dicarlantoniooctavio-create/carpinteria-vortex/README.md

# Vortex · Instalación eléctrica de una carpintería

Proyecto final: la instalación eléctrica de un taller de carpintería de 312 m², hecha por la empresa Vortex.

**Página web del proyecto:** https://dicarlantoniooctavio-create.github.io/carpinteria-vortex/PRINCIPAL/04_Web/index.html

**Página de la empresa:** https://dicarlantoniooctavio-create.github.io/carpinteria-vortex/PRINCIPAL/08_Web_Empresa/index.html

## Qué hay en cada carpeta

| Carpeta | Contenido |
|---|---|
| `PRINCIPAL/04_Web/` | La página web del proyecto |
| `PRINCIPAL/08_Web_Empresa/` | La página web de la empresa |
| `PRINCIPAL/05_Presentacion/` | Presentación animada (abrir el `.html` en el navegador) |
| `PRINCIPAL/02_Informe_Integrador/` | Informe técnico en PDF y Word |
| `PRINCIPAL/06_Planillas/` | Planillas de cálculo (Excel) |
| `PRINCIPAL/01_Proyecto_Organizado/` | Planos, cálculos y tableros (multifilares, topográficos y unifilar) |
| `PRINCIPAL/07_Video_Vortex_15s/` | Video de presentación de 15 s |
| `tableros.electricos/` | Unifilar y multifilar del equipo (AutoCAD), topográficos de CADe SIMU (tableros y automatismo) |
| `planos/` | Plano del local y unifilar en AutoCAD |
| `excels.important/` | Planillas originales del equipo |
| `3D.chonchons.beta/` | Modelo 3D de la lijadora de banda: versión nueva en FreeCAD (`freecad/`) y la primera en SolidWorks (`Solid/`) |

## Datos principales

- Alimentación 3 × 380 / 220 V + N, cable 4 × 35 mm² + PE 16 mm², general GE Hti 4P 80 A en el T.P.
- **T.S. Oficina** (entrada 4P 25 A): TUE1 aire en R; IUG1 y TUG1 en S.
- **T.S. Taller** (entrada GE Hti 4P 80 A, línea 4 × 35 mm²): TUE2 compresor en R; IUG2 en S; IUG3 y TUG2 en T; seis máquinas de 380 V detrás de un diferencial 4P 63 A, cada una con su térmica 4P.
- Fases con todo andando: R 61,56 A · S 63,11 A · T 62,19 A. DPMS 41.029 VA.
- Presupuesto: USD 15.419,83 con IVA (precios de referencia).
