dicarlantoniooctavio-create/carpinteria-vortex/PRINCIPAL/README.md

# Entrega final — Carpintería Industrial (Vortex)

La copia del proyecto reúne el informe técnico, perfil de empresa, web, presentación, planillas y video.

## Datos actualizados

- Alimentación 3 × 380/220 V + N; interruptor general GE Hti 4P 80 A curva C 6 kA. Línea al T.S. Taller: 4 × 35 mm² + PE 16 mm² (Iz 96 A).
- T.S. Oficina: entrada 4P 25 A. TUE1 aire acondicionado, fase R, 10 A; IUG1 fase S, 1,38 A y 4 A; TUG1 fase S, 14,55 A y 16 A.
- T.S. Taller: entrada GE Hti 4P 80 A. IUG2 6 A, IUG3 6 A, TUG2 tomas del taller, TUE2 compresor 2 (8,47 A).
- Máquinas trifásicas: 43,09 A por fase. Compresor 1 calculado en 11,02 A; guardamotor 9–14 A, pendiente de confirmar con placa.
- Fases: R 61,56 A; S 63,11 A; T 62,19 A. DPMS 41.029 VA; IMS 63,11 A.
- Lijadora: 4.754 × 919 × 2.220 mm; ruedas Ø600 × 150 mm, entre ejes 4.000 mm; banda 150 mm y 9.885 mm de desarrollo, 25,5 m/s; motor 4 HP (3 kW), 4 gatos de 2,5 t y chumaceras UCP212.
- Presupuesto final: materiales USD 8.397,80; mano de obra USD 2.939,23; ingeniería USD 839,78; imprevistos USD 566,85; IVA USD 2.676,17; total USD 15.419,83. Contado: USD 14.648,84. Anticipo 40 %: USD 6.167,93; dos hitos de 30 %: USD 4.625,95 cada uno. Plan en cuotas: anticipo USD 4.625,95 y seis cuotas de USD 1.942,90; total financiado USD 16.283,35.
