dicarlantoniooctavio-create/carpinteria-vortex/PRINCIPAL/01_Proyecto_Organizado/automatizacion/README.md

# Automatización de Máquinas



Lógica de mando y control de la máquina: arranque directo de un motor trifásico con enclavamiento, mediante contactor comandado por pulsadores de marcha y paro, más protección térmica.

## Topográficos nuevos (noviembre 2026)

El equipo rehizo el automatismo en dos topográficos de CADe SIMU, en `esquemas/`:

| Archivo | Motor | Componentes |
|---|---|---|
| `topograficoMonofasico.cad` (imagen `automatismo_monofasico.png`) | Monofásico (U1, V1, PE) | Q1, Q2, KM1, F1, S1 parada, S2 marcha, H1, bornera X |
| `topograficoTrifasico.cad` (imagen `automatismo_trifasico.png`) | Trifásico (U1, V1, W1, PE) | Q1, Q2, KM1, F1, S1 parada, S2 marcha, H1, bornera X |

Los dos son un arranque directo con autorretención: S2 energiza KM1, su contacto auxiliar lo mantiene, S1 lo corta y F1 (95-96) abre el mando si el motor se sobrecarga. Lo que sigue es la versión anterior.

## Archivos 

| Archivo | Contenido | Estado |
|---|---|---|
| `Automatismo.cad` (CADe SIMU) | Esquema de **mando** (circuito de control) y **potencia** (circuito de fuerza) del arranque directo. [Ver](https://github.com/Tpskevin13/carpinteria/releases/tag/Automatismo)|  Revisado y correcto |
| `Topografico.cad` (CADe SIMU) | Vista topográfica: disposición física de los componentes en el tablero.  [Ver](https://github.com/Tpskevin13/carpinteria/releases/tag/Topografico) |  Revisado y correcto |

> Los `.cad` son archivos de proyecto de CADe SIMU. Las imágenes exportadas (BMP/PNG) permiten que cualquiera vea el esquema sin instalar el programa.

## Circuito de mando (control)

- **`-Q`**: guardamotor/disyuntor — protección del circuito de mando.
- **`-E`**: contacto NC del relé térmico/guardamotor — corta el circuito si el motor se sobrecarga.
- **`-P`**: botón de **paro** (NC), en serie.
- **`-S`**: botón de **marcha** (NA), en paralelo con el contacto auxiliar 13-14 de `-K` (enclavamiento/retención: una vez que arranca, se mantiene solo aunque se suelte el botón).
- **`-K`**: bobina del contactor (A1-A2).

Orden de la lógica: protección → paro → marcha con enclavamiento → bobina. Correcto.

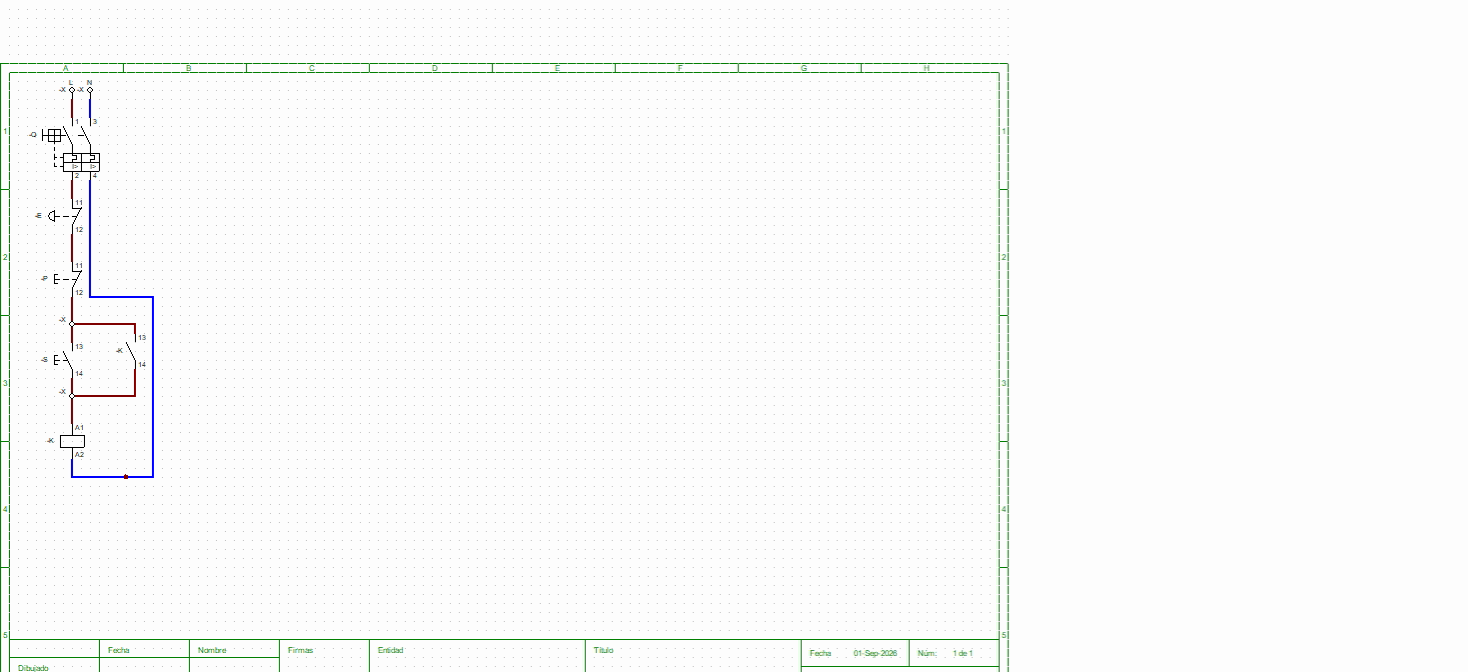
[picture p1: PRINCIPAL/01_Proyecto_Organizado/automatizacion/esquemas/CircutoDeMando.png]
Foto de referencia.


[Ver](https://github.com/Tpskevin13/carpinteria/releases/tag/CircuitoDeMando)

## Circuito de potencia (fuerza)

- **`-Q`** (guardamotor, 3 polos) → **`-K`** (contactos principales del contactor, 3 polos) → motor (**U1, V1, W1, PE**).

El guardamotor es un único dispositivo físico: sus contactos de potencia (3 polos) van en el circuito de fuerza, y su contacto auxiliar NC (`-E`) va en el circuito de mando.

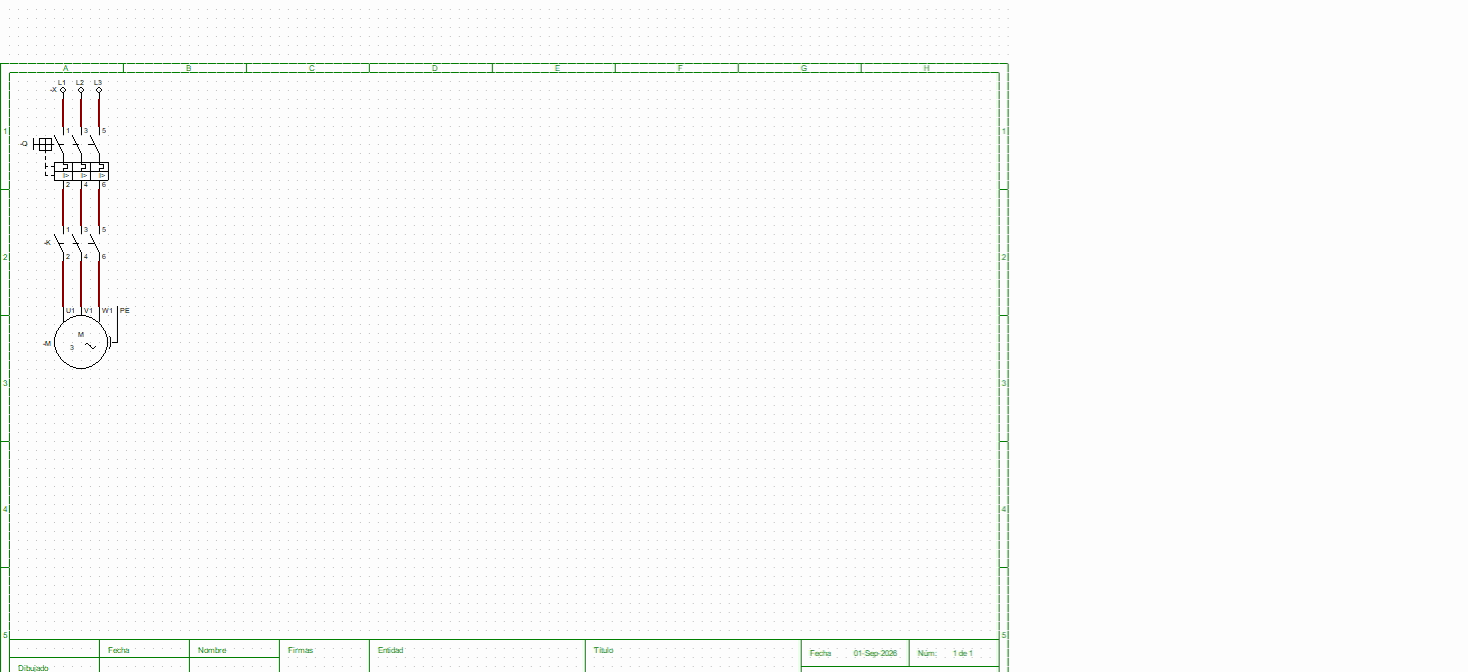
[picture p2: PRINCIPAL/01_Proyecto_Organizado/referencias/fotos/Circuitodepotencia.png]
Foto de referncia.


[Ver](https://github.com/Tpskevin13/carpinteria/releases/tag/CircuitoDePotencia)
