dicarlantoniooctavio-create/carpinteria-vortex/PRINCIPAL/01_Proyecto_Organizado/iluminacion/README.md

# Iluminación

Diseño lumínico del taller: cálculo de la cantidad de luminarias necesarias según la normativa/nivel de lux recomendado para trabajo de carpintería, y su distribución en planta.

## Contenido a subir

- **`calculos/`**
  - Método de los lúmenes (o el que definan): superficie del local, nivel de iluminancia (lux) requerido para taller de carpintería, flujo luminoso de la luminaria elegida, factor de mantenimiento y utilización → cantidad de luminarias.
  - Justificar el nivel de lux elegido (suele haber tablas de referencia según tipo de tarea: zona de máquinas necesita más lux que zonas de circulación/depósito).
- **`planos/`**
  - Distribución de luminarias en planta (separación entre ellas, altura de montaje).
  - Circuito eléctrico de iluminación (a qué llave térmica del tablero corresponde — vincular con `instalacion-electrica/`).

## Qué definimos

- Superficie: 312 m² en total; la carpintería ocupa 12 × 21 = 252 m².
- Luminarias: 19 campanas LED IP65 de 100 W (9000 lm) en el taller, 7 paneles LED de 40 W en negocio y oficina y 2 lámparas LED de 12 W en cocina y baño: 28 bocas en el plano.
- Circuitos: IUG1 (T.S. Oficina, 304 W, 1,38 A, térmica GE G62C04 de 4 A) e IUG2 / IUG3 (T.S. Taller, 9 y 10 campanas de 100 W: 4,09 A y 4,55 A, térmica GE G62C06 de 6 A).
