dicarlantoniooctavio-create/carpinteria-vortex/PRINCIPAL/01_Proyecto_Organizado/tablero/README.md

# Tablero Eléctrico

Diseño del tablero general (y seccionales si corresponde) que alimenta a toda la carpintería: máquinas, iluminación y tomacorrientes.

## Contenido a subir

- **`planos/`**
  - Plano unifilar del tablero (interruptor general, térmicas/diferenciales por circuito).
  - Distribución física dentro del gabinete (dónde va cada elemento).
- `memoria-tablero.md`:
  - Interruptor termomagnético general (calibre según la potencia total instalada — sale de `instalacion-electrica/`).
  - Interruptor diferencial (protección de personas).
  - Una llave térmica por circuito: una o más para máquinas (fuerza motriz), una para iluminación, una para tomas de uso general.
  - Marca/modelo de referencia de los elementos elegidos (Schneider, ABB, Siemens, etc. — lo que usen de referencia).

## Relación con otras carpetas

- Las corrientes y calibres salen del cálculo en [`instalacion-electrica/calculos`](../instalacion-electrica/calculos).
- El circuito de mando de la máquina automatizada (contactor, pulsadores) se conecta a través de una de las llaves térmicas de este tablero — documentarlo en [`automatizacion/`](../automatizacion).

## Qué definimos

- 7 circuitos de 220 V y 6 máquinas de 380 V.
- Un tablero principal (T.P., general GE Hti 4P 80 A) y dos seccionales: T.S. Oficina (entrada G64C25) y T.S. Taller (entrada GE Hti 4P 80 A, diferencial BPC463 para las máquinas).
- El mando de cada máquina es un arranque directo: ver los topográficos de `automatizacion/esquemas/` (motor monofásico y trifásico). `planos/tablero.maquinas.esim` es la versión vieja del simulador.
