dicarlantoniooctavio-create/carpinteria-vortex/2-proyecto-por-area/referencias/recursos/README.md

# Layout, Dimensiones e Instalación Eléctrica - Carpintería

## 1. Dimensiones Generales y Resumen de Superficie
* **Largo total:** 12.00 m
* **Ancho total:** 10.00 m
* **Altura libre útil:** 4.00 m (recomendado para manipulación de tableros enteros)
* **Superficie total:** **120.00 m²**

---

## 2. Distribución de Áreas y Zonificación

| Zona / Área | Dimensiones (m) | Superficie (m²) | Descripción y Equipamiento Principal |
| :--- | :--- | :--- | :--- |
| **Corte y Maquinaria Pesada** | 8.00 x 5.00 | 40.00 m² | Escuadradora, tupí, garlopa, cepilladora, sierra de cinta |
| **Banco de Trabajo y Ensamblado** | 6.00 x 5.00 | 30.00 m² | Bancos de carpintero, ensamblado de estructuras, prensas |
| **Lijado y Preparación** | 3.00 x 5.00 | 15.00 m² | Lijadoras orbitales, lijadora de banda, calibradora |
| **Acabado y Barnizado** | 3.00 x 5.00 | 15.00 m² | Cabina de pintura con extracción e iluminación anti-explosiva |
| **Almacén de Madera / Tableros** | 4.00 x 3.00 | 12.00 m² | Estanterías cantiléver para tableros (2.75 x 1.83 m) y listones |
| **Oficina y Sanitario** | 4.00 x 2.00 | 8.00 m² | Control administrativo, baño y vestuario de personal |

---

## 3. Requerimientos de Instalación Eléctrica

### Suministro y Potencia General
* **Acometida:** Trifásica (380V + Neutro + Tierra / 50 Hz).
* **Potencia estimativa contratada:** 15 a 22 kW (para absorber picos de arranque de motores trifásicos simultáneos).
* **Puesta a Tierra (PAT):** Jabalina de cobre de 2.40 m con cable de protección verde/amarillo (mínimo 10 mm²) independiente para descargar electricidad estática de la viruta.

### Tablero General de Distribución (TGD)
* Interruptor General Automático (IGA) con corte omnipolar.
* Disyuntores diferenciales de alta sensibilidad (30 mA) por cada sector.
* Guardamotor / Térmicas individuales calibradas para cada máquina pesada.
* Contactor de maniobra interconectado con circuito de paradas de emergencia.

### Tomas de Fuerza Motriz (380V Trifásico)
* **Escuadradora:** Toma industrial 3P+N+T 16A (Motor ~5.5 HP / 4 kW).
* **Garlopa / Cepilladora:** Toma industrial 3P+N+T 16A (Motor ~4 HP / 3 kW).
* **Tupí de banco:** Toma industrial 3P+N+T 16A (Motor ~4 HP / 3 kW).
* **Aspirador Central de Polvo / Viruta:** Circuito directo trifásico (Motor ~5.5 HP / 4 kW) con encendido automático en paralelo a la máquina en uso.

### Tomas Monofásicas (220V - Herramientas Manuales)
* **Bajadas Aéreas (Techo):** 6 tomacorrientes colgantes reforzados tipo "retráctil" sobre la zona de bancos para mantener el suelo libre de cables.
* **Tomas Perimetrales IP54:** Tomas dobles estancas con tapa a 1.20 m del suelo, distribuidas cada 3 metros en las paredes del taller.

### Iluminación y Seguridad
* **Iluminación General Taller:** Campanas o herméticos LED IP65 (500 lux requeridos en área de corte y bancos; 300 lux en depósitos).
* **Zona de Acabado/Barnizado:** Envolventes y luminarias antideflagrantes (Atex) para polvos y vapores de solventes inflamables.
* **Seguridad:** 4 pulsadores tipo "seta" de parada de emergencia distribuidos en paredes, interconectados a la bobina de disparo del tablero general.
