dicarlantoniooctavio-create/carpinteria-vortex/PRINCIPAL/01_Proyecto_Organizado/docs/README.md

# Documentación General

- `memoria-descriptiva.md`: qué es la carpintería, alcance del proyecto, objetivos.
- `cronograma.md`: tareas, responsables y fechas de entrega de cada etapa.
- `presentacion-final.md` o `.pdf`: material para la defensa/exposición del proyecto.
