dicarlantoniooctavio-create/carpinteria-vortex/PRINCIPAL/06_Planillas/FUNCIONAMIENTO MAQUINAS.docx

LIJADORA DE BANDA

Funcionamiento: La lijadora de banda es una máquina herramienta que funciona con un motor eléctrico que hace girar dos rodillos. Estos mueven una banda de lija de forma continua. Al apoyar la pieza sobre la banda en movimiento, el material se desgasta por fricción, lo que permite desbastar, alisar y quitar rebabas o imperfecciones en piezas de madera o metal.

ESCUADRADORA

Funcionamiento: Es una máquina herramienta que utiliza un disco de sierra circular accionado por un motor eléctrico para cortar madera en línea recta. La pieza se apoya sobre una mesa y se guía el material mediante una regla o guía para realizar cortes precisos, rectos y en ángulo. Se utiliza principalmente para cortar tableros y piezas de madera a las medidas deseadas.

SIERRA SIN FIN

Funcionamiento: Es una máquina herramienta que funciona mediante una cinta metálica dentada y continua, que se desplaza alrededor de dos volantes accionados por un motor eléctrico. Los dientes de la cinta cortan el material al entrar en contacto con el. Se utiliza para realizar cortes rectos y curvos en madera o metal, según el tipo de máquina y hoja.

SIERRA COMBINADA

Funcionamiento: La sierra combinada es una máquina herramienta que combina dos sistemas de corte, generalmente una sierra circular y una sierra sin fin. Funciona mediante un motor eléctrico que acciona el mecanismo de corte. Se utiliza para realizar diferentes tipos de cortes en madera, como cortes rectos y curvos, según el sistema utilizado.

TUPI

Funcionamiento: La tupi es una máquina herramienta utilizada principalmente para trabajar la madera. Funciona mediante un motor eléctrico que hace girar un eje con una herramienta de corte a gran velocidad. La pieza se desplaza de forma controlada contra la herramienta, que elimina material y le da la forma deseada. Se utiliza para realizar ranuras, molduras, rebajes y dar forma a los bordes de las piezas.
