dicarlantoniooctavio-create/carpinteria-vortex/PRINCIPAL/01_Proyecto_Organizado/empresa/README.md

# Vortex

<p align="center">
  Logo TKVK Bordado
</p>

## ¿Quiénes somos?

Vortex es una empresa de servicios técnicos especializada en **instalaciones eléctricas, automatismo y seguridad de máquinas**, además de **mantenimiento de instalaciones y máquinas**. Este repositorio documenta un proyecto estudiantil aplicado a un caso real: una carpintería, donde Vortex interviene diseñando su instalación eléctrica, el automatismo de una de sus máquinas y su iluminación.

## Equipo

| Integrante | Rol en el proyecto |
|---|---|
| Kevin Dibella |Técnico especialista en instalaciones eléctricad.|
| Octavio Di Carlantonio |Marketing. |
| Lucio Di Carlantonio |técnico en mantenimiento eh higiene.|
| Agustín Duarte |Diseñador Gráfico y modelado 3D.|

## Rubro y servicios

- Instalaciones eléctricas (industriales/comerciales).
- Automatismo de máquinas y procesos.
- Seguridad de máquinas (paradas de emergencia, protecciones, resguardos).
- Mantenimiento de instalaciones eléctricas y de máquinas.

## Misión y visión

- **Misión:** Vortex nace como una empresa creada específicamente para este proyecto estudiantil de la carpintería, con el objetivo de aplicar en un caso real los conocimientos de instalaciones eléctricas, automatismo y seguridad de máquinas del equipo.
- **Visión:** Terminar este proyecto de forma correcta y prolija, convirtiéndolo en una de las mejores entregas posibles, y sentar las bases para que el mismo equipo de integrantes pueda encarar juntos otros proyectos en el futuro.
