dicarlantoniooctavio-create/carpinteria-vortex/PRINCIPAL/01_Proyecto_Organizado/docs/cronograma.md

# Cronograma del Proyecto

| Etapa | Tarea | Responsable | Estado |
|---|---|---|---|
| 1 | Definir máquina a modelar y relevar datos | Agustín Duarte | ☑️ Lijadora de banda |
| 2 | Cálculo de instalación eléctrica (potencias, conductores, protecciones) | Kevin Dibella | ☑️ Informe cap. 5 |
| 3 | Modelado 3D (SolidWorks y después FreeCAD) | Agustín Duarte | ☑️ Lijadora de banda larga: 27 piezas en FreeCAD |
| 4 | Esquema de automatización (fuerza + mando) | Kevin Dibella + Octavio Di Carlantonio | ☑️ |
| 5 | Cálculo lumínico y plano de iluminación | Lucio Di Carlantonio | ☑️ Informe cap. 5.1 |
| 6 | Integración de todos los planos en la memoria final | Equipo | ☑️ Informe_Carpinteria_Vortex.pdf |
| 7 | Preparación de la presentación/defensa | Octavio Di Carlantonio | ☑️ Presentacion_Carpinteria_Vortex.html |
| 8 | Plano eléctrico definitivo en planta | Kevin Dibella | ☑️ Plano del taller en AutoCAD |
| 9 | Plano de despiece con medidas y materiales | Agustín Duarte | ☑️ Despiece_Lijadora.pdf (lámina A3) y Despiece_Lijadora.dwg (vistas acotadas) |
| 10 | Topográficos de los tableros | Equipo | ☑️ CADe SIMU |
