dicarlantoniooctavio-create/carpinteria-vortex/PRINCIPAL/01_Proyecto_Organizado/docs/memoria-descriptiva.md

# Memoria Descriptiva

## 1. Introducción
[Contexto del proyecto: por qué eligieron una carpintería, qué representa este trabajo dentro de la materia/carrera.]

## 2. Objetivos
- Objetivo general.
- Objetivos específicos (uno por cada área: eléctrica, 3D, automatización, iluminación).

## 3. Descripción de la carpintería
[Tamaño del taller, máquinas que tiene, cantidad de personal, tipo de trabajo que realiza — desarrollo completo en `empresa/`]

## 4. Alcance del proyecto
[Qué partes reales de una carpintería cubre este trabajo y qué queda fuera de alcance.]

## 5. Desarrollo por área
### 5.1 La empresa
[Resumen — remite a `empresa/`]

### 5.2 Instalación eléctrica
[Resumen — remite a `instalacion-electrica/`]

### 5.3 Tablero eléctrico
[Resumen — remite a `tablero/`]

### 5.4 Tuberías
[Resumen — remite a `tuberias/`]

### 5.5 Modelado 3D
[Resumen — remite a `modelado-3d/`]

### 5.6 Automatización
[Resumen — remite a `automatizacion/`]

### 5.7 Iluminación
[Resumen — remite a `iluminacion/`]

## 6. Conclusiones
[Qué aprendieron, dificultades encontradas, posibles mejoras futuras.]
