dicarlantoniooctavio-create/carpinteria-vortex/1-entrega/video/renders/capturas/08_12.1s.png

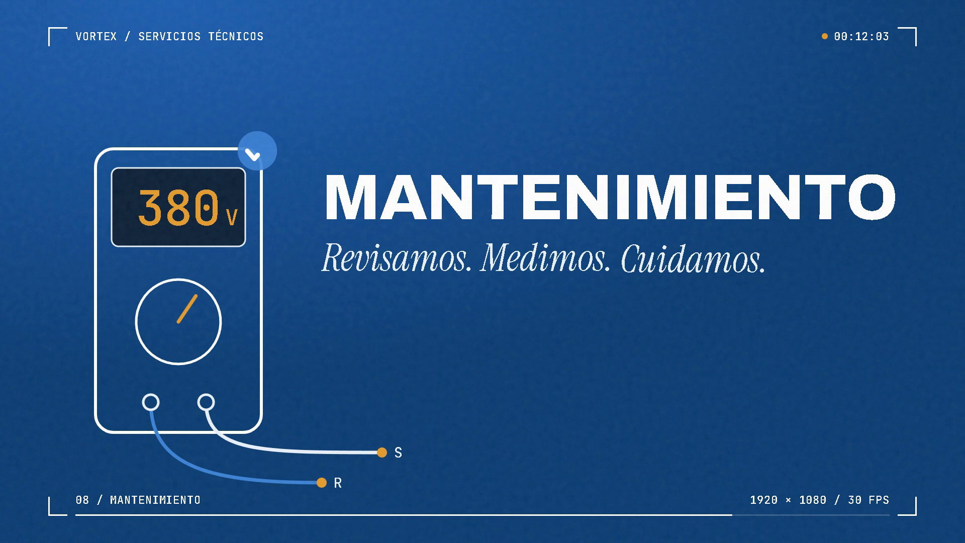
1-entrega/video/renders/capturas/08_12.1s.png
