dicarlantoniooctavio-create/carpinteria-vortex/1-entrega/video/renders/capturas/hoja_contacto.jpg

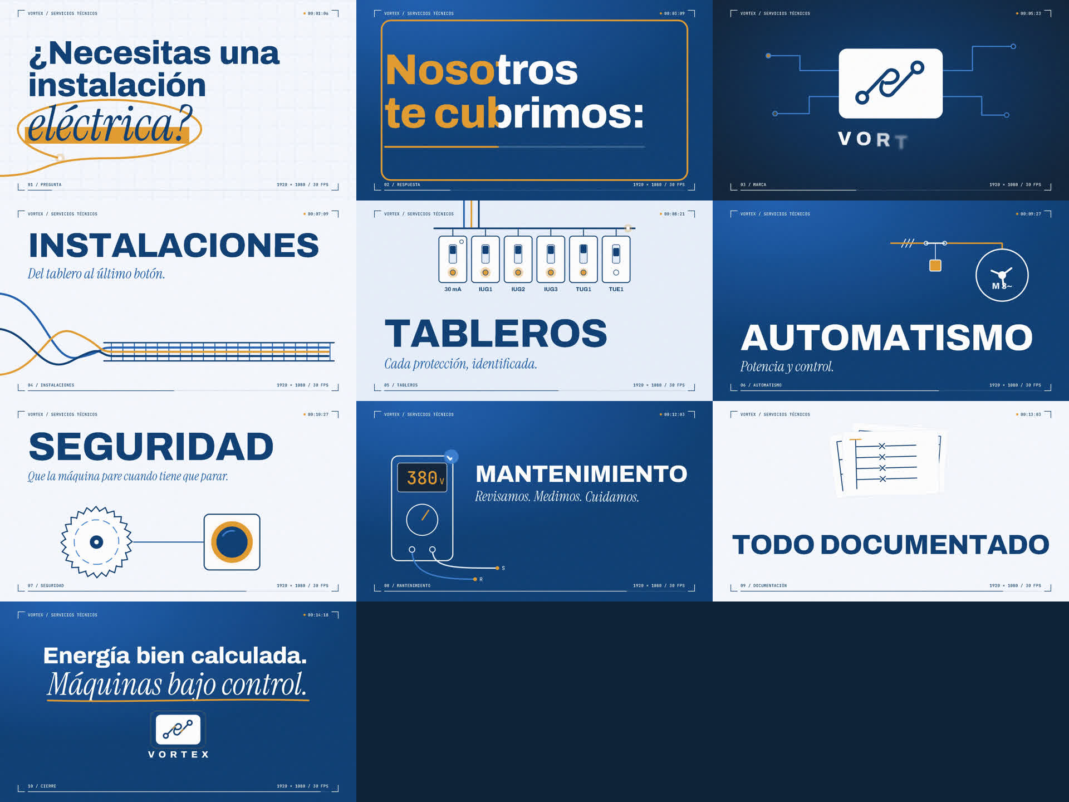
1-entrega/video/renders/capturas/hoja_contacto.jpg
