dicarlantoniooctavio-create/carpinteria-vortex/PRINCIPAL/01_Proyecto_Organizado/automatizacion/esquemas/automatismo_monofasico.png

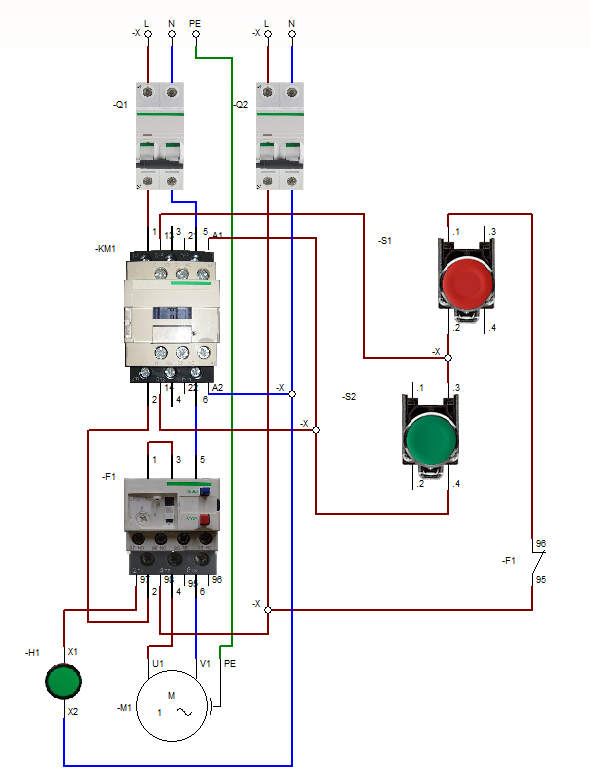
PRINCIPAL/01_Proyecto_Organizado/automatizacion/esquemas/automatismo_monofasico.png
