dicarlantoniooctavio-create/carpinteria-vortex/PRINCIPAL/01_Proyecto_Organizado/instalacion-electrica/tableros/imagenes/tablero_automatismo.png

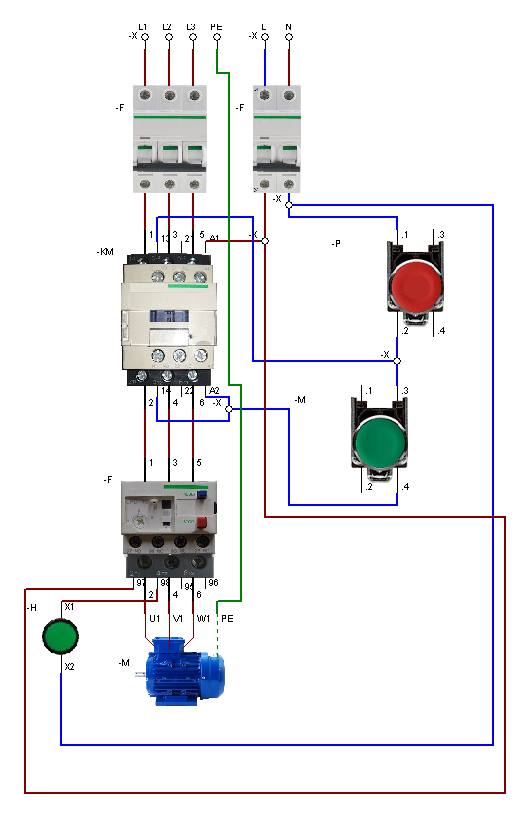
PRINCIPAL/01_Proyecto_Organizado/instalacion-electrica/tableros/imagenes/tablero_automatismo.png
