dicarlantoniooctavio-create/carpinteria-vortex/PRINCIPAL/01_Proyecto_Organizado/instalacion-electrica/tableros/imagenes/topografico_oficina.png

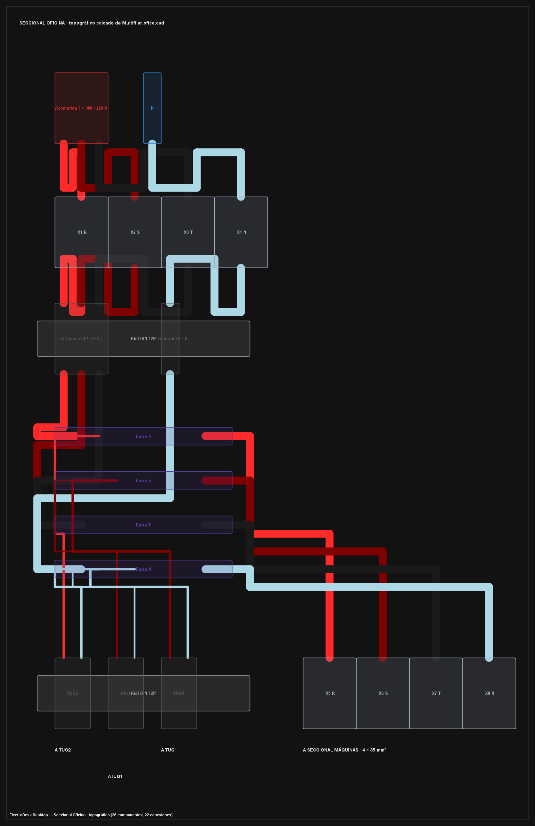
PRINCIPAL/01_Proyecto_Organizado/instalacion-electrica/tableros/imagenes/topografico_oficina.png
