dicarlantoniooctavio-create/carpinteria-vortex/PRINCIPAL/01_Proyecto_Organizado/modelado-3d/planos/despiece_lijadora.png

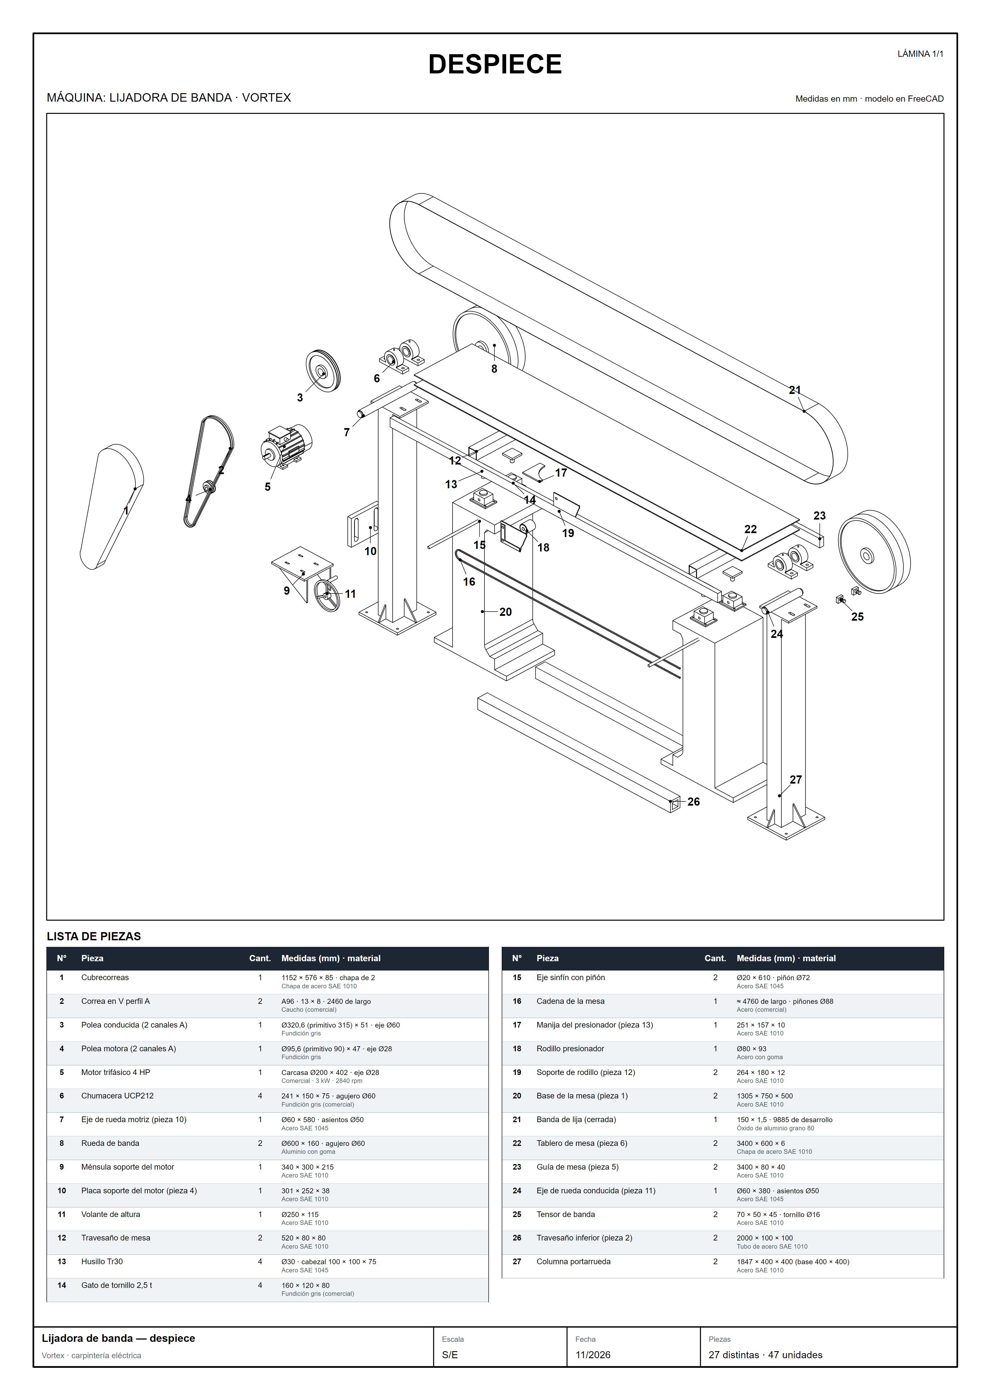
PRINCIPAL/01_Proyecto_Organizado/modelado-3d/planos/despiece_lijadora.png
