dicarlantoniooctavio-create/carpinteria-vortex/PRINCIPAL/01_Proyecto_Organizado/modelado-3d/renders/correa.chocomelli.png

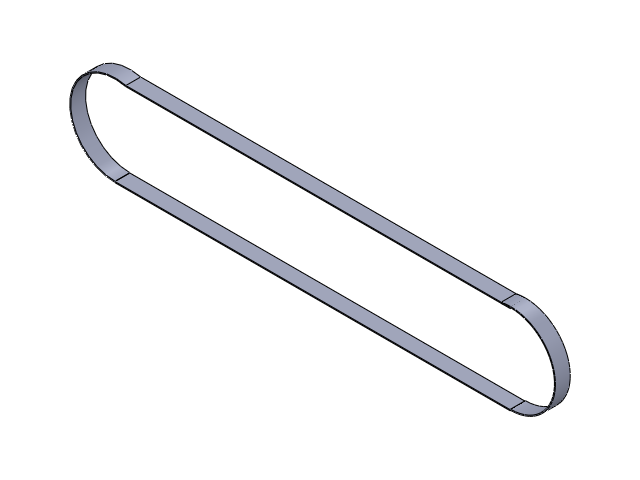
PRINCIPAL/01_Proyecto_Organizado/modelado-3d/renders/correa.chocomelli.png
