dicarlantoniooctavio-create/carpinteria-vortex/PRINCIPAL/01_Proyecto_Organizado/modelado-3d/renders/lijadora_planta.png

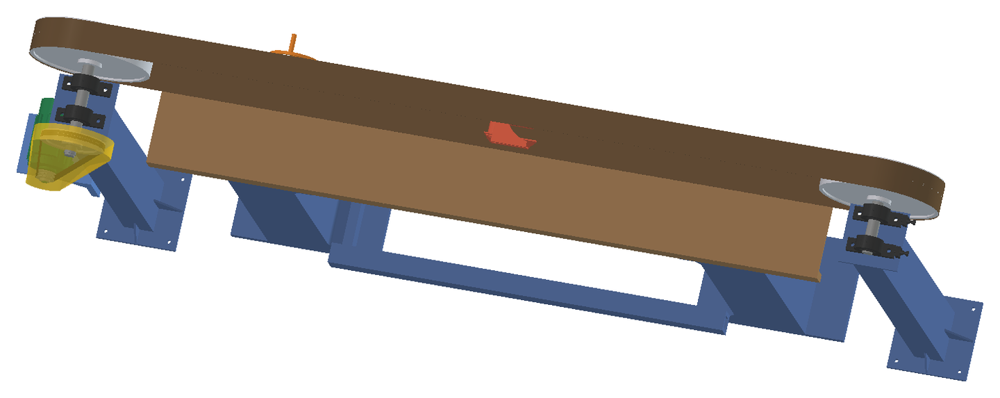
PRINCIPAL/01_Proyecto_Organizado/modelado-3d/renders/lijadora_planta.png
