dicarlantoniooctavio-create/carpinteria-vortex/PRINCIPAL/01_Proyecto_Organizado/modelado-3d/renders/pieza5.png

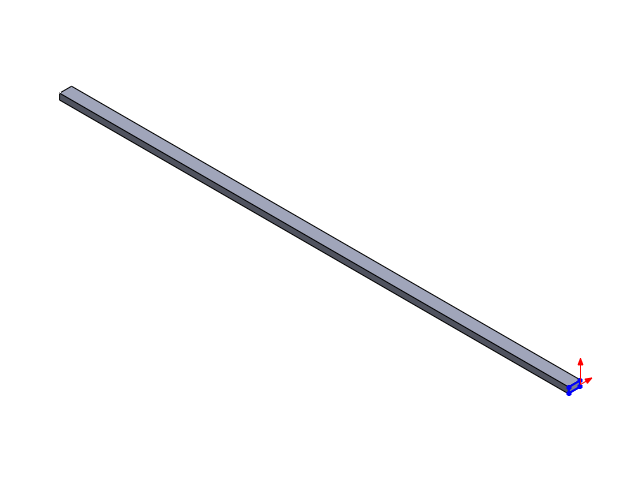
PRINCIPAL/01_Proyecto_Organizado/modelado-3d/renders/pieza5.png
