dicarlantoniooctavio-create/carpinteria-vortex/PRINCIPAL/01_Proyecto_Organizado/modelado-3d/renders/version_solidworks/pieza11_eje_trasero.png

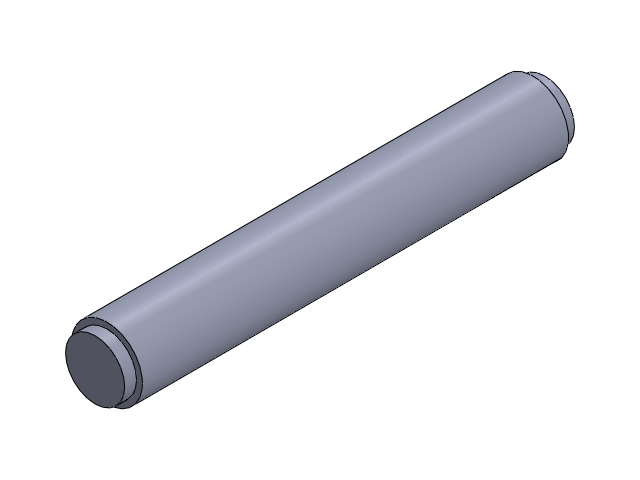
PRINCIPAL/01_Proyecto_Organizado/modelado-3d/renders/version_solidworks/pieza11_eje_trasero.png
