dicarlantoniooctavio-create/carpinteria-vortex/PRINCIPAL/01_Proyecto_Organizado/tablero/planos/tablero.maquinas (vista).png

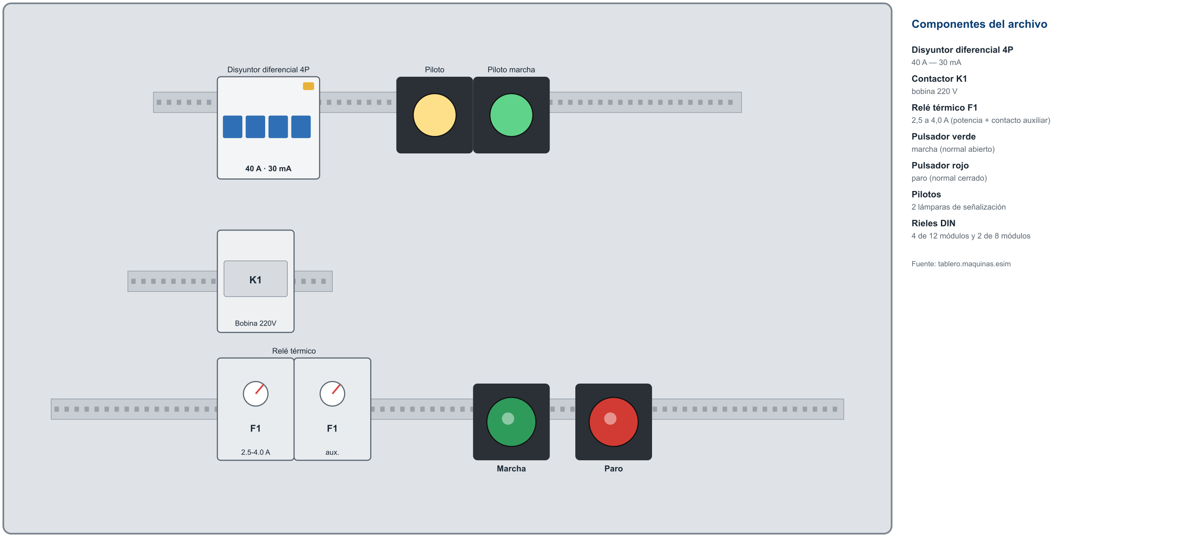
PRINCIPAL/01_Proyecto_Organizado/tablero/planos/tablero.maquinas (vista).png
