dicarlantoniooctavio-create/carpinteria-vortex/PRINCIPAL/04_Web/img/despiece_lijadora.png

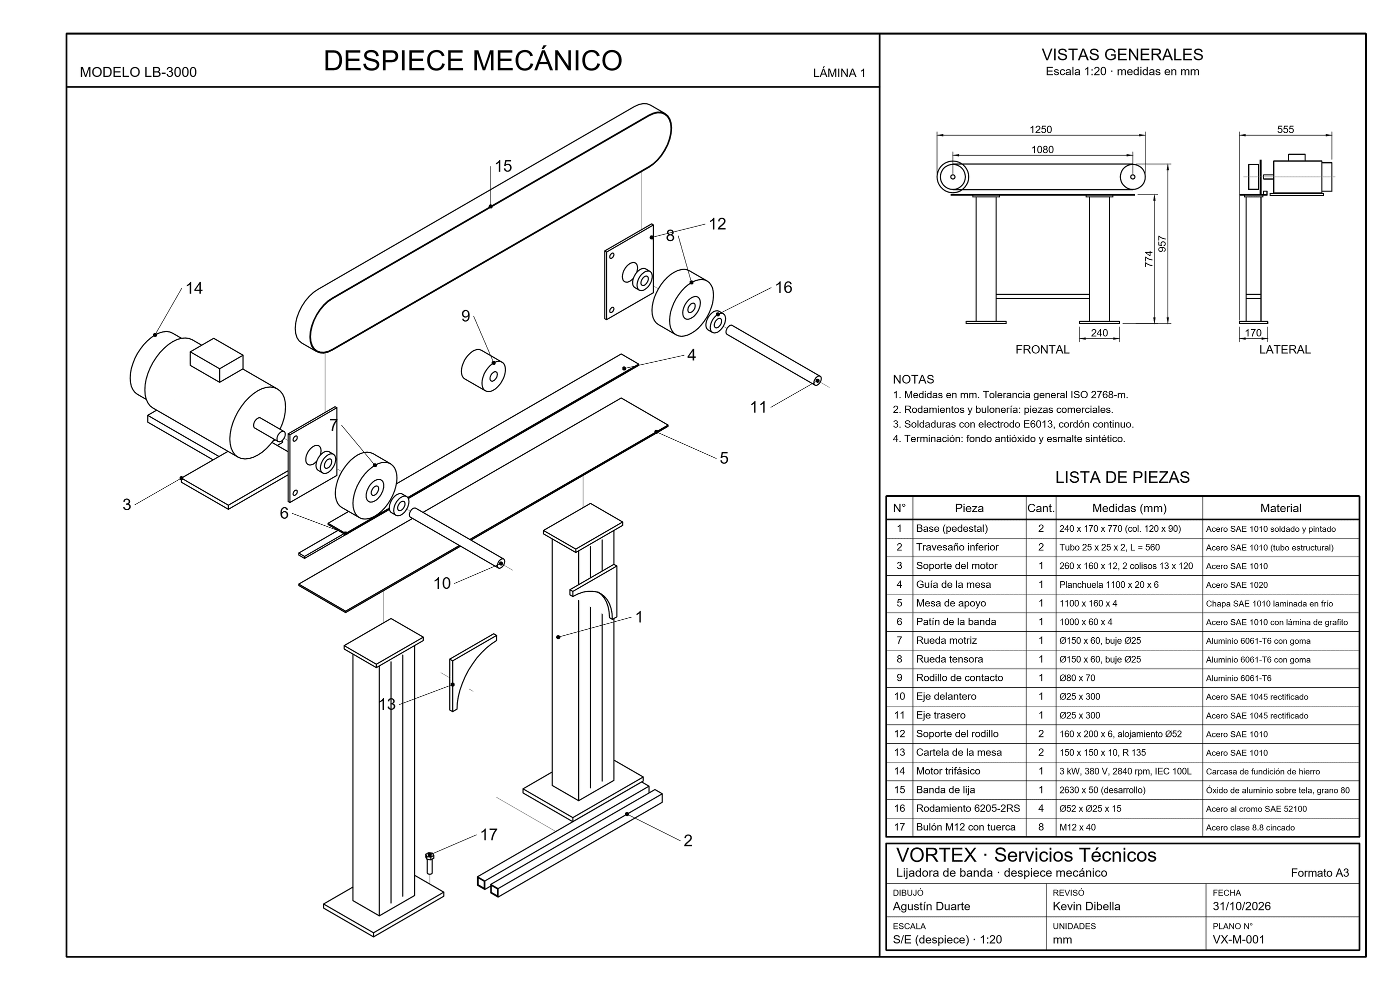
PRINCIPAL/04_Web/img/despiece_lijadora.png
