dicarlantoniooctavio-create/carpinteria-vortex/PRINCIPAL/04_Web/img/lijadora/despiece_vista.png

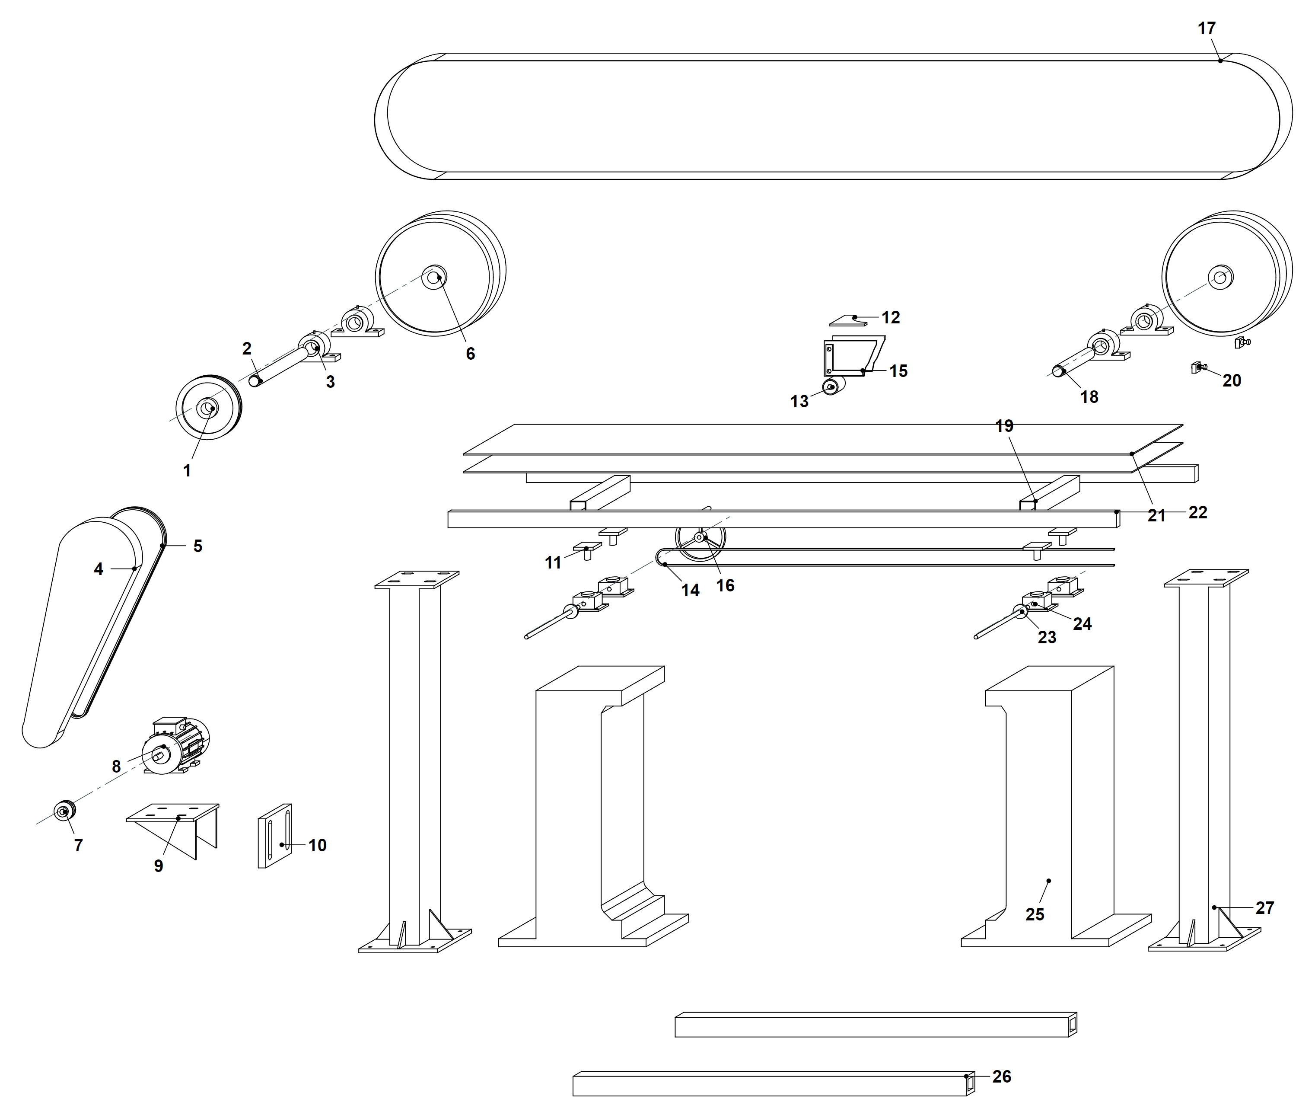
PRINCIPAL/04_Web/img/lijadora/despiece_vista.png
