dicarlantoniooctavio-create/carpinteria-vortex/PRINCIPAL/04_Web/img/lijadora/despiece_vistas.png

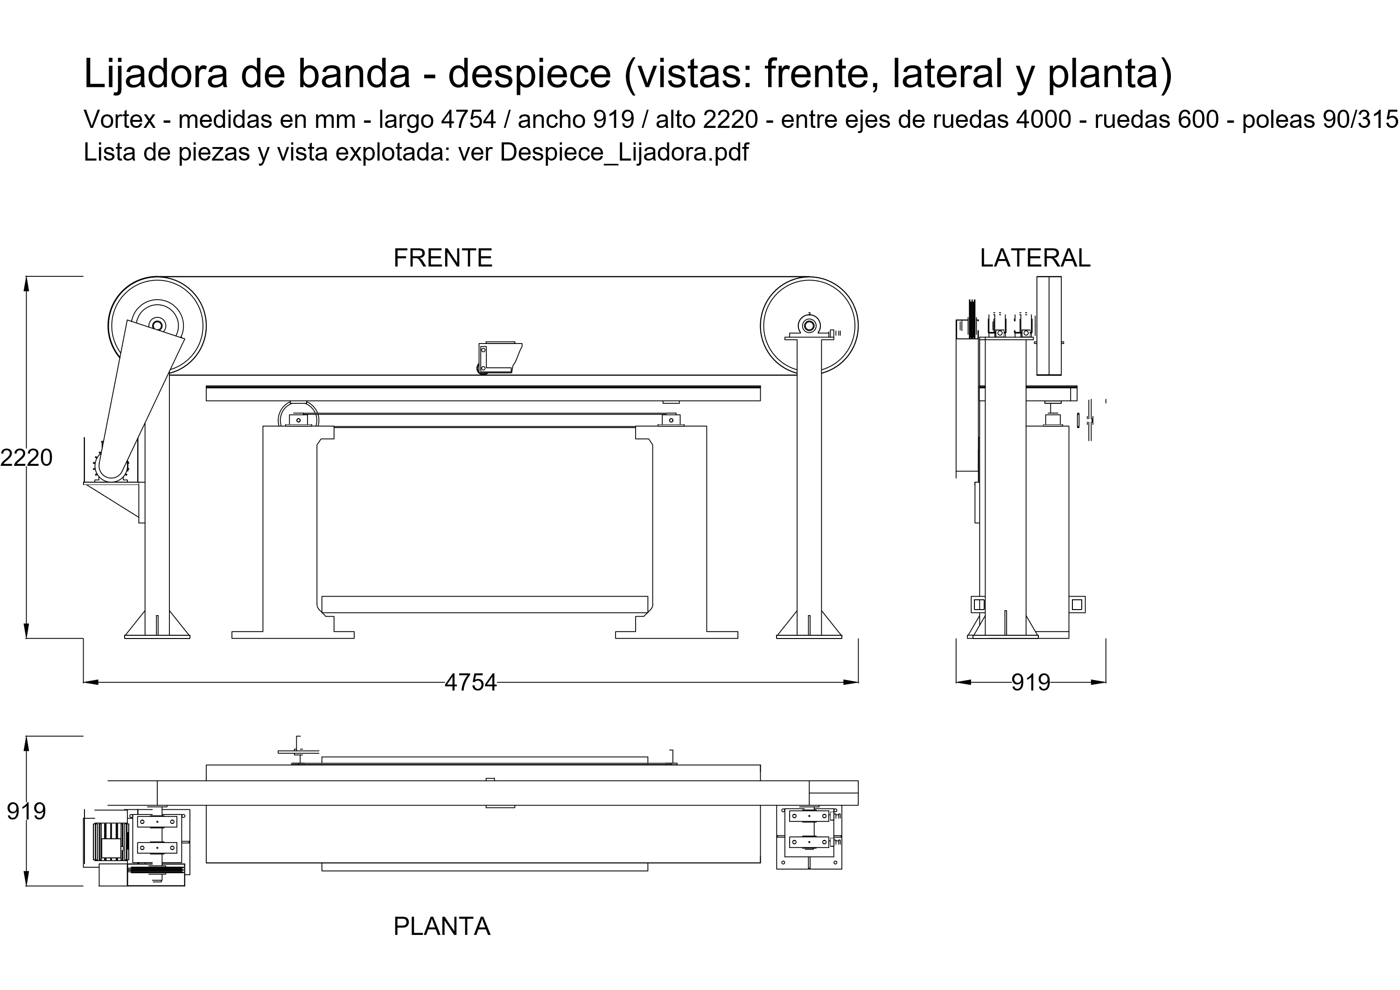
PRINCIPAL/04_Web/img/lijadora/despiece_vistas.png
