dicarlantoniooctavio-create/carpinteria-vortex/PRINCIPAL/04_Web/img/lijadora/lijadora_explosion.png

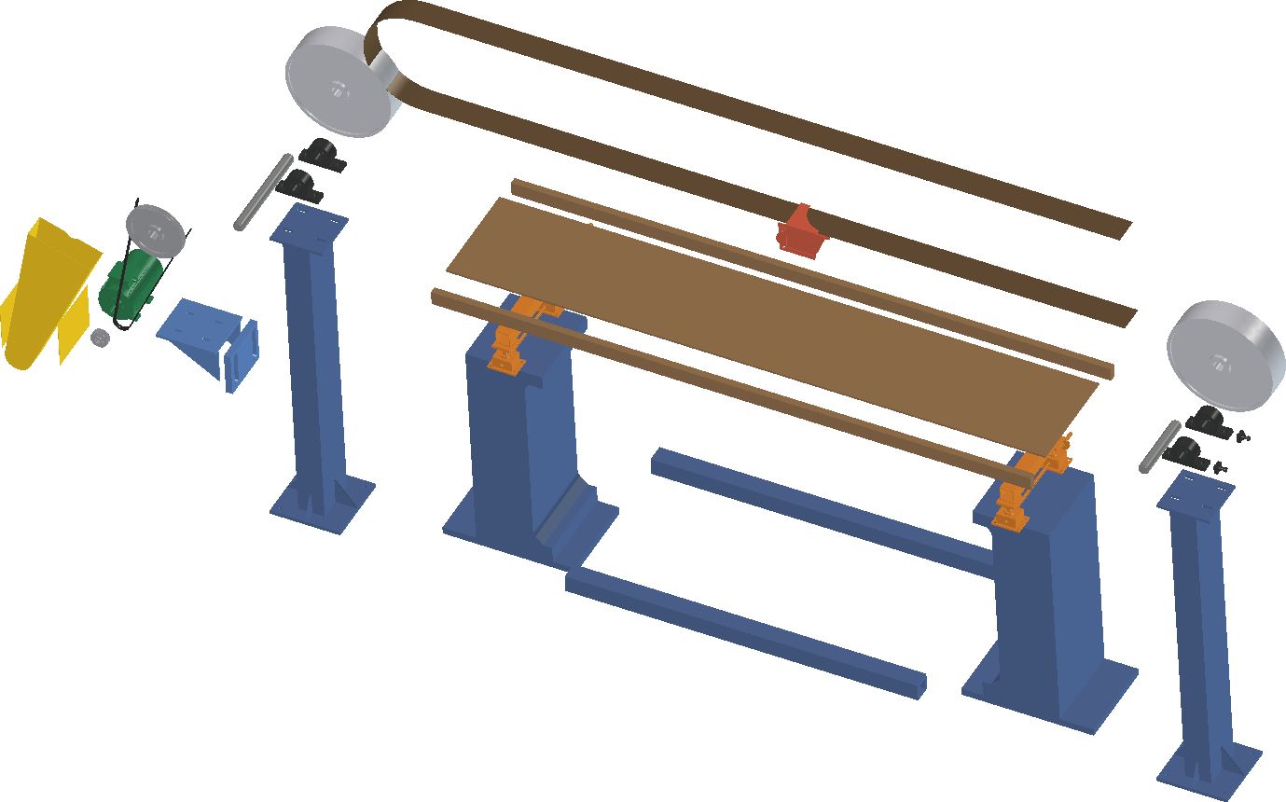
PRINCIPAL/04_Web/img/lijadora/lijadora_explosion.png
