dicarlantoniooctavio-create/carpinteria-vortex/PRINCIPAL/04_Web/img/lijadora/lijadora_frente.png

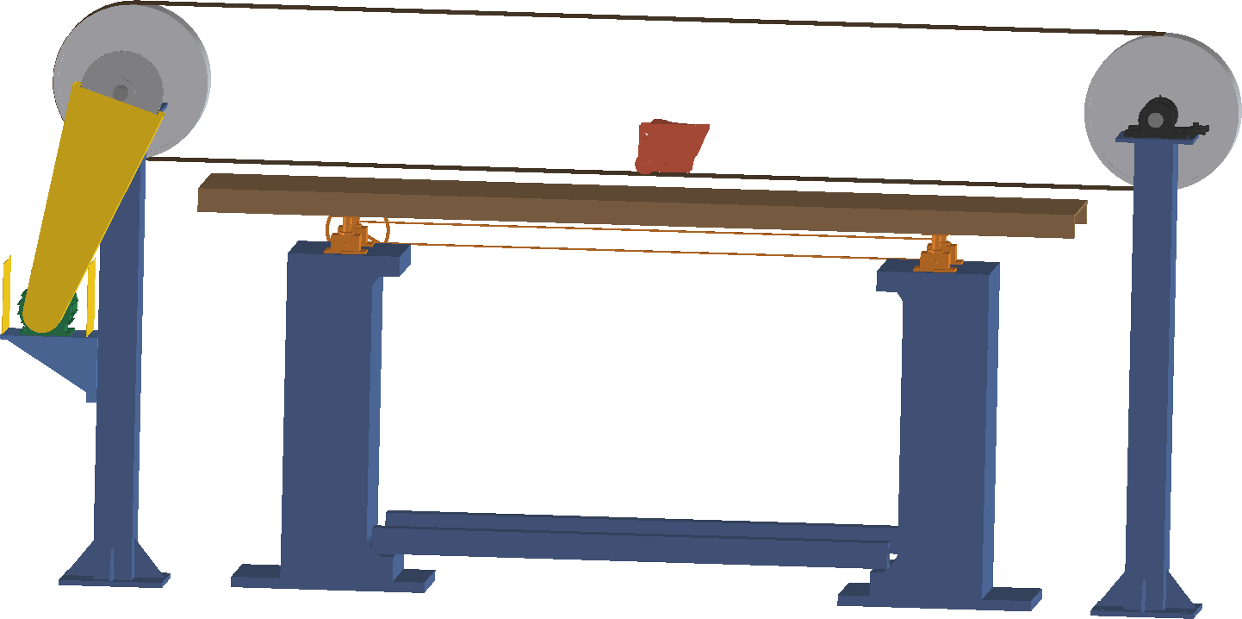
PRINCIPAL/04_Web/img/lijadora/lijadora_frente.png
