dicarlantoniooctavio-create/carpinteria-vortex/PRINCIPAL/04_Web/img/lijadora/lijadora_iso.png

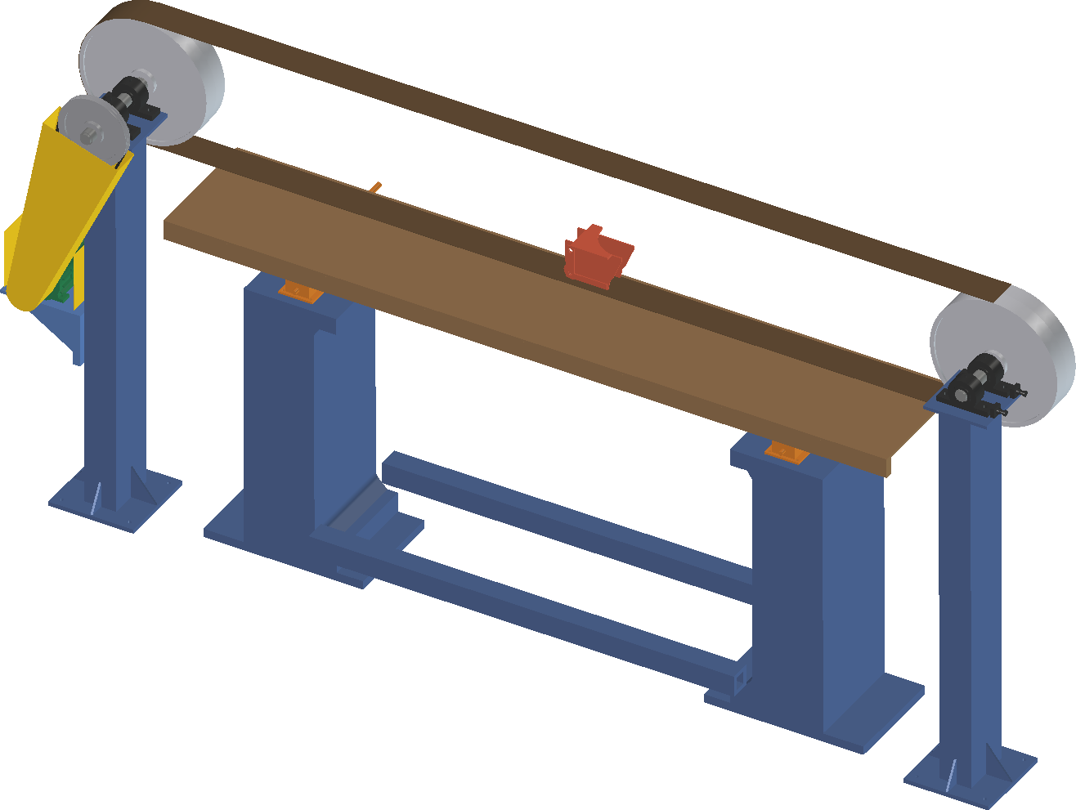
PRINCIPAL/04_Web/img/lijadora/lijadora_iso.png
