dicarlantoniooctavio-create/carpinteria-vortex/PRINCIPAL/04_Web/img/lijadora/lijadora_lateral.png

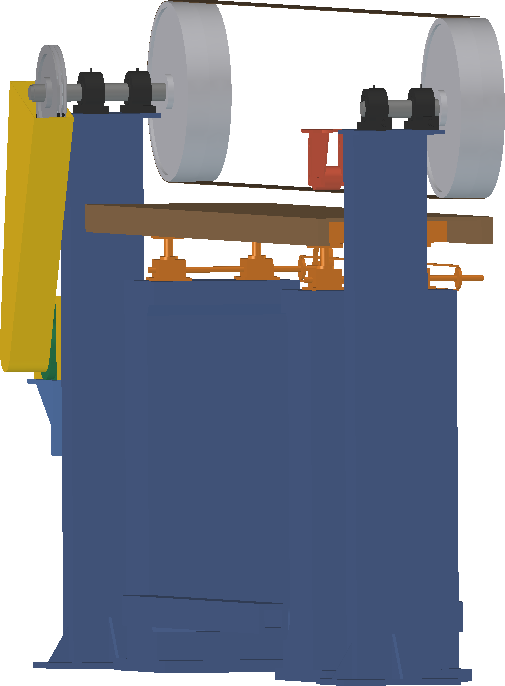
PRINCIPAL/04_Web/img/lijadora/lijadora_lateral.png
