dicarlantoniooctavio-create/carpinteria-vortex/PRINCIPAL/04_Web/img/plano_equipo.png

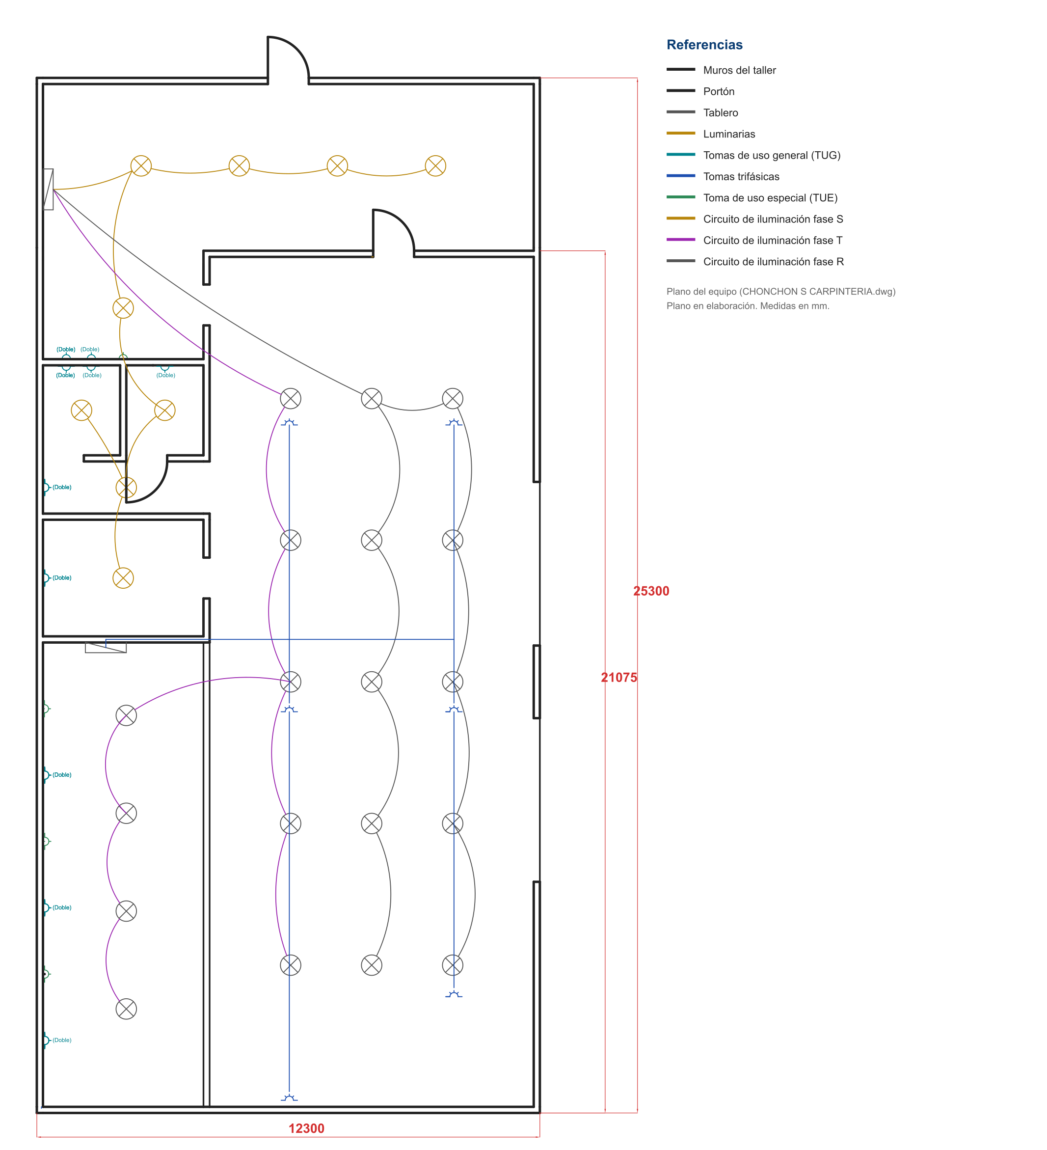
PRINCIPAL/04_Web/img/plano_equipo.png
