dicarlantoniooctavio-create/carpinteria-vortex/PRINCIPAL/04_Web/img/tableros/unifilar.png

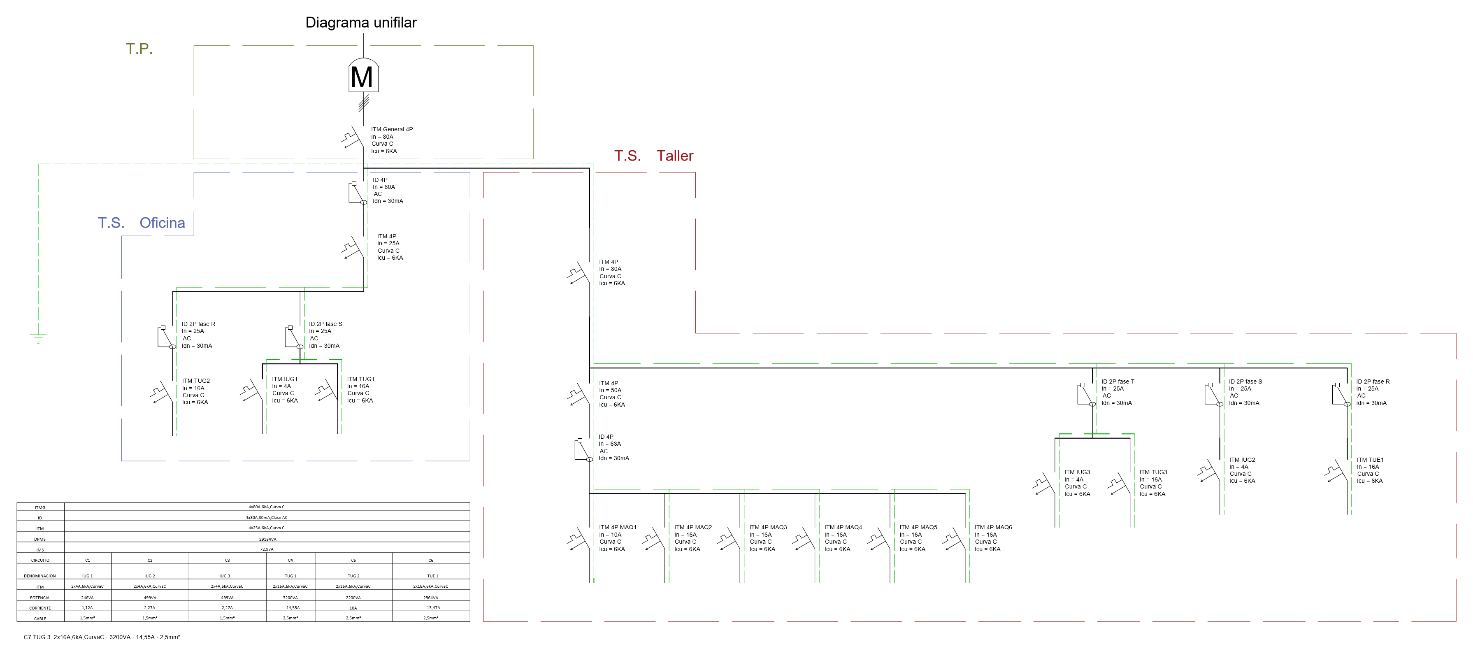
PRINCIPAL/04_Web/img/tableros/unifilar.png
