dicarlantoniooctavio-create/carpinteria-vortex/PRINCIPAL/07_Video_Vortex_15s/renders/capturas/02_3.3s.png

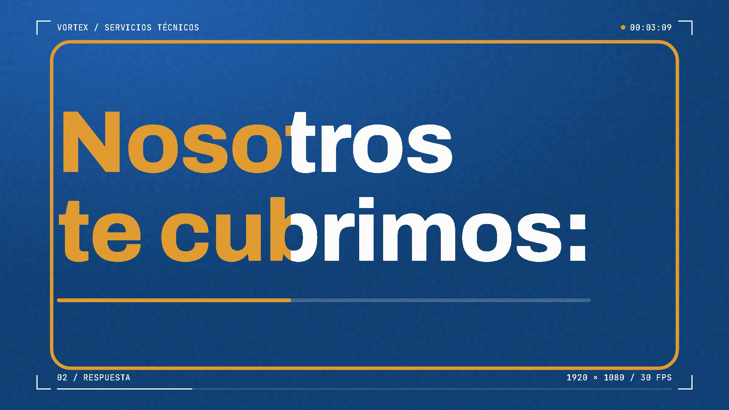
PRINCIPAL/07_Video_Vortex_15s/renders/capturas/02_3.3s.png
