dicarlantoniooctavio-create/carpinteria-vortex/PRINCIPAL/07_Video_Vortex_15s/renders/capturas/03_5.75s.png

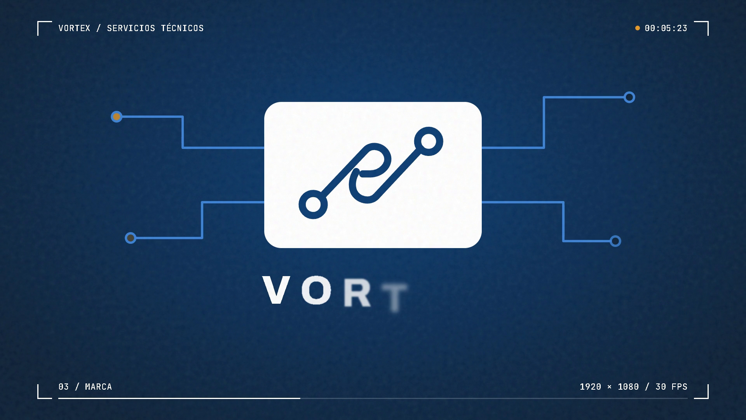
PRINCIPAL/07_Video_Vortex_15s/renders/capturas/03_5.75s.png
