dicarlantoniooctavio-create/carpinteria-vortex/PRINCIPAL/07_Video_Vortex_15s/renders/capturas/04_7.3s.png

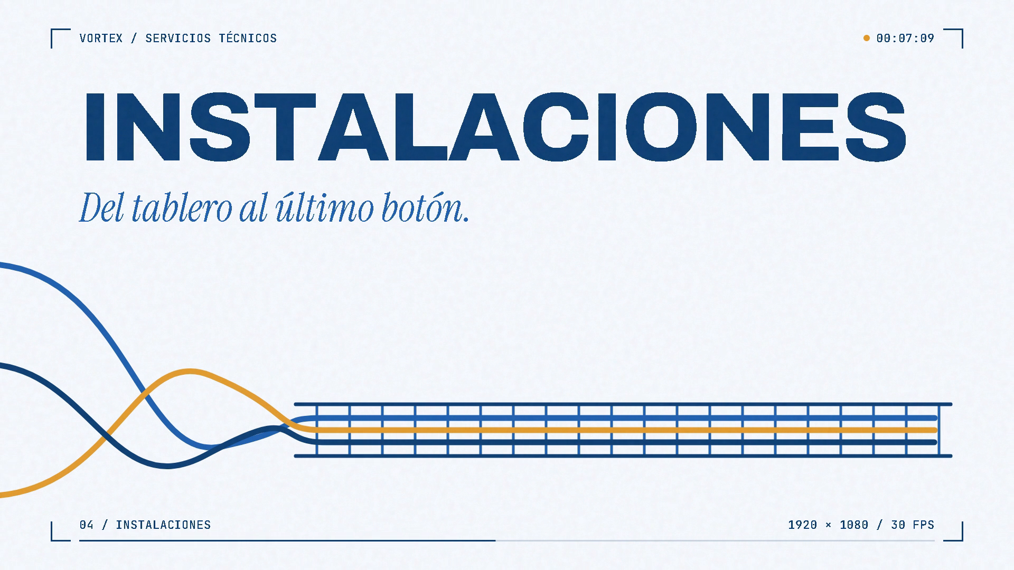
PRINCIPAL/07_Video_Vortex_15s/renders/capturas/04_7.3s.png
