dicarlantoniooctavio-create/carpinteria-vortex/PRINCIPAL/07_Video_Vortex_15s/renders/capturas/05_8.7s.png

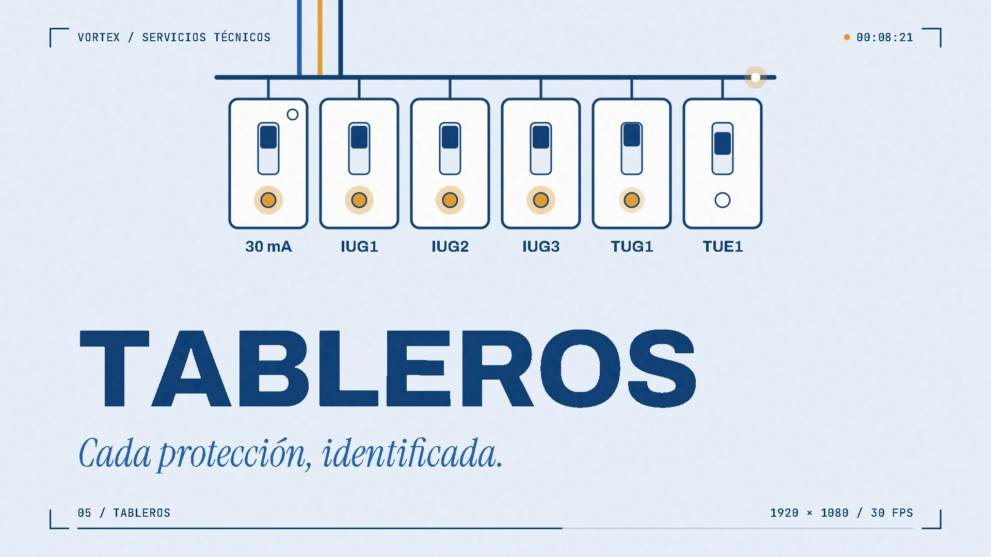
PRINCIPAL/07_Video_Vortex_15s/renders/capturas/05_8.7s.png
