dicarlantoniooctavio-create/carpinteria-vortex/PRINCIPAL/07_Video_Vortex_15s/renders/capturas/06_9.9s.png

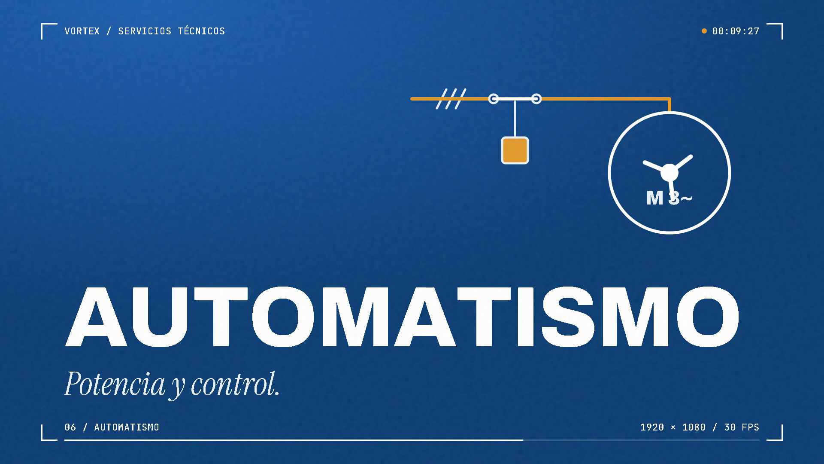
PRINCIPAL/07_Video_Vortex_15s/renders/capturas/06_9.9s.png
