dicarlantoniooctavio-create/carpinteria-vortex/PRINCIPAL/07_Video_Vortex_15s/renders/capturas/07_10.9s.png

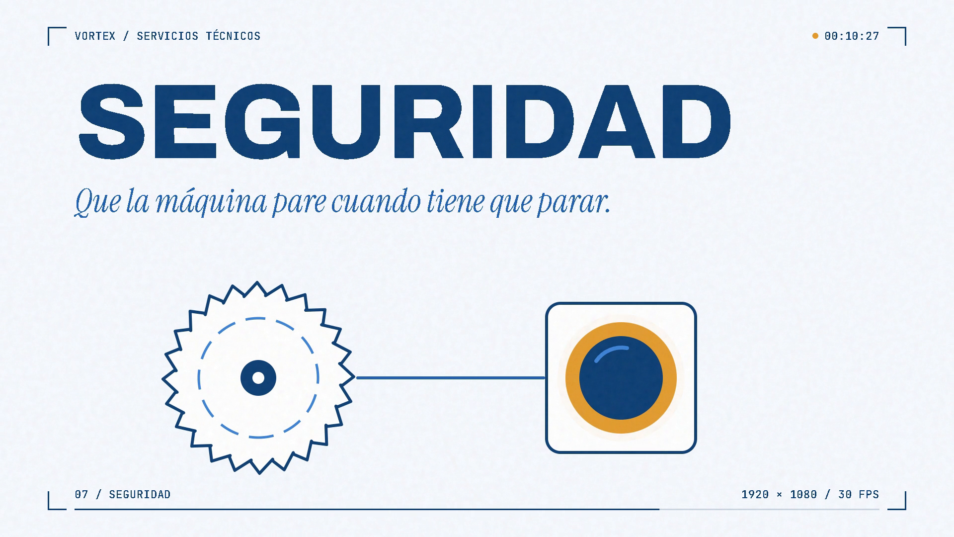
PRINCIPAL/07_Video_Vortex_15s/renders/capturas/07_10.9s.png
