dicarlantoniooctavio-create/carpinteria-vortex/PRINCIPAL/07_Video_Vortex_15s/renders/capturas/09_13.1s.png

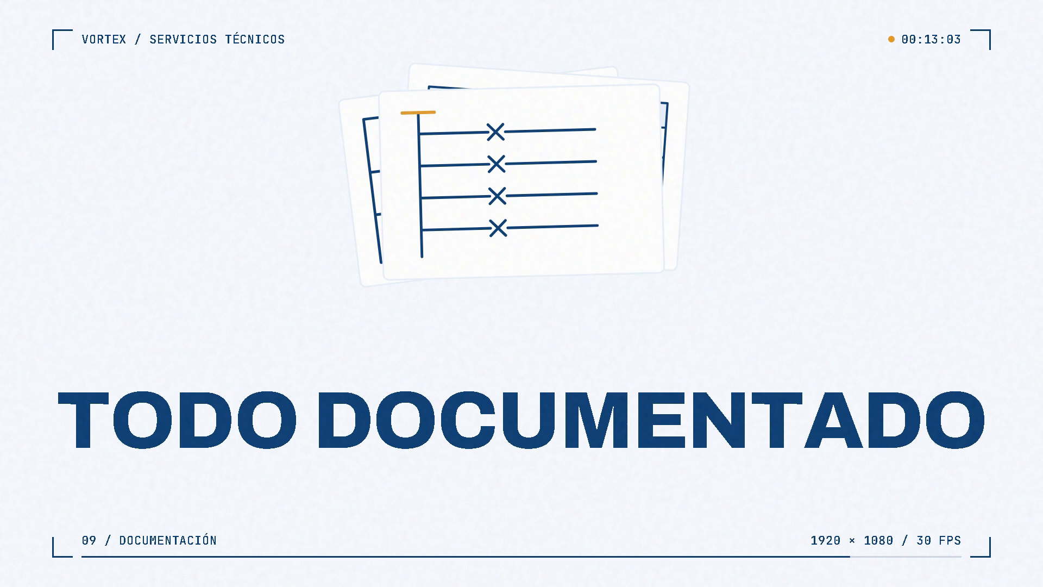
PRINCIPAL/07_Video_Vortex_15s/renders/capturas/09_13.1s.png
