dicarlantoniooctavio-create/carpinteria-vortex/PRINCIPAL/07_Video_Vortex_15s/renders/capturas/10_14.6s.png

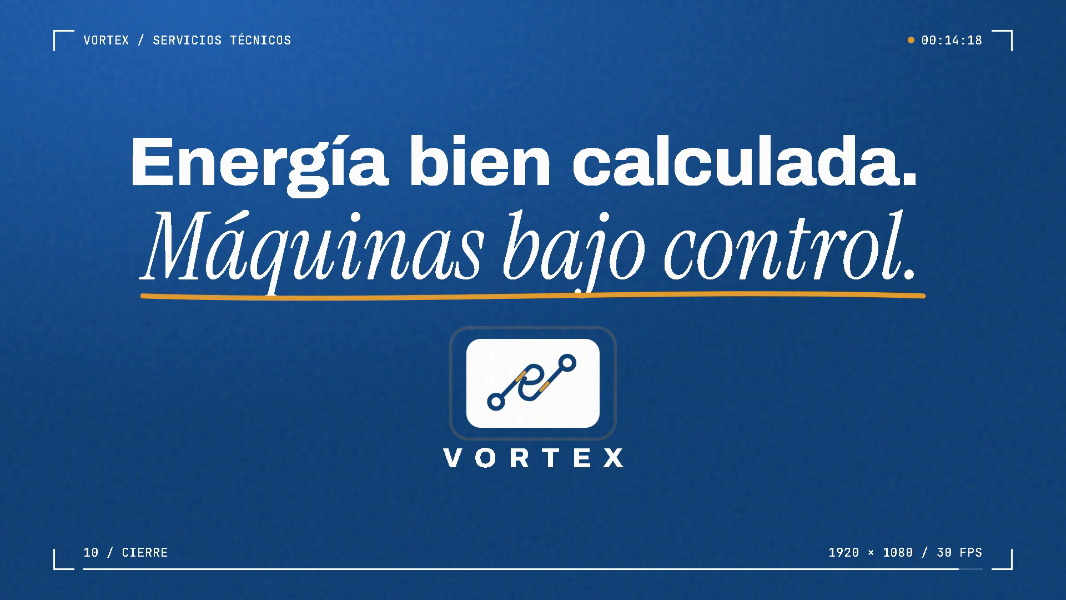
PRINCIPAL/07_Video_Vortex_15s/renders/capturas/10_14.6s.png
