dicarlantoniooctavio-create/carpinteria-vortex/PRINCIPAL/01_Proyecto_Organizado/instalacion-electrica/calculos/Planillas_Carpinteria_Vortex.xlsx

Sheet: IUG
Iluminación de uso general (IUG) — 220 V
Circuito | Ambiente | Tipo de lámpara | Cantidad | Potencia (W) | Lúmenes | Consumo (A)
IUG1 | Negocio, oficina, cocina y baño | 7 paneles LED 40 W + 2 LED 12 W | 9 | 304 |  | 1.38
IUG2 | Taller | Campanas LED IP65 100 W | 9 | 900 |  | 4.09
IUG3 | Taller | Campanas LED IP65 100 W | 10 | 1000 |  | 4.55
IUG1 | Total del circuito |  |  | 304 |  | 1.38
IUG2 | Total del circuito |  |  | 900 |  | 4.09
IUG3 | Total del circuito |  |  | 1000 |  | 4.55
Bocas contadas en el plano de AutoCAD (28 = 9 + 9 + 10). Consumo = potencia / 220 V. IUG1 en el Seccional Oficina (fase S), térmica 4 A; IUG2 (fase S) e IUG3 (fase T) en el Seccional Máquinas, térmica 10 A porque 4,55 A supera los 4 A.

Sheet: TUG
Tomacorrientes de uso general (TUG) — 220 V
Circuito | Carga | Tipo de carga | Potencia (W) | Consumo (A)
TUG1 y TUG3 | Sierra circular de banco | Herramienta 220 V | 2200 | 10.00
TUG1 y TUG3 | Fresadora de mano | Herramienta 220 V | 2200 | 10.00
TUG1 y TUG3 | Cepilladora | Herramienta 220 V | 2000 | 9.09
TUG1 y TUG3 | Sierra ingletadora | Herramienta 220 V | 2000 | 9.09
TUG1 y TUG3 | Garlopa de banco | Herramienta 220 V | 1500 | 6.82
TUG1 + TUG3 | Uso simultáneo | Las 3 más potentes a la vez: sierra circular + fresadora + cepilladora (6400 W), repartidas en TUG1 y TUG3 | 6400 | 29.09
TUG1 | Oficina y frente del taller (14 tomas) | La mitad (la oficina no se usa a la vez) | 3200 | 14.55
TUG3 | Fondo del taller (6 tomas) | La otra mitad | 3200 | 14.55
Un TUG no puede pasar de 20 A: los 29,09 A de los tomas del taller se reparten en TUG1 (Seccional Oficina, junto con los tomas de la oficina) y TUG3 (Seccional Máquinas).

Sheet: TUE
Tomacorriente de uso especial (TUE) — 220 V
Circuito | Carga | Tipo de carga | Potencia (W) | Consumo (A)
TUE1 | Aire acondicionado | Equipo 220 V · Seccional Oficina | 1100 | 5.00
TUE2 | Compresor 2 (monofásico) | Equipo 220 V · Seccional Máquinas | 1864 | 8.47
TUE1 + TUE2 | Total en fase R | Dos circuitos: aire acondicionado (TUE1) y compresor 2 (TUE2) | 2964 | 13.47

Sheet: Cañerías
Cañerías — caño de acero semipesado (ocupación máxima 35 %)
Tramo | Circuito | Conductores | Sección (mm²) | Ø cable (mm) | Caño | Ø interior caño (mm) | Ocupación (%)
Seccional Oficina → negocio y oficinas | IUG1 | 3 (F + N + PE) | 1.5 | 3.3 | CL16 (5/8") | 12.5 | 20.9
Seccional Oficina → oficina y tomas del frente del taller | TUG1 | 3 (F + N + PE) | 2.5 | 3.8 | CL16 (5/8") | 12.5 | 27.7
Medidor → Seccional Oficina | Alimentación | 5 (R + S + T + N + PE) | 35 | 10.9 | CL51 (2") | 45.0 | 29.3
Ocupación = suma de las secciones de los cables / sección interior del caño. Diámetros aproximados de catálogo: verificar con el fabricante.

Sheet: Cómputo
Cómputo de materiales y presupuesto (precios de referencia, USD)
Rubro | Material | Unidad | Cantidad | Precio unit. (USD) | Subtotal (USD)
Conductores | Cable unipolar IRAM NM 247-3 1,5 mm² (IUG1 y bajadas a las luces) | m | 160 | 0.32
Conductores | Cable subterráneo IRAM 2178 3 × 1,5 mm² (IUG2 e IUG3, por bandeja) | m | 80 | 1.60
Conductores | Cable unipolar IRAM NM 247-3 2,5 mm² (tierra de circuitos) | m | 160 | 0.45
Conductores | Cable unipolar IRAM NM 247-3 35 mm² (alimentación R, S, T y N) | m | 40 | 6.20
Conductores | Cable unipolar 16 mm² verde y amarillo (tierra de la alimentación) | m | 10 | 2.90
Conductores | Cable tetrapolar IRAM 2178 4 × 25 mm² (Seccional Oficina → Seccional Máquinas, por la bandeja) | m | 20 | 19.00
Conductores | Cable subterráneo IRAM 2178 3 × 2,5 mm² (TUE2 y TUG3, por bandeja) | m | 45 | 2.10
Conductores | Cable tetrapolar IRAM 2178 4 × 2,5 mm² (M1 a M6) | m | 100 | 2.60
Conductores | Cable unipolar 16 mm² verde y amarillo (tierra del Seccional Máquinas) | m | 14 | 2.90
Conductores | Cable verde y amarillo 16 mm² (jabalina → barra de tierra) | m | 10 | 2.90
Conductores | Cable unipolar IRAM NM 247-3 2,5 mm² (TUG1 y TUE1, en caño) | m | 60 | 0.45
Canalizaciones | Caño semipesado CL51 (2") × 3 m (alimentación) | u | 3 | 22.00
Canalizaciones | Caño semipesado CL16 y CL19 × 3 m | u | 55 | 6.50
Canalizaciones | Bandeja perforada 150×50 mm × 3 m (galv.): principal de 19,6 m + T de 8,1 m | u | 10 | 22.00
Canalizaciones | Curvas, uniones y soportes de bandeja | gl | 1 | 95.00
Canalizaciones | Cajas octogonales / rectangulares / de paso + accesorios | gl | 1 | 140.00
Tableros | Gabinete metálico IP65 36 módulos (Seccional Oficina) | u | 1 | 120.00
Tableros | Gabinete metálico IP65 600 × 400 (Seccional Máquinas) | u | 1 | 150.00
Tableros | Rieles DIN, borneras, peines, barra PE y señalización | gl | 1 | 90.00
Protecciones | Interruptor general termomagnético GE Hti104C080, 4P 80 A curva C 10 kA | u | 1 | 130.00
Protecciones | Termomagnético GE G64C63, 4P 63 A curva C 6 kA (salida al Seccional Máquinas) | u | 1 | 85.00
Protecciones | Termomagnético GE G64C25, 4P 25 A curva C 6 kA (entrada del Seccional Oficina) | u | 1 | 40.00
Protecciones | Disyuntor diferencial GE BPC463, 4P 63 A 30 mA (grupo de máquinas) | u | 1 | 140.00
Protecciones | Disyuntor diferencial GE BPC225, 2P 25 A 30 mA (R y S en el Seccional Oficina; R y S en el Seccional Máquinas) | u | 4 | 45.00
Protecciones | Disyuntor diferencial GE BPC240, 2P 40 A 30 mA (fase T del Seccional Máquinas: IUG3 + TUG3) | u | 1 | 50.00
Protecciones | Termomagnéticos GE 2P curva C 6 kA: G62C04 4 A (IUG1) y G62C10 10 A (IUG2 e IUG3) | u | 3 | 11.00
Protecciones | Termomagnético GE G62C16, 2P 16 A curva C 6 kA (TUG1, TUG3, TUE1 y TUE2) | u | 4 | 12.00
Protecciones | Termomagnético GE G64C10, 4P 10 A curva C 6 kA (salida al tablero de la lijadora) | u | 1 | 38.00
Protecciones | Termomagnético GE G64C16, 4P 16 A curva C 6 kA (salida a los tableros de combinada, escuadradora, tupí, sierra sin fin y compresor 1) | u | 5 | 38.00
Protecciones | Seccionador bajo carga 4P 100 A | u | 1 | 70.00
Protecciones | Termomagnético GE G62C06, 2P 6 A curva C 6 kA (circuito de mando) | u | 1 | 11.00
Protecciones | Descargador de sobretensión clase II 4P | u | 1 | 60.00
Maniobra | Guardamotor 6–10 A (lijadora, combinada y compresor 1) | u | 3 | 55.00
Maniobra | Guardamotor 4–6,3 A (escuadradora, tupí y sierra sin fin) | u | 3 | 52.00
Maniobra | Contactor 9 A AC-3 bobina 220 V (uno por máquina) | u | 6 | 35.00
Maniobra | Pulsadores marcha (NA verde) / paro (NC rojo) | par | 6 | 12.00
Maniobra | Pulsador de emergencia tipo seta Ø40 enclavable (4 en paredes + 1 por máquina) | u | 10 | 14.00
Maniobra | Pilotos LED 220 V (tensión / marcha) | u | 7 | 4.00
Tomas | Toma 2P+T 20 A (TUE1: aire acondicionado · TUE2: compresor 2) | u | 4 | 12.00
Tomas | Toma industrial 3P+N+T 16 A IP67 (máquinas trifásicas) | u | 6 | 25.00
Tomas | Toma doble estanca IP54 10 A con tapa (TUG1 y TUG3) | u | 10 | 9.00
Tomas | Bajada aérea retráctil 220 V reforzada | u | 6 | 45.00
Iluminación | Campana LED industrial IP65 100 W 9000 lm 6500 K | u | 19 | 55.00
Iluminación | Panel LED 40 W 4000 K (negocio y oficina) | u | 7 | 20.00
Iluminación | Lámpara LED 12 W (cocina y baño) | u | 2 | 8.00
Iluminación | Llaves de efecto y bocas de iluminación | gl | 1 | 60.00
Puesta a tierra | Jabalina Cu-acero 5/8" × 2,40 m + tomacable + cámara de inspección | u | 1 | 45.00
Lijadora de banda | Motor trifásico 3 kW 2840 rpm IP55 (B3), carcasa IEC 100L | u | 1 | 230.00
Lijadora de banda | Banda abrasiva de tela (grano 80/120) | u | 2 | 18.00
Lijadora de banda | Ruedas / tambores mecanizados (pzas. 8 y 9) | u | 2 | 60.00
Lijadora de banda | Ejes acero SAE 1045 (pzas. 10 y 11) | u | 2 | 25.00
Lijadora de banda | Rodamientos 6205-2RS + soportes UCP205 | u | 4 | 20.00
Lijadora de banda | Estructura: pedestales, travesaños, soporte motor y chapas (pzas. 1–7, 12, 13) | gl | 1 | 220.00
Lijadora de banda | Tornillería, pintura epoxi y resguardos | gl | 1 | 75.00
 | Materiales
 | Mano de obra (35 %)
 | Ingeniería (10 %)
 | Imprevistos (5 %)
 | IVA 21 %
 | TOTAL
