dicarlantoniooctavio-create/carpinteria-vortex/3D.chonchons.beta/freecad/ensamble/ensamble.finalchonchon.cut.step

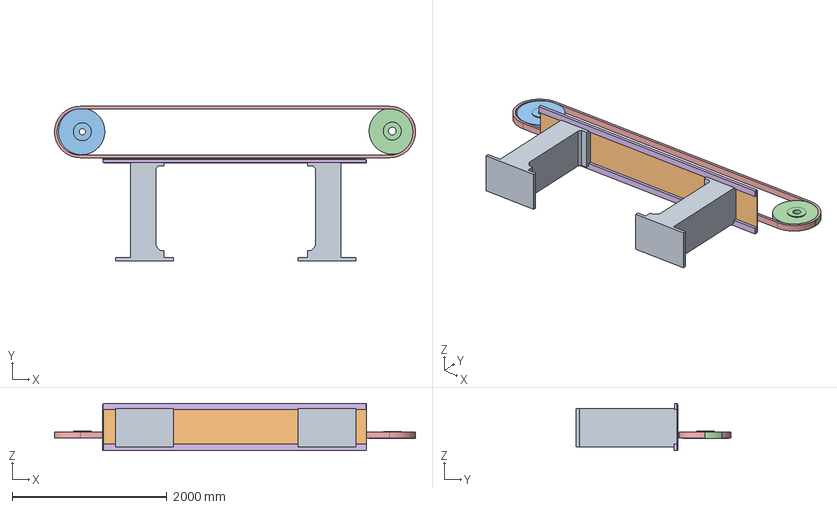
[picture p73: CAD file, 2026-11-06]
3D.chonchons.beta/freecad/ensamble/ensamble.finalchonchon.cut.step
4666.5 x 1997.9 x 612.9 mm
