dicarlantoniooctavio-create/carpinteria-vortex/3D.chonchons.beta/Solid/motor/motor.trifa.choco.SLDASM

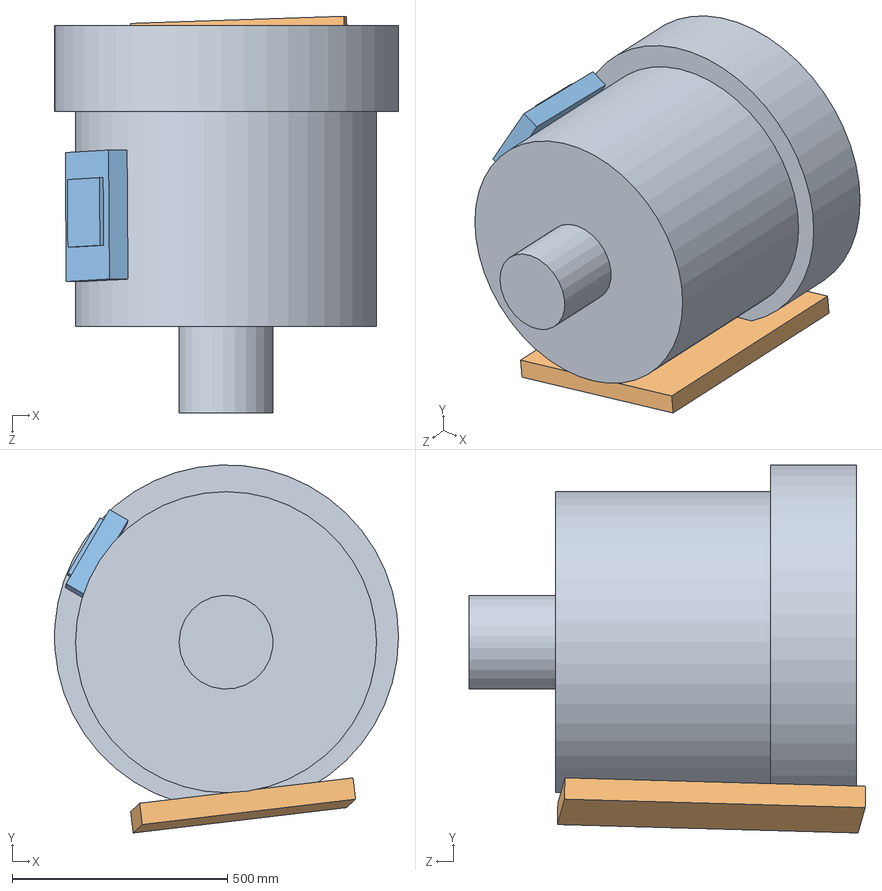
[picture p74: CAD file, 2026-11-06]
3D.chonchons.beta/Solid/motor/motor.trifa.choco.SLDASM
800.0 x 855.7 x 922.0 mm
motor barba p1
pieza motor barba p2
pieza.placha.motor
