dicarlantoniooctavio-create/carpinteria-vortex/3D.chonchons.beta/freecad/lijadora_mejorada/lijadora_mejorada.step

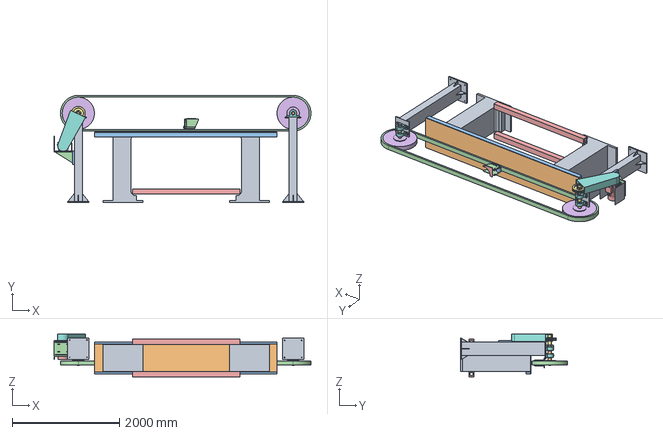
[picture p75: CAD file, 2026-11-06]
3D.chonchons.beta/freecad/lijadora_mejorada/lijadora_mejorada.step
4786.1 x 1997.9 x 792.2 mm
