dicarlantoniooctavio-create/carpinteria-vortex/3D.chonchons.beta/freecad/lijadora_mejorada_v3/banda_lija_150.step

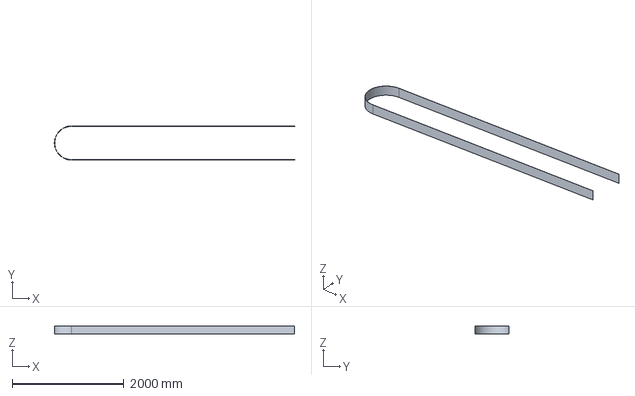
[picture p76: CAD file, 2026-11-06]
3D.chonchons.beta/freecad/lijadora_mejorada_v3/banda_lija_150.step
4303.0 x 606.0 x 150.0 mm
