dicarlantoniooctavio-create/carpinteria-vortex/3D.chonchons.beta/freecad/pieza 1/pieza 1 base.step

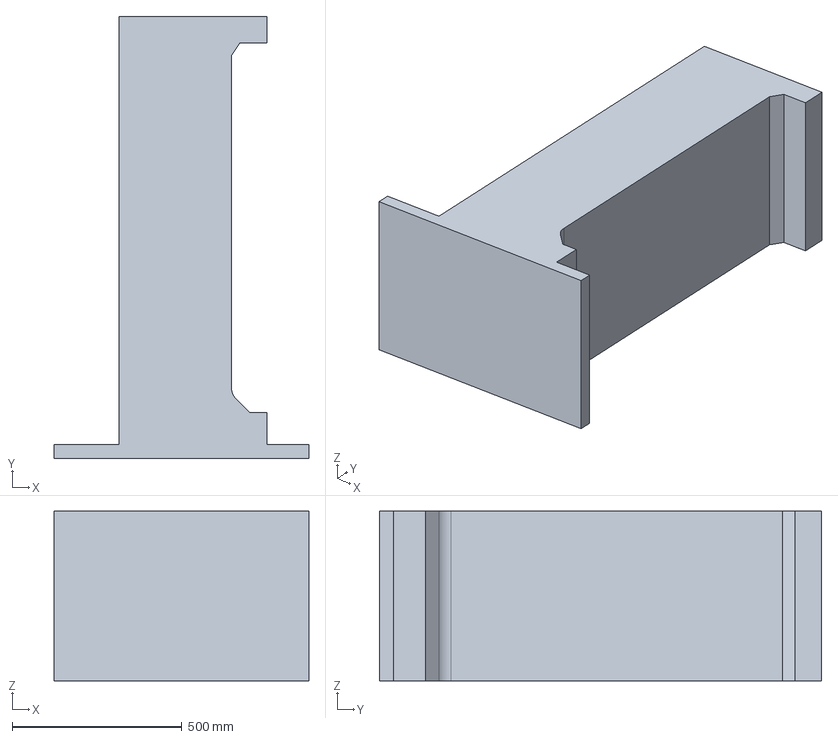
[picture p77: CAD file, 2026-11-06]
3D.chonchons.beta/freecad/pieza 1/pieza 1 base.step
750.0 x 1301.8 x 500.0 mm
