dicarlantoniooctavio-create/carpinteria-vortex/3D.chonchons.beta/freecad/pieza10/pieza10 eje delantero.step

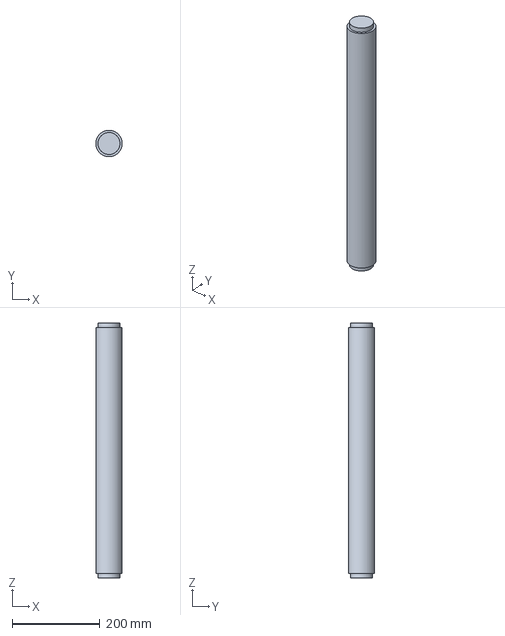
[picture p78: CAD file, 2026-11-06]
3D.chonchons.beta/freecad/pieza10/pieza10 eje delantero.step
59.9 x 60.0 x 580.0 mm
