dicarlantoniooctavio-create/carpinteria-vortex/3D.chonchons.beta/freecad/pieza11/pieza11 eje trasero.step

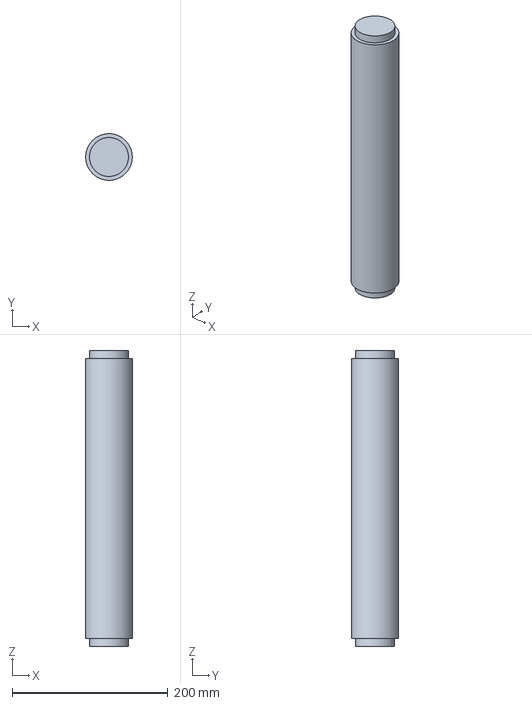
[picture p79: CAD file, 2026-11-06]
3D.chonchons.beta/freecad/pieza11/pieza11 eje trasero.step
59.9 x 60.0 x 380.0 mm
