dicarlantoniooctavio-create/carpinteria-vortex/3D.chonchons.beta/freecad/pieza12/pieza12soporte rollo.step

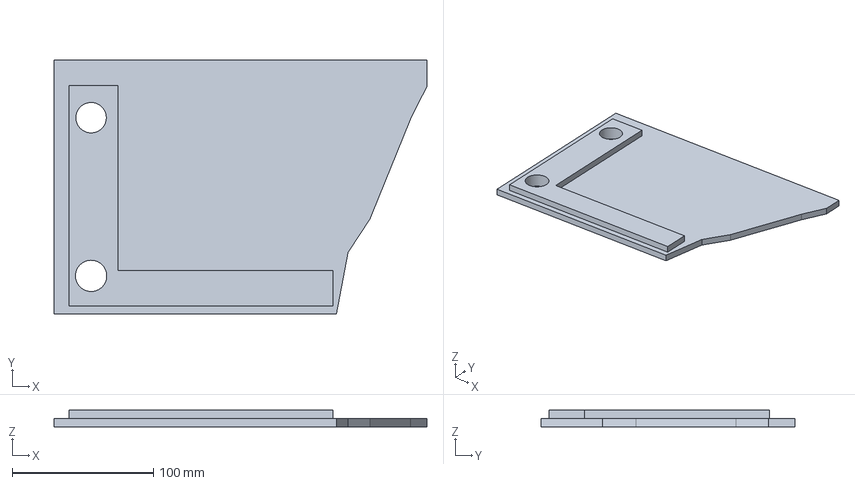
[picture p80: CAD file, 2026-11-06]
3D.chonchons.beta/freecad/pieza12/pieza12soporte rollo.step
264.1 x 180.0 x 12.0 mm
