dicarlantoniooctavio-create/carpinteria-vortex/3D.chonchons.beta/freecad/pieza13/pieza13 placa inclinacion.step

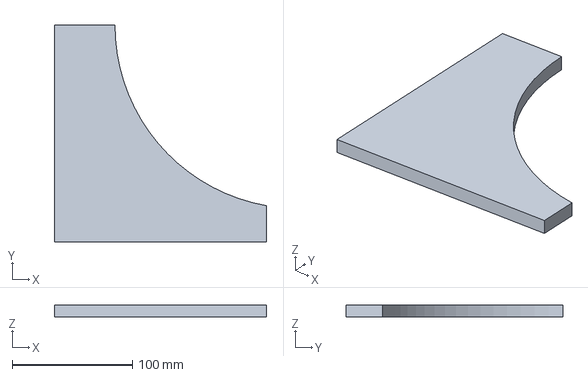
[picture p81: CAD file, 2026-11-06]
3D.chonchons.beta/freecad/pieza13/pieza13 placa inclinacion.step
176.2 x 180.0 x 10.0 mm
