dicarlantoniooctavio-create/carpinteria-vortex/3D.chonchons.beta/freecad/pieza2y3/pieza 2 travesaño inferior.step

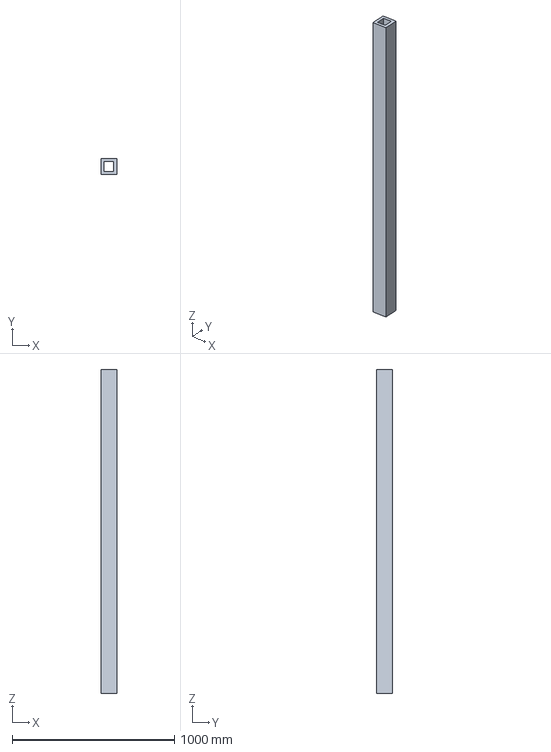
[picture p82: CAD file, 2026-11-06]
3D.chonchons.beta/freecad/pieza2y3/pieza 2 travesaño inferior.step
100.0 x 100.0 x 2000.0 mm
