dicarlantoniooctavio-create/carpinteria-vortex/3D.chonchons.beta/freecad/pieza5/pieza5.step

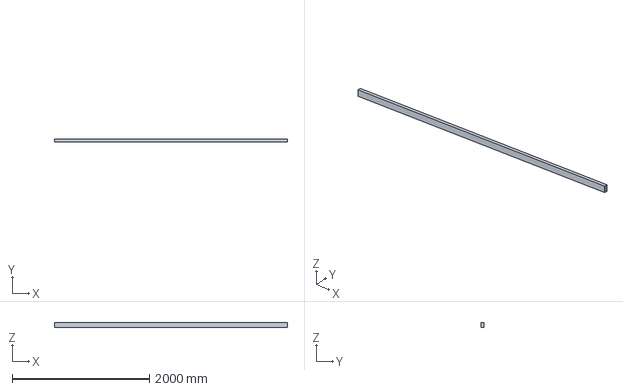
[picture p83: CAD file, 2026-11-06]
3D.chonchons.beta/freecad/pieza5/pieza5.step
3400.0 x 40.0 x 80.0 mm
