dicarlantoniooctavio-create/carpinteria-vortex/3D.chonchons.beta/freecad/pieza6y7/pieza6x2(7).step

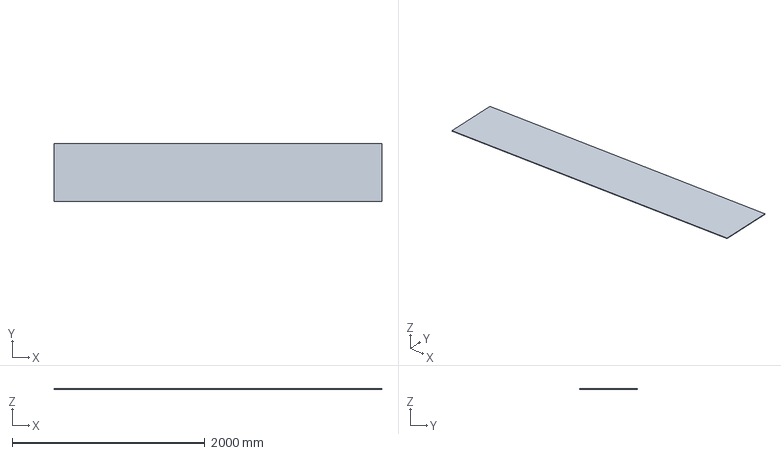
[picture p84: CAD file, 2026-11-06]
3D.chonchons.beta/freecad/pieza6y7/pieza6x2(7).step
3400.0 x 600.0 x 6.00 mm
