dicarlantoniooctavio-create/carpinteria-vortex/3D.chonchons.beta/freecad/pieza8/pieza8 rueda delantera.step

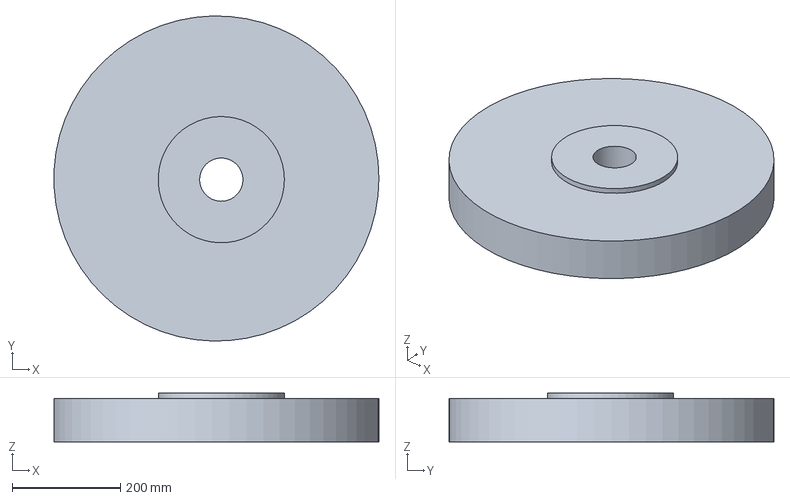
[picture p85: CAD file, 2026-11-06]
3D.chonchons.beta/freecad/pieza8/pieza8 rueda delantera.step
599.6 x 599.8 x 90.0 mm
