dicarlantoniooctavio-create/carpinteria-vortex/3D.chonchons.beta/Solid/pieza9/pieza9 rueda trasera.SLDPRT

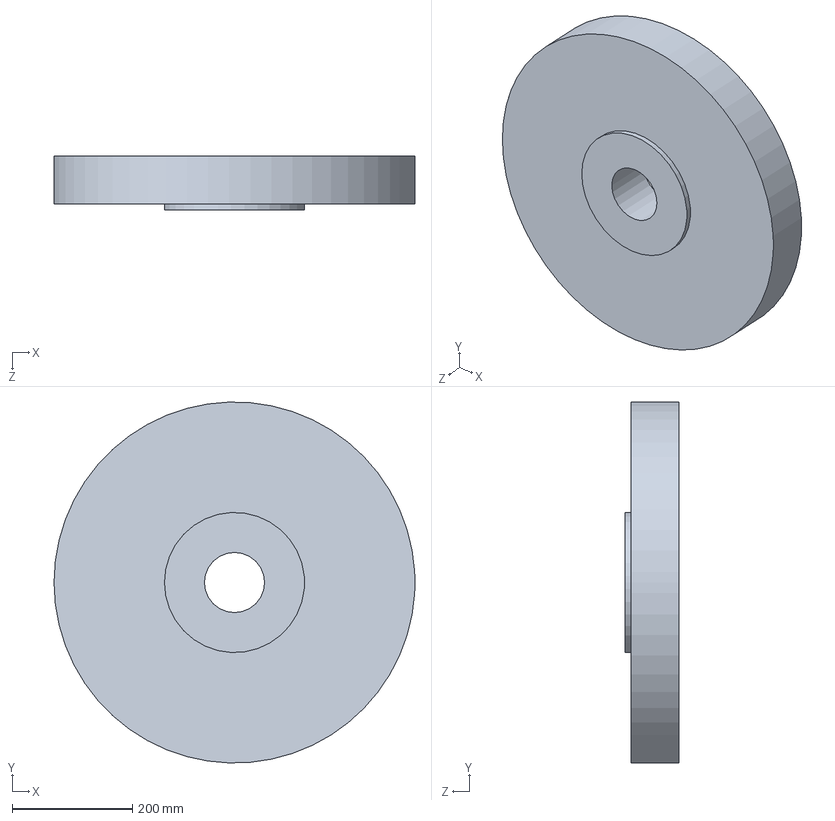
[picture p86: CAD file, 2026-11-06]
3D.chonchons.beta/Solid/pieza9/pieza9 rueda trasera.SLDPRT
600.0 x 599.7 x 90.0 mm
