dicarlantoniooctavio-create/carpinteria-vortex/PRINCIPAL/01_Proyecto_Organizado/modelado-3d/modelo/lijadora_corregida.FCStd

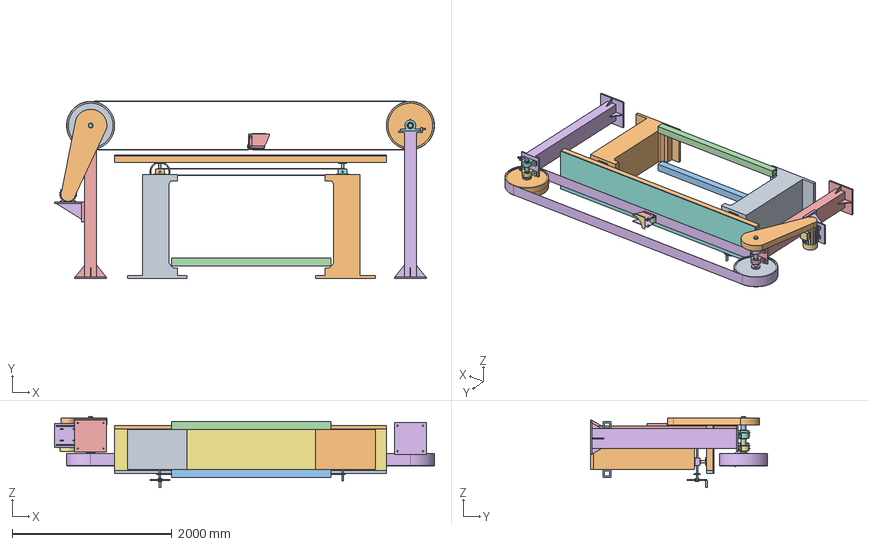
[picture p87: CAD file, 2026-11-07]
PRINCIPAL/01_Proyecto_Organizado/modelado-3d/modelo/lijadora_corregida.FCStd
4755.5 x 2219.3 x 893.8 mm
pieza 1 base-1
pieza 1 base-3
pieza 2 travesaño trav
pieza 2 travesaño trav2
columna del
columna tra
pieza6x1-1 mesa
pieza6x1-2 mesa
pieza5-2
pieza5-1
tensor 1565
tensor 1725
chumacera del 1
chumacera del 2
chumacera tra 1
chumacera tra 2
rueda del
rueda tra
eje del (pieza 10)
eje tra (pieza 11)
pieza 4 soporte motor
ménsula soporte motor
motor 4HP
polea motor Ø90
polea eje Ø315
guardamotor
correas V
rodillo presionador (eje.dosruedas)
pieza12 soporte rodillo A
pieza12 soporte rodillo B
pieza13 manija
gato 11
husillo Tr30 11
gato 12
husillo Tr30 12
travesaño mesa 1
eje sinfín + piñón 1
gato 21
husillo Tr30 21
gato 22
husillo Tr30 22
travesaño mesa 2
eje sinfín + piñón 2
volante altura mesa
cadena mesa
banda lija 150
