dicarlantoniooctavio-create/carpinteria-vortex/3D.chonchons.beta/freecad/correa/correa.chocomelli.step

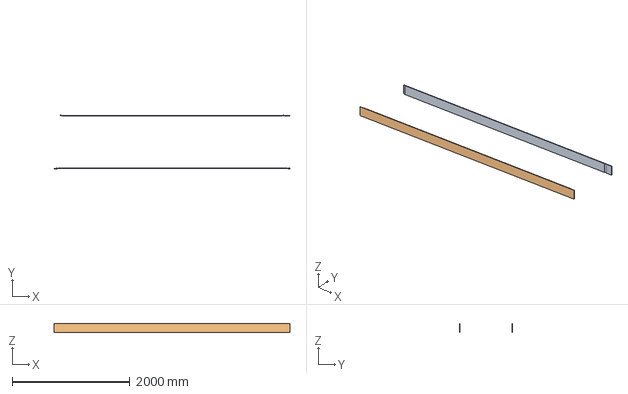
[picture p88: CAD file, 2026-11-06]
3D.chonchons.beta/freecad/correa/correa.chocomelli.step
4000.0 x 905.8 x 150.0 mm
