dicarlantoniooctavio-create/carpinteria-vortex/3D.chonchons.beta/freecad/lijadora_mejorada/polea_motor_D140_2B.step

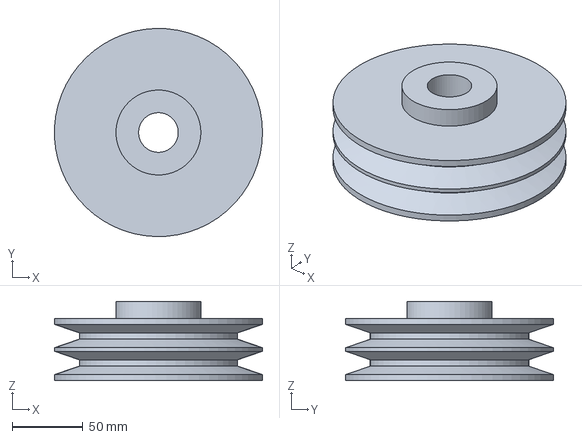
[picture p89: CAD file, 2026-11-06]
3D.chonchons.beta/freecad/lijadora_mejorada/polea_motor_D140_2B.step
146.9 x 146.9 x 56.0 mm
