dicarlantoniooctavio-create/carpinteria-vortex/3D.chonchons.beta/freecad/lijadora_mejorada_v3/polea_motor_D90_2A.step

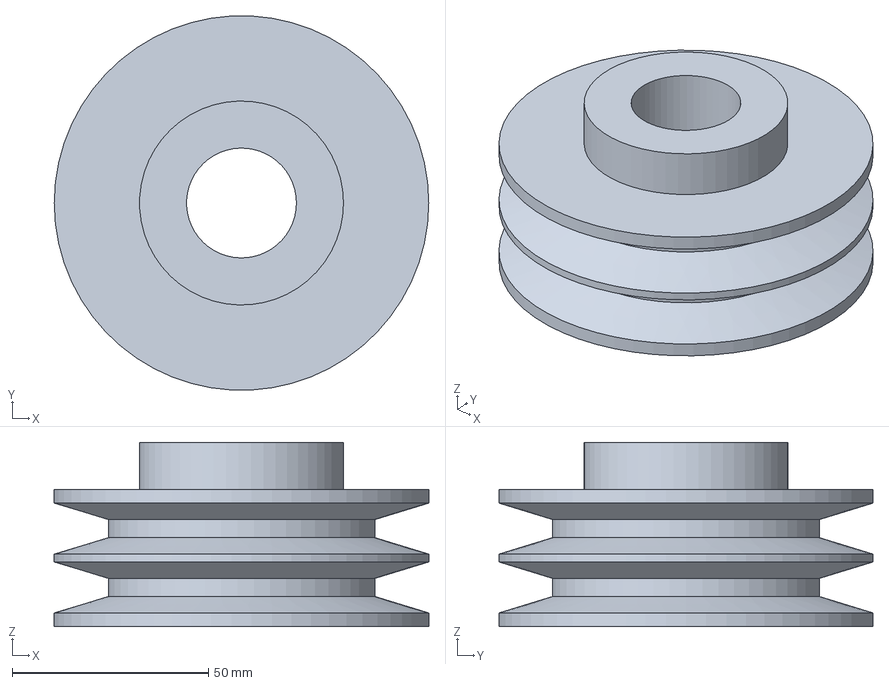
[picture p90: CAD file, 2026-11-06]
3D.chonchons.beta/freecad/lijadora_mejorada_v3/polea_motor_D90_2A.step
95.5 x 95.4 x 47.0 mm
