dicarlantoniooctavio-create/carpinteria-vortex/3D.chonchons.beta/freecad/correa/correa.real.chocomelli.step

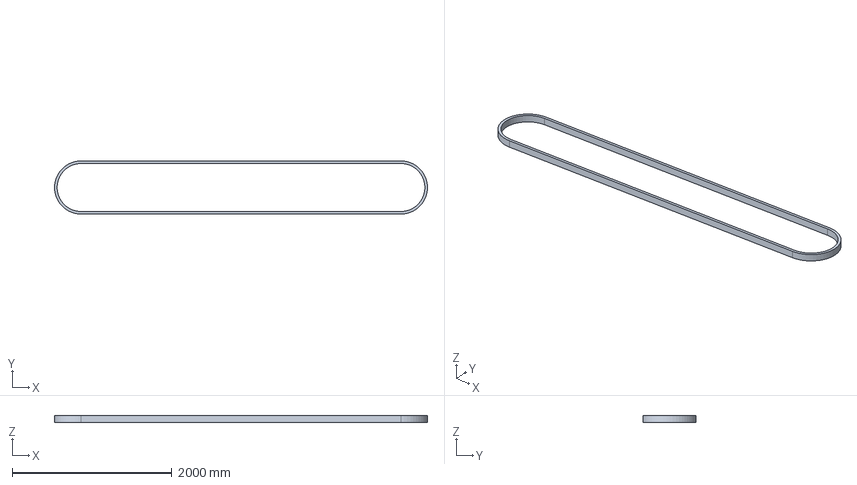
[picture p91: CAD file, 2026-11-06]
3D.chonchons.beta/freecad/correa/correa.real.chocomelli.step
4666.1 x 666.1 x 82.0 mm
