dicarlantoniooctavio-create/carpinteria-vortex/3D.chonchons.beta/freecad/lijadora_mejorada_v3/guardamotor.step

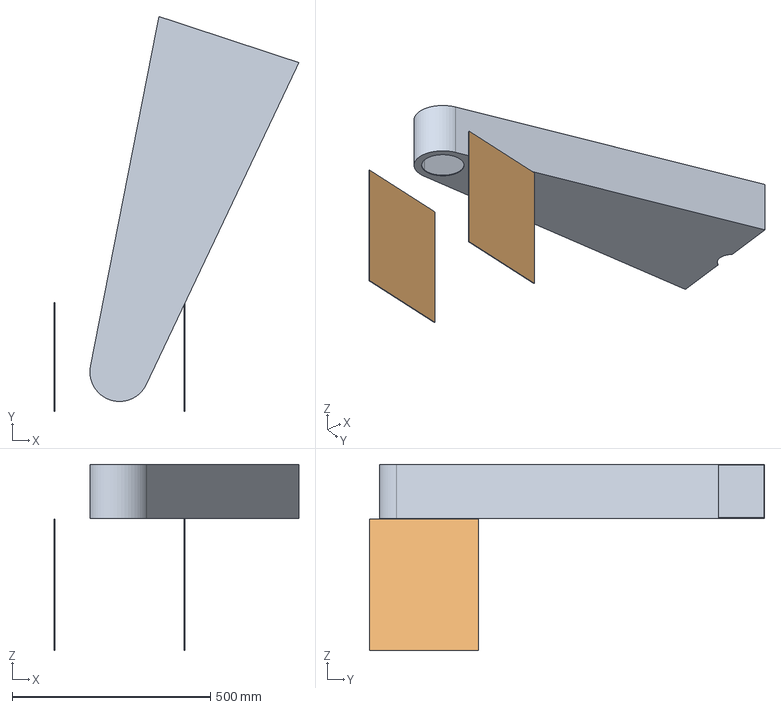
[picture p92: CAD file, 2026-11-06]
3D.chonchons.beta/freecad/lijadora_mejorada_v3/guardamotor.step
617.2 x 995.5 x 469.0 mm
