dicarlantoniooctavio-create/carpinteria-vortex/PRINCIPAL/01_Proyecto_Organizado/modelado-3d/piezas/pieza11 eje trasero.SLDPRT

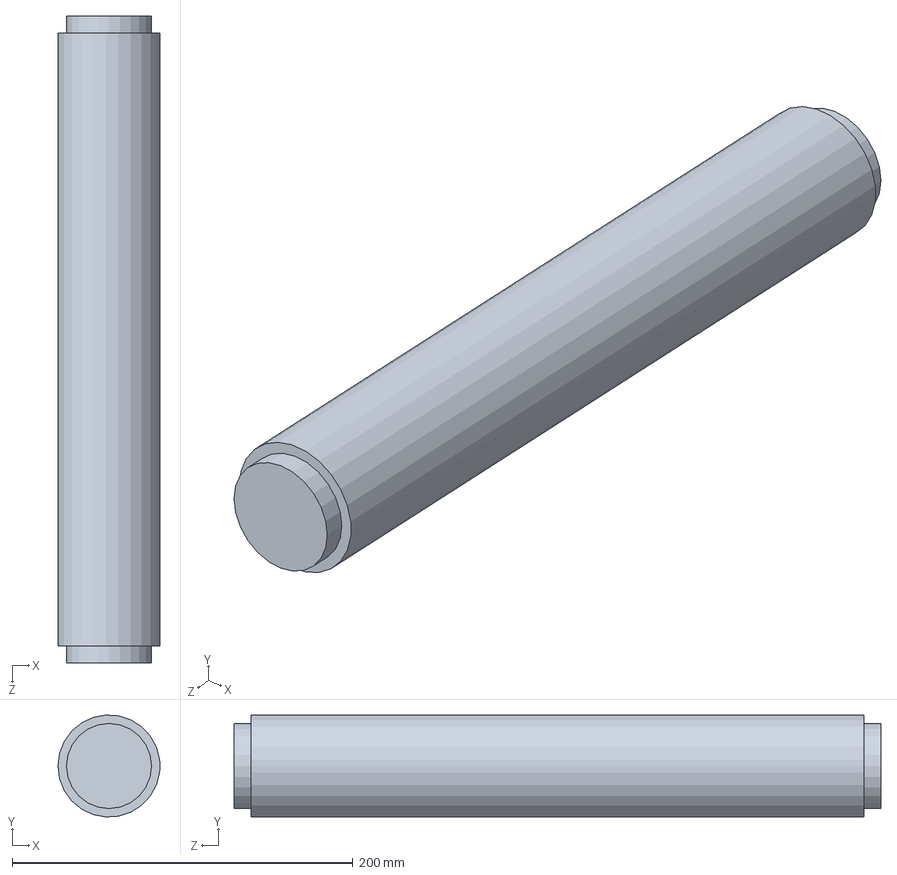
[picture p93: CAD file, 2026-10-22]
PRINCIPAL/01_Proyecto_Organizado/modelado-3d/piezas/pieza11 eje trasero.SLDPRT
60.0 x 59.9 x 380.0 mm
