dicarlantoniooctavio-create/carpinteria-vortex/3D.chonchons.beta/freecad/lijadora_mejorada/polea_eje_D250_2B.step

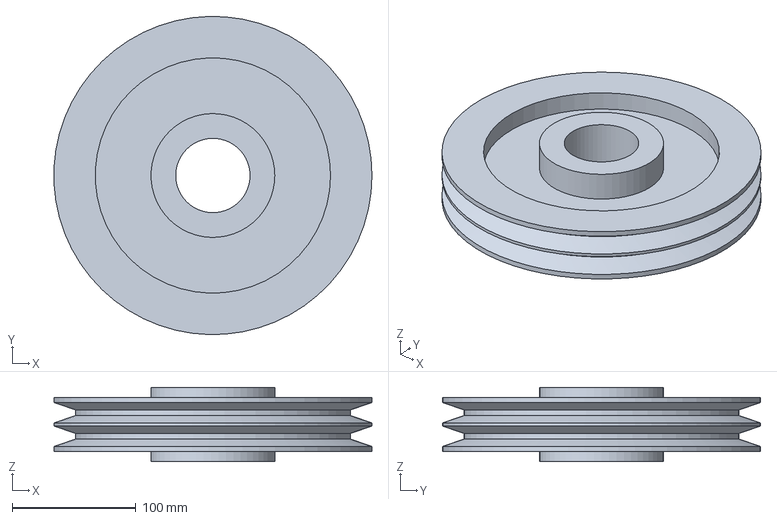
[picture p94: CAD file, 2026-11-06]
3D.chonchons.beta/freecad/lijadora_mejorada/polea_eje_D250_2B.step
256.8 x 256.9 x 60.0 mm
