dicarlantoniooctavio-create/carpinteria-vortex/3D.chonchons.beta/freecad/lijadora_mejorada_v3/lijadora_mejorada.step

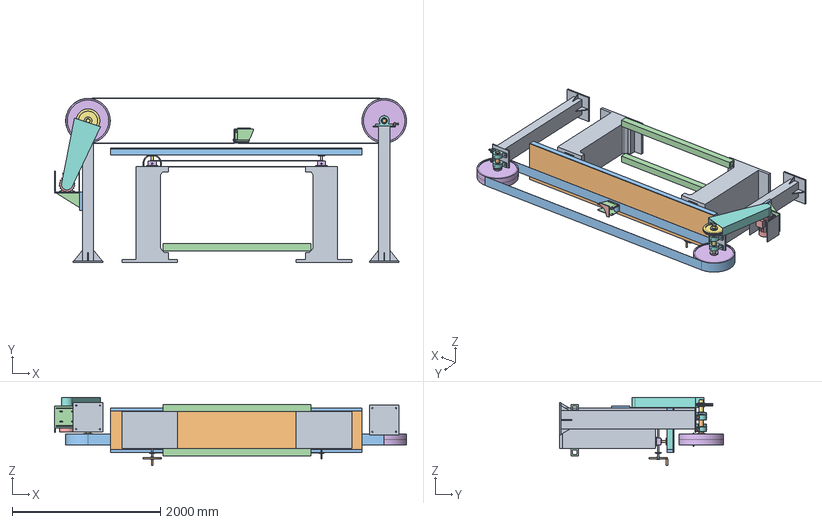
[picture p95: CAD file, 2026-11-06]
3D.chonchons.beta/freecad/lijadora_mejorada_v3/lijadora_mejorada.step
4754.0 x 2219.8 x 919.0 mm
