dicarlantoniooctavio-create/carpinteria-vortex/3D.chonchons.beta/freecad/lijadora_mejorada_v3/polea_eje_D315_2A.step

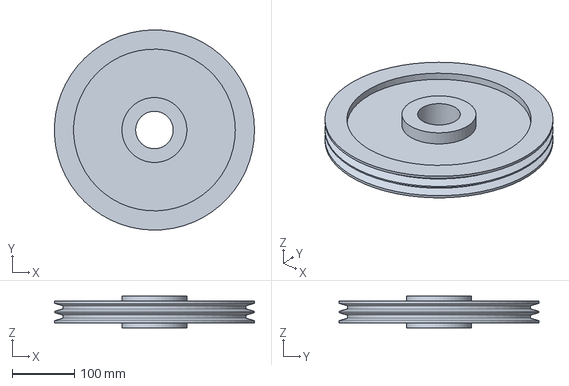
[picture p97: CAD file, 2026-11-06]
3D.chonchons.beta/freecad/lijadora_mejorada_v3/polea_eje_D315_2A.step
320.3 x 320.4 x 51.0 mm
