dicarlantoniooctavio-create/carpinteria-vortex/3D.chonchons.beta/freecad/lijadora_mejorada/motor_trifasico_4HP.step

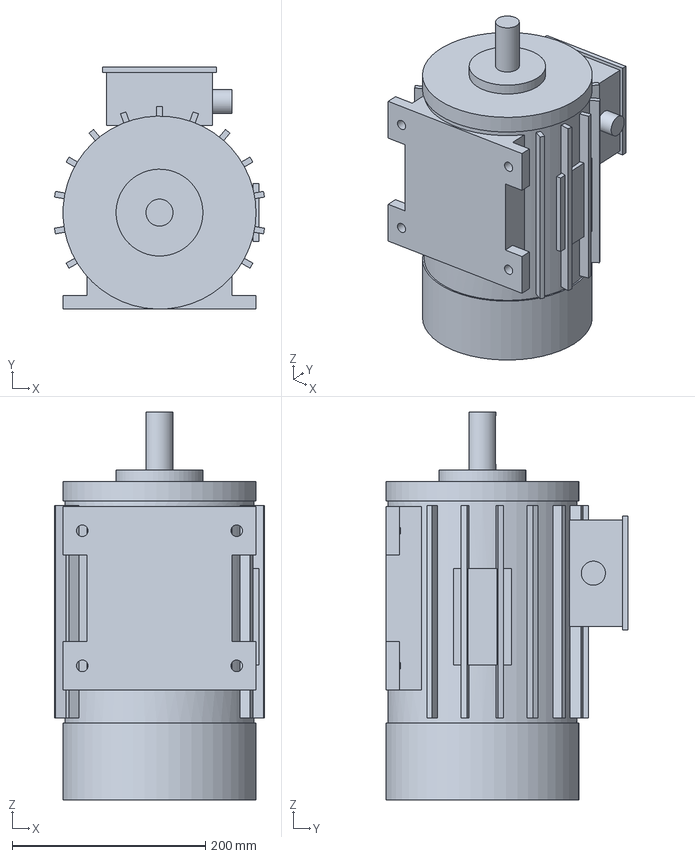
[picture p98: CAD file, 2026-11-06]
3D.chonchons.beta/freecad/lijadora_mejorada/motor_trifasico_4HP.step
217.7 x 251.0 x 402.0 mm
