dicarlantoniooctavio-create/carpinteria-vortex/3D.chonchons.beta/freecad/lijadora_mejorada_v3/tensor_correa.step

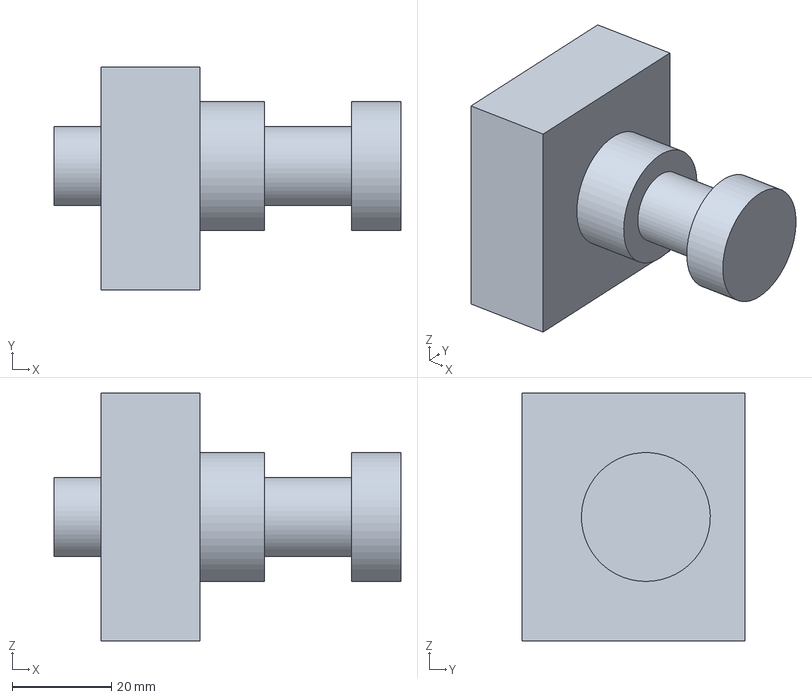
[picture p99: CAD file, 2026-11-06]
3D.chonchons.beta/freecad/lijadora_mejorada_v3/tensor_correa.step
70.0 x 45.0 x 50.0 mm
