dicarlantoniooctavio-create/carpinteria-vortex/3D.chonchons.beta/freecad/lijadora_mejorada/mensula_soporte_motor.step

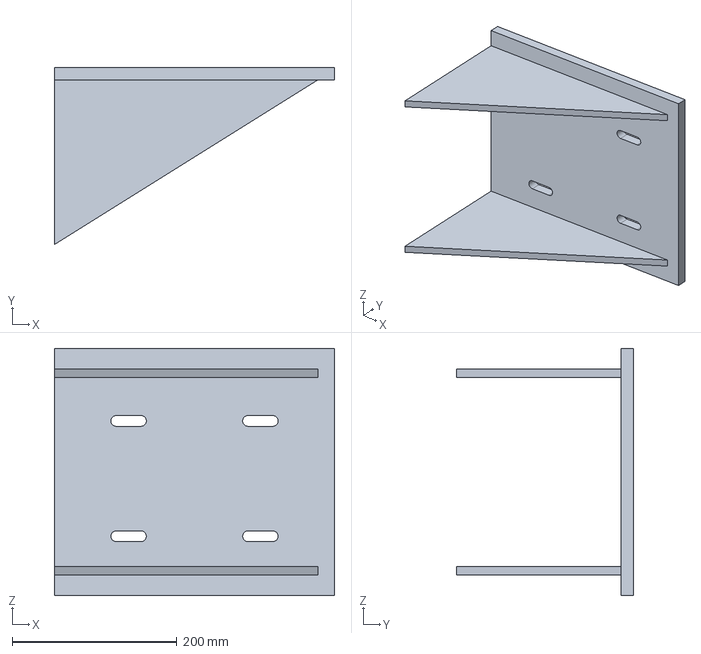
[picture p100: CAD file, 2026-11-06]
3D.chonchons.beta/freecad/lijadora_mejorada/mensula_soporte_motor.step
340.0 x 215.0 x 300.0 mm
