dicarlantoniooctavio-create/carpinteria-vortex/3D.chonchons.beta/freecad/lijadora_mejorada_v3/rueda_D600x150.step

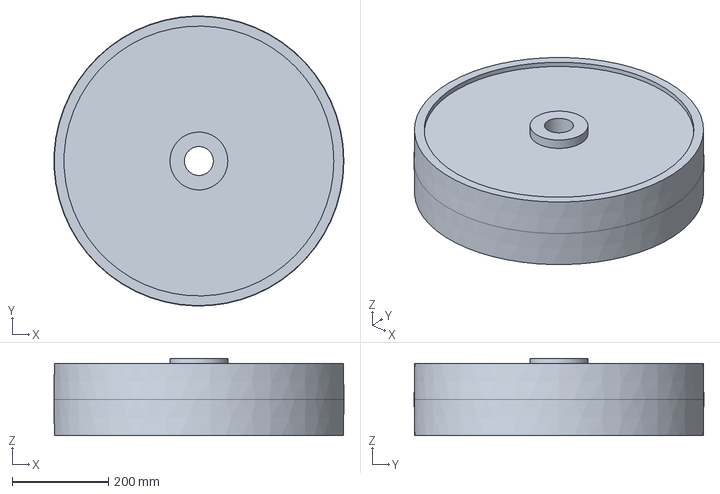
[picture p101: CAD file, 2026-11-06]
3D.chonchons.beta/freecad/lijadora_mejorada_v3/rueda_D600x150.step
601.6 x 601.8 x 160.0 mm
