dicarlantoniooctavio-create/carpinteria-vortex/3D.chonchons.beta/freecad/lijadora_mejorada/guardamotor.step

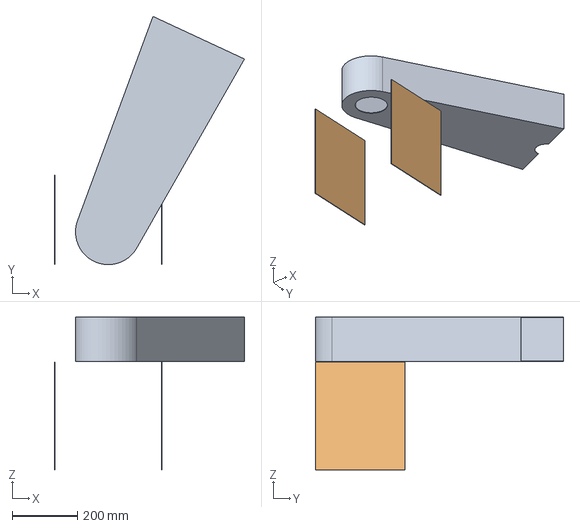
[picture p102: CAD file, 2026-11-06]
3D.chonchons.beta/freecad/lijadora_mejorada/guardamotor.step
583.1 x 761.7 x 469.0 mm
