dicarlantoniooctavio-create/carpinteria-vortex/3D.chonchons.beta/freecad/lijadora_mejorada/correas_V_B.step

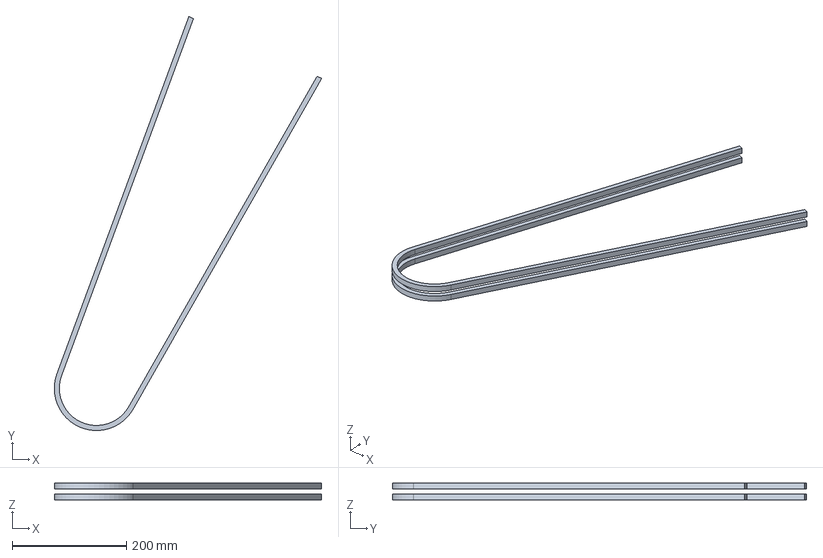
[picture p103: CAD file, 2026-11-06]
3D.chonchons.beta/freecad/lijadora_mejorada/correas_V_B.step
469.1 x 726.1 x 29.0 mm
