dicarlantoniooctavio-create/carpinteria-vortex/3D.chonchons.beta/freecad/lijadora_mejorada_v3/correas_V_A.step

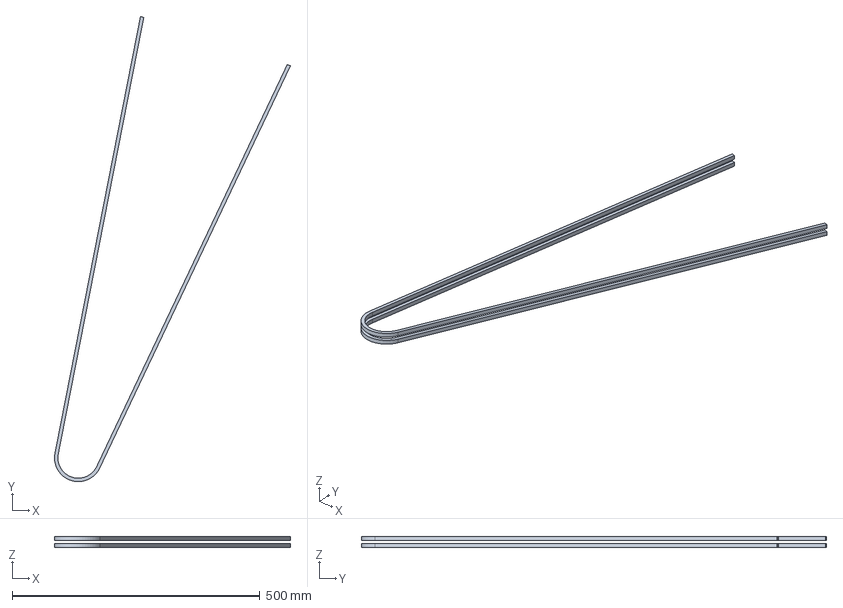
[picture p104: CAD file, 2026-11-06]
3D.chonchons.beta/freecad/lijadora_mejorada_v3/correas_V_A.step
476.0 x 938.3 x 23.0 mm
