dicarlantoniooctavio-create/carpinteria-vortex/3D.chonchons.beta/freecad/lijadora_mejorada/chumacera_UCP212.step

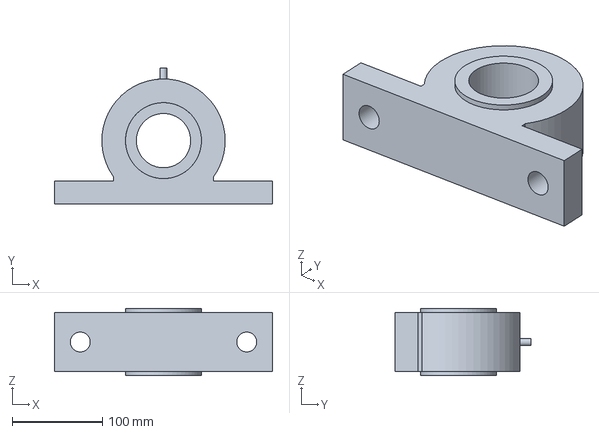
[picture p105: CAD file, 2026-11-06]
3D.chonchons.beta/freecad/lijadora_mejorada/chumacera_UCP212.step
241.0 x 149.8 x 74.6 mm
