dicarlantoniooctavio-create/carpinteria-vortex/3D.chonchons.beta/freecad/lijadora_mejorada_v3/gato_tornillo_2.5t.step

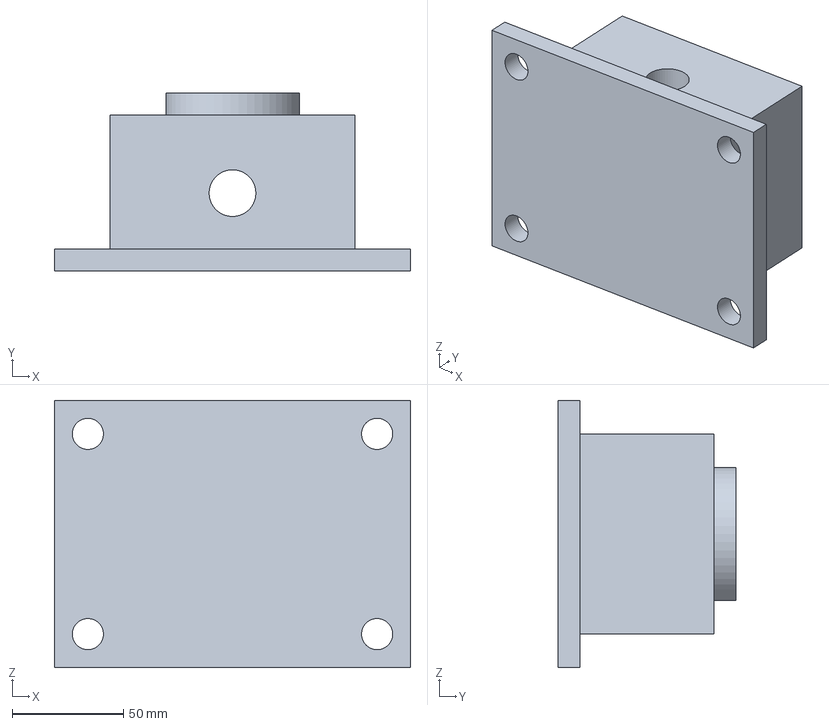
[picture p106: CAD file, 2026-11-06]
3D.chonchons.beta/freecad/lijadora_mejorada_v3/gato_tornillo_2.5t.step
160.0 x 80.0 x 120.0 mm
