dicarlantoniooctavio-create/carpinteria-vortex/3D.chonchons.beta/freecad/lijadora_mejorada_v3/travesano_mesa.step

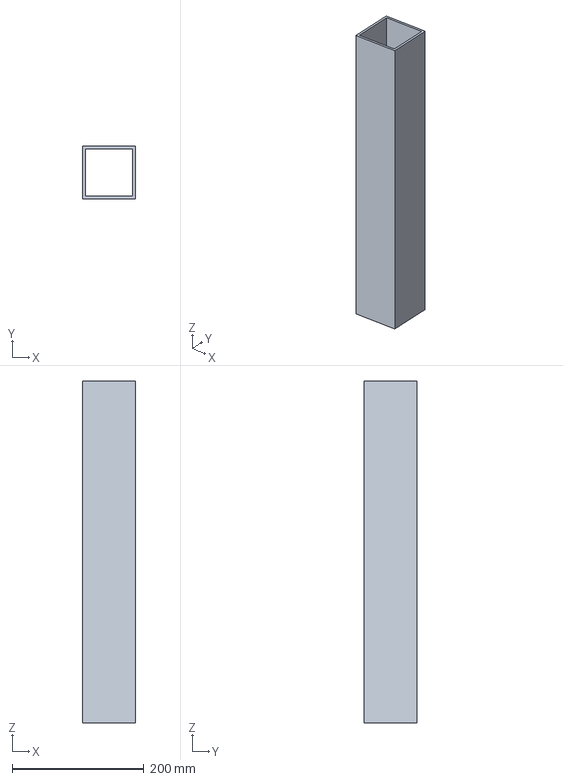
[picture p107: CAD file, 2026-11-06]
3D.chonchons.beta/freecad/lijadora_mejorada_v3/travesano_mesa.step
80.0 x 80.0 x 520.0 mm
