dicarlantoniooctavio-create/carpinteria-vortex/3D.chonchons.beta/freecad/lijadora_mejorada_v3/cadena_mesa.step

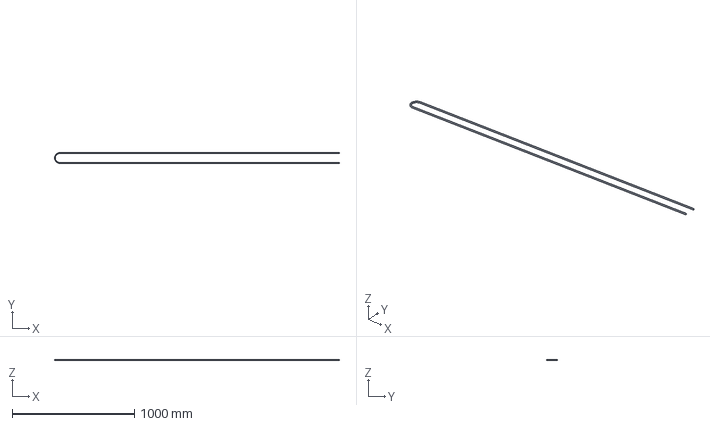
[picture p108: CAD file, 2026-11-06]
3D.chonchons.beta/freecad/lijadora_mejorada_v3/cadena_mesa.step
2330.4 x 88.0 x 8.00 mm
