dicarlantoniooctavio-create/carpinteria-vortex/3D.chonchons.beta/freecad/lijadora_mejorada_v3/volante_altura_mesa.step

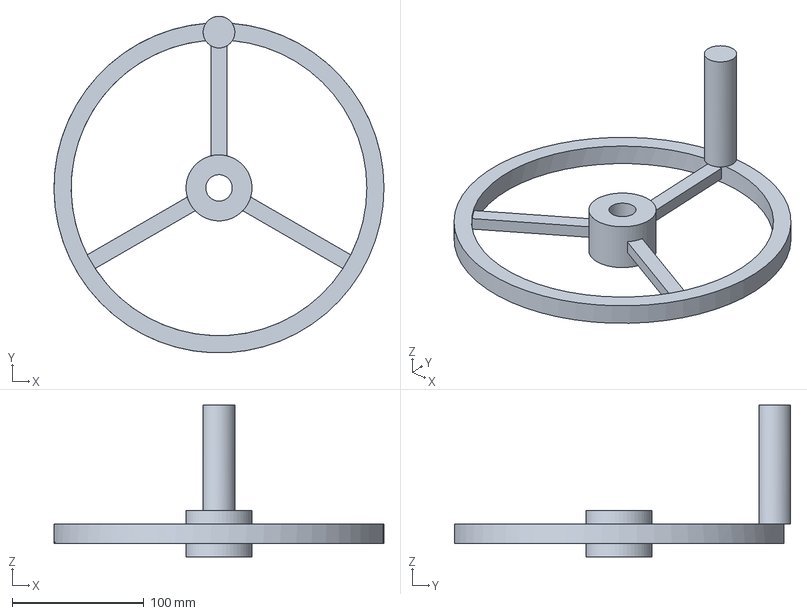
[picture p109: CAD file, 2026-11-06]
3D.chonchons.beta/freecad/lijadora_mejorada_v3/volante_altura_mesa.step
250.0 x 254.9 x 115.0 mm
