dicarlantoniooctavio-create/carpinteria-vortex/3D.chonchons.beta/freecad/lijadora_mejorada_v3/columna_rueda.step

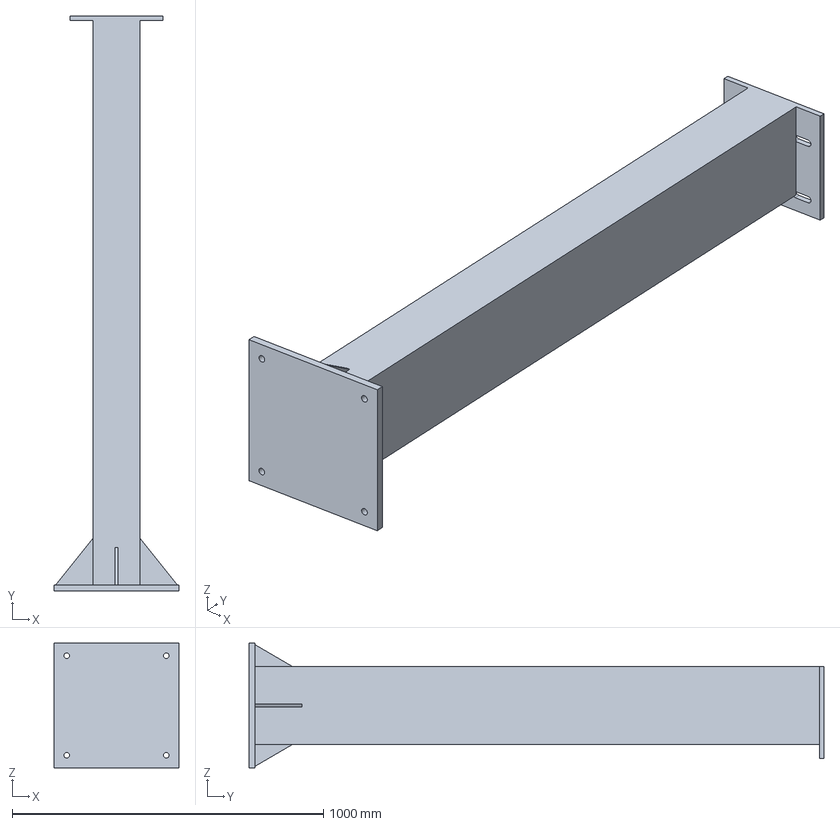
[picture p110: CAD file, 2026-11-06]
3D.chonchons.beta/freecad/lijadora_mejorada_v3/columna_rueda.step
400.0 x 1847.0 x 400.0 mm
