dicarlantoniooctavio-create/carpinteria-vortex/(list of files, cad)

Other CAD files:
3D.chonchons.beta/freecad/pieza9/pieza9 rueda trasera.step
3D.chonchons.beta/Solid/pieza 1/pieza 1 base.SLDPRT
PRINCIPAL/01_Proyecto_Organizado/instalacion-electrica/planos/Plano_Carpinteria_TUG3.dwg
PRINCIPAL/01_Proyecto_Organizado/instalacion-electrica/tableros/Multifilar.dwg
PRINCIPAL/01_Proyecto_Organizado/modelado-3d/planos/Despiece_Lijadora.dwg
PRINCIPAL/04_Web/archivos/Despiece_Lijadora.dwg
tableros.electricos/Unifilar.dwg
3D.chonchons.beta/freecad/pieza6y7/pieza6x1.step
PRINCIPAL/01_Proyecto_Organizado/instalacion-electrica/planos/Plano_Carpinteria_con_maquinas.dwg
PRINCIPAL/01_Proyecto_Organizado/instalacion-electrica/tableros/Unifilar.dwg
PRINCIPAL/01_Proyecto_Organizado/modelado-3d/piezas/pieza 2 travesaño inferior.SLDPRT
PRINCIPAL/04_Web/archivos/Vistas_Lijadora.dwg
tableros.electricos/Multifilar.dwg
3D.chonchons.beta/freecad/lijadora_mejorada/rueda_D600_eje60.step
PRINCIPAL/04_Web/archivos/Unifilar.dwg
tableros.electricos/Unifilar_con_nombres.dwg
PRINCIPAL/01_Proyecto_Organizado/modelado-3d/piezas/correa.real.chocomelli.SLDPRT
PRINCIPAL/01_Proyecto_Organizado/modelado-3d/piezas/pieza6x1.SLDPRT
3D.chonchons.beta/freecad/lijadora_mejorada_v3/mensula_soporte_motor.step
3D.chonchons.beta/freecad/lijadora_mejorada_v3/motor_trifasico_4HP.step
3D.chonchons.beta/freecad/lijadora_mejorada_v3/chumacera_UCP212.step
3D.chonchons.beta/correa/correa.chocomelli.SLDPRT
3D.chonchons.beta/correa/correa.real.SLDPRT
3D.chonchons.beta/ensamble/ensamble.finalchonchon.cut.SLDASM
3D.chonchons.beta/freecad/correa/correa.chocomelli.FCStd
3D.chonchons.beta/freecad/correa/correa.real.FCStd
3D.chonchons.beta/freecad/correa/correa.real.chocomelli.FCStd
3D.chonchons.beta/freecad/ejes/eje.dosruedas.FCStd
3D.chonchons.beta/freecad/ensamble/ensamble.finalchonchon.cut.FCStd
3D.chonchons.beta/freecad/lijadora_mejorada/chumacera_UCP212.FCStd
3D.chonchons.beta/freecad/lijadora_mejorada/columna_rueda.FCStd
3D.chonchons.beta/freecad/lijadora_mejorada/correas_V_B.FCStd
3D.chonchons.beta/freecad/lijadora_mejorada/guardamotor.FCStd
3D.chonchons.beta/freecad/lijadora_mejorada/lijadora_mejorada.FCStd
3D.chonchons.beta/freecad/lijadora_mejorada/mensula_soporte_motor.FCStd
3D.chonchons.beta/freecad/lijadora_mejorada/motor_trifasico_4HP.FCStd
3D.chonchons.beta/freecad/lijadora_mejorada/polea_eje_D250_2B.FCStd
3D.chonchons.beta/freecad/lijadora_mejorada/polea_motor_D140_2B.FCStd
3D.chonchons.beta/freecad/lijadora_mejorada/rueda_D600_eje60.FCStd
3D.chonchons.beta/freecad/lijadora_mejorada_v2/chumacera_UCP212.FCStd
3D.chonchons.beta/freecad/lijadora_mejorada_v2/chumacera_UCP212.step
3D.chonchons.beta/freecad/lijadora_mejorada_v2/columna_rueda.FCStd
3D.chonchons.beta/freecad/lijadora_mejorada_v2/columna_rueda.step
3D.chonchons.beta/freecad/lijadora_mejorada_v2/correas_V_A.FCStd
3D.chonchons.beta/freecad/lijadora_mejorada_v2/correas_V_A.step
3D.chonchons.beta/freecad/lijadora_mejorada_v2/guardamotor.FCStd
3D.chonchons.beta/freecad/lijadora_mejorada_v2/guardamotor.step
3D.chonchons.beta/freecad/lijadora_mejorada_v2/lijadora_mejorada.FCStd
3D.chonchons.beta/freecad/lijadora_mejorada_v2/lijadora_mejorada.step
3D.chonchons.beta/freecad/lijadora_mejorada_v2/mensula_soporte_motor.FCStd
3D.chonchons.beta/freecad/lijadora_mejorada_v2/mensula_soporte_motor.step
3D.chonchons.beta/freecad/lijadora_mejorada_v2/motor_trifasico_4HP.FCStd
3D.chonchons.beta/freecad/lijadora_mejorada_v2/motor_trifasico_4HP.step
3D.chonchons.beta/freecad/lijadora_mejorada_v2/polea_eje_D315_2A.FCStd
3D.chonchons.beta/freecad/lijadora_mejorada_v2/polea_eje_D315_2A.step
3D.chonchons.beta/freecad/lijadora_mejorada_v2/polea_motor_D90_2A.FCStd
3D.chonchons.beta/freecad/lijadora_mejorada_v2/polea_motor_D90_2A.step
3D.chonchons.beta/freecad/lijadora_mejorada_v2/rueda_D600_eje60.FCStd
3D.chonchons.beta/freecad/lijadora_mejorada_v2/rueda_D600_eje60.step
3D.chonchons.beta/freecad/lijadora_mejorada_v2/tensor_correa.FCStd
3D.chonchons.beta/freecad/lijadora_mejorada_v2/tensor_correa.step
3D.chonchons.beta/freecad/lijadora_mejorada_v3/banda_lija_150.FCStd
3D.chonchons.beta/freecad/lijadora_mejorada_v3/cadena_mesa.FCStd
3D.chonchons.beta/freecad/lijadora_mejorada_v3/chumacera_UCP212.FCStd
3D.chonchons.beta/freecad/lijadora_mejorada_v3/columna_rueda.FCStd
3D.chonchons.beta/freecad/lijadora_mejorada_v3/correas_V_A.FCStd
3D.chonchons.beta/freecad/lijadora_mejorada_v3/gato_tornillo_2.5t.FCStd
3D.chonchons.beta/freecad/lijadora_mejorada_v3/guardamotor.FCStd
3D.chonchons.beta/freecad/lijadora_mejorada_v3/lijadora_mejorada.FCStd
3D.chonchons.beta/freecad/lijadora_mejorada_v3/mensula_soporte_motor.FCStd
3D.chonchons.beta/freecad/lijadora_mejorada_v3/motor_trifasico_4HP.FCStd
3D.chonchons.beta/freecad/lijadora_mejorada_v3/polea_eje_D315_2A.FCStd
3D.chonchons.beta/freecad/lijadora_mejorada_v3/polea_motor_D90_2A.FCStd
3D.chonchons.beta/freecad/lijadora_mejorada_v3/rueda_D600x150.FCStd
3D.chonchons.beta/freecad/lijadora_mejorada_v3/tensor_correa.FCStd
3D.chonchons.beta/freecad/lijadora_mejorada_v3/travesano_mesa.FCStd
3D.chonchons.beta/freecad/lijadora_mejorada_v3/volante_altura_mesa.FCStd
3D.chonchons.beta/freecad/pieza 1/pieza 1 base.FCStd
3D.chonchons.beta/freecad/pieza10/pieza10 eje delantero.FCStd
3D.chonchons.beta/freecad/pieza11/pieza11 eje trasero.FCStd
3D.chonchons.beta/freecad/pieza12/pieza12soporte rollo.FCStd
3D.chonchons.beta/freecad/pieza13/pieza13 placa inclinacion.FCStd
3D.chonchons.beta/freecad/pieza2y3/pieza 2 travesaño inferior x2.FCStd
3D.chonchons.beta/freecad/pieza2y3/pieza 2 travesaño inferior.FCStd
3D.chonchons.beta/freecad/pieza4/pieza 4 sopor.motor.FCStd
3D.chonchons.beta/freecad/pieza5/pieza5.FCStd
3D.chonchons.beta/freecad/pieza6y7/pieza6x1.FCStd
3D.chonchons.beta/freecad/pieza6y7/pieza6x2(7).FCStd
3D.chonchons.beta/freecad/pieza8/pieza8 rueda delantera.FCStd
3D.chonchons.beta/freecad/pieza9/pieza9 rueda trasera.FCStd
3D.chonchons.beta/pieza10/pieza10 eje delantero.SLDPRT
3D.chonchons.beta/pieza12/pieza12soporte rollo.SLDPRT
3D.chonchons.beta/pieza13/pieza13 placa inclinacion.SLDPRT
