dicarlantoniooctavio-create/carpinteria-vortex/PRINCIPAL/04_Web/archivos/Despiece_Lijadora.pdf

# DESPIECE

## MÁQUINA: LIJADORA DE BANDA · VORTEX

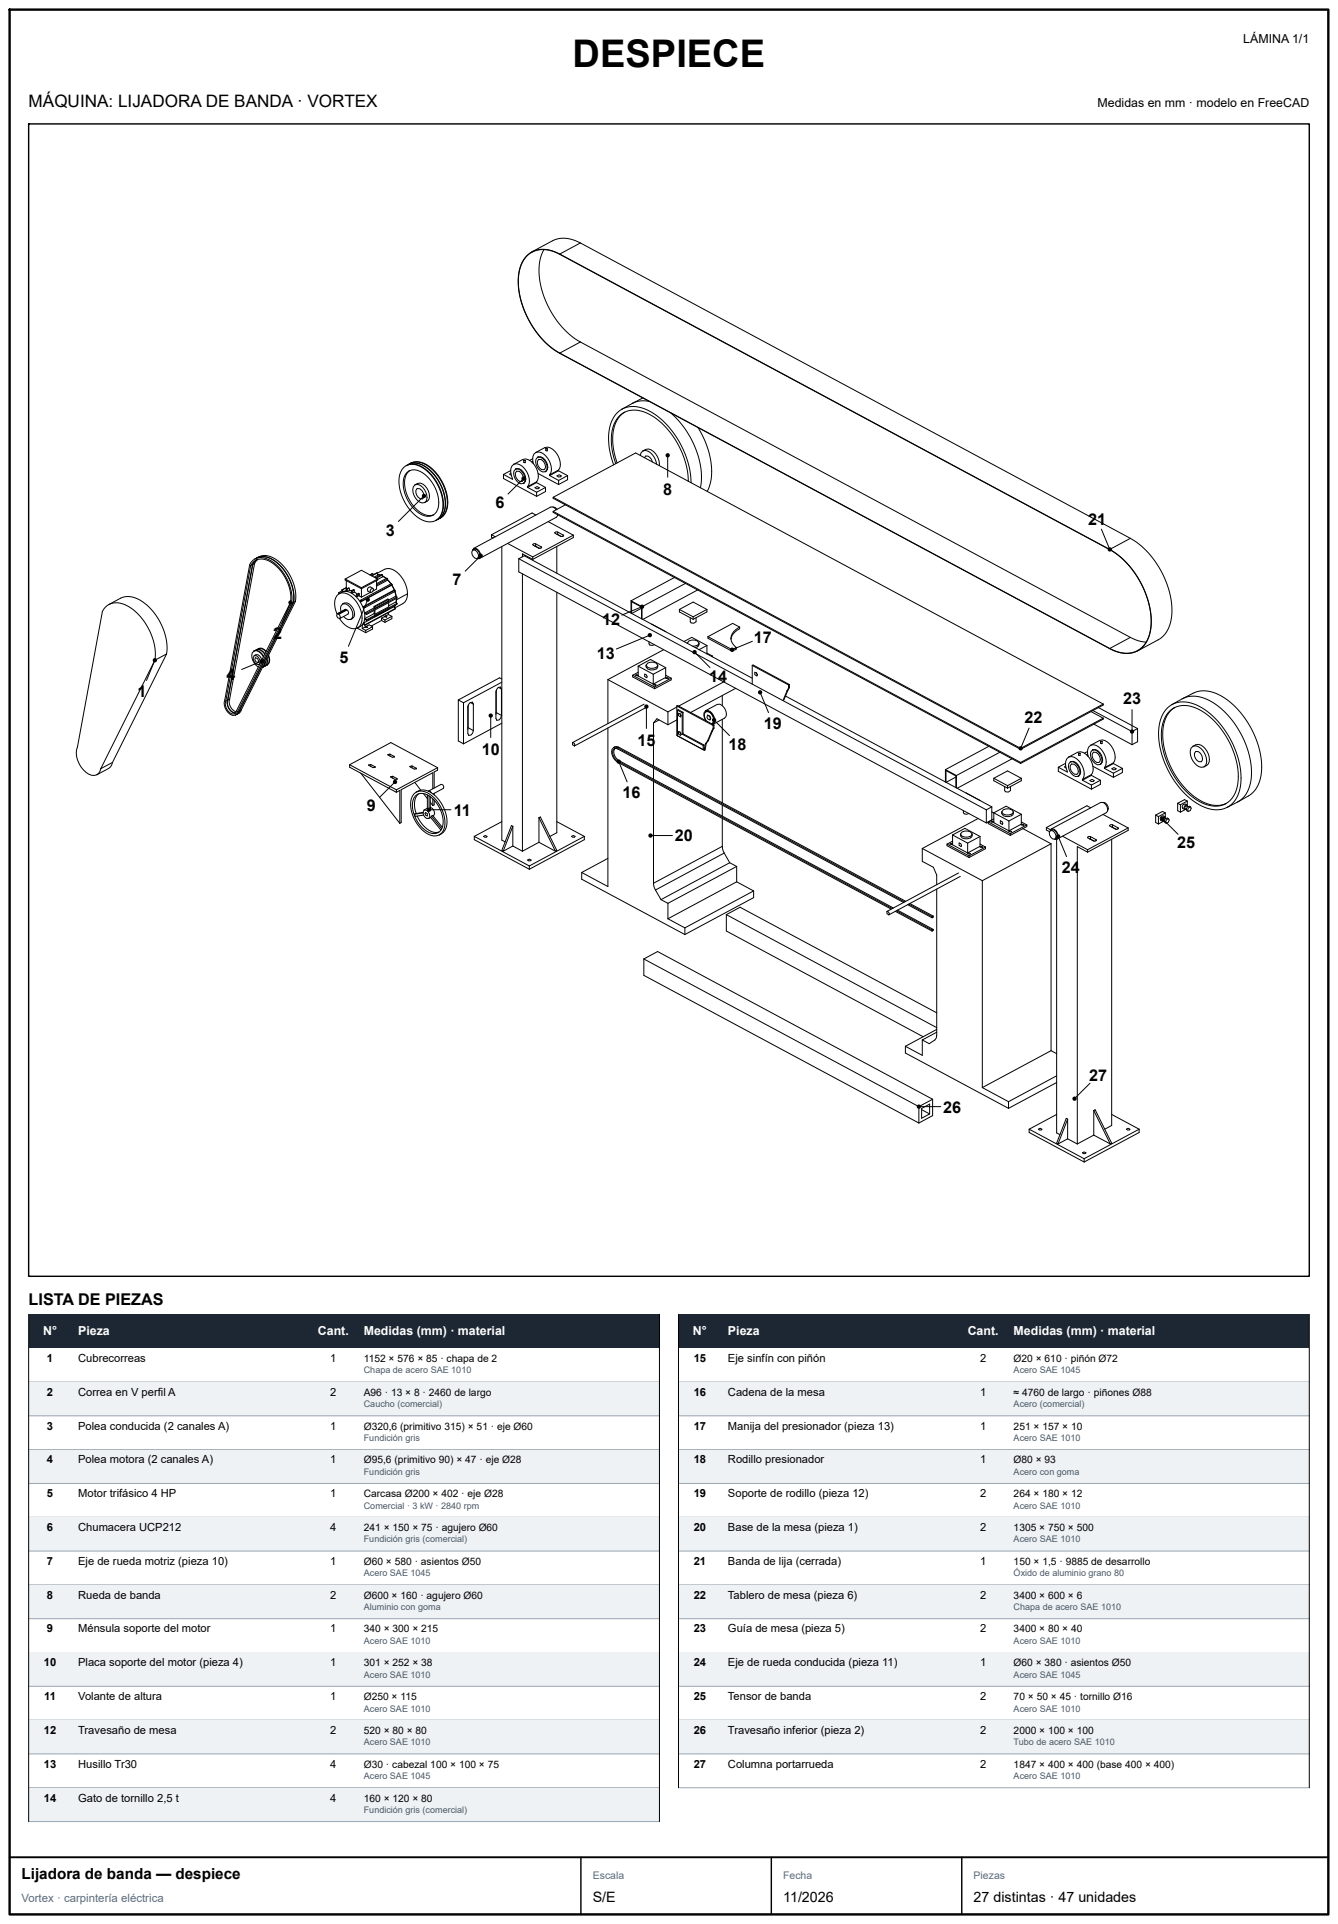
[picture p111: page 1]
LÁMINA 1/1; Pieza; Cant. Medidas (mm) · material; Cubrecorreas; 1152 × 576 × 85 · chapa de 2; Correa en V perfil A; A96 · 13 × 8 · 2460 de largo; Caucho (comercial); Polea conducida (2 canales A); Ø320,6 (primitivo 315) × 51 · eje Ø60; Fundición gris; Polea motora (2 canales A); Ø95,6 (primitivo 90) × 47 · eje Ø28; Motor trifásico 4 HP; Carcasa Ø200 × 402 · eje Ø28; Chumacera UCP212; 241 × 150 × 75 · agujero Ø60; Eje de rueda motriz (pieza 10); Ø60 × 580 · asientos Ø50; Acero SAE 1045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

Medidas en mm · modelo en FreeCAD

LISTA DE PIEZAS

Chapa de acero SAE 1010

Acero con goma

Comercial · 3 kW · 2840 rpm

Fundición gris (comercial)

Óxido de aluminio grano 80

Aluminio con goma

Tubo de acero SAE 1010

Lijadora de banda — despiece

Vortex · carpintería eléctrica
