dicarlantoniooctavio-create/carpinteria-vortex/PRINCIPAL/04_Web/archivos/Multifilar.pdf

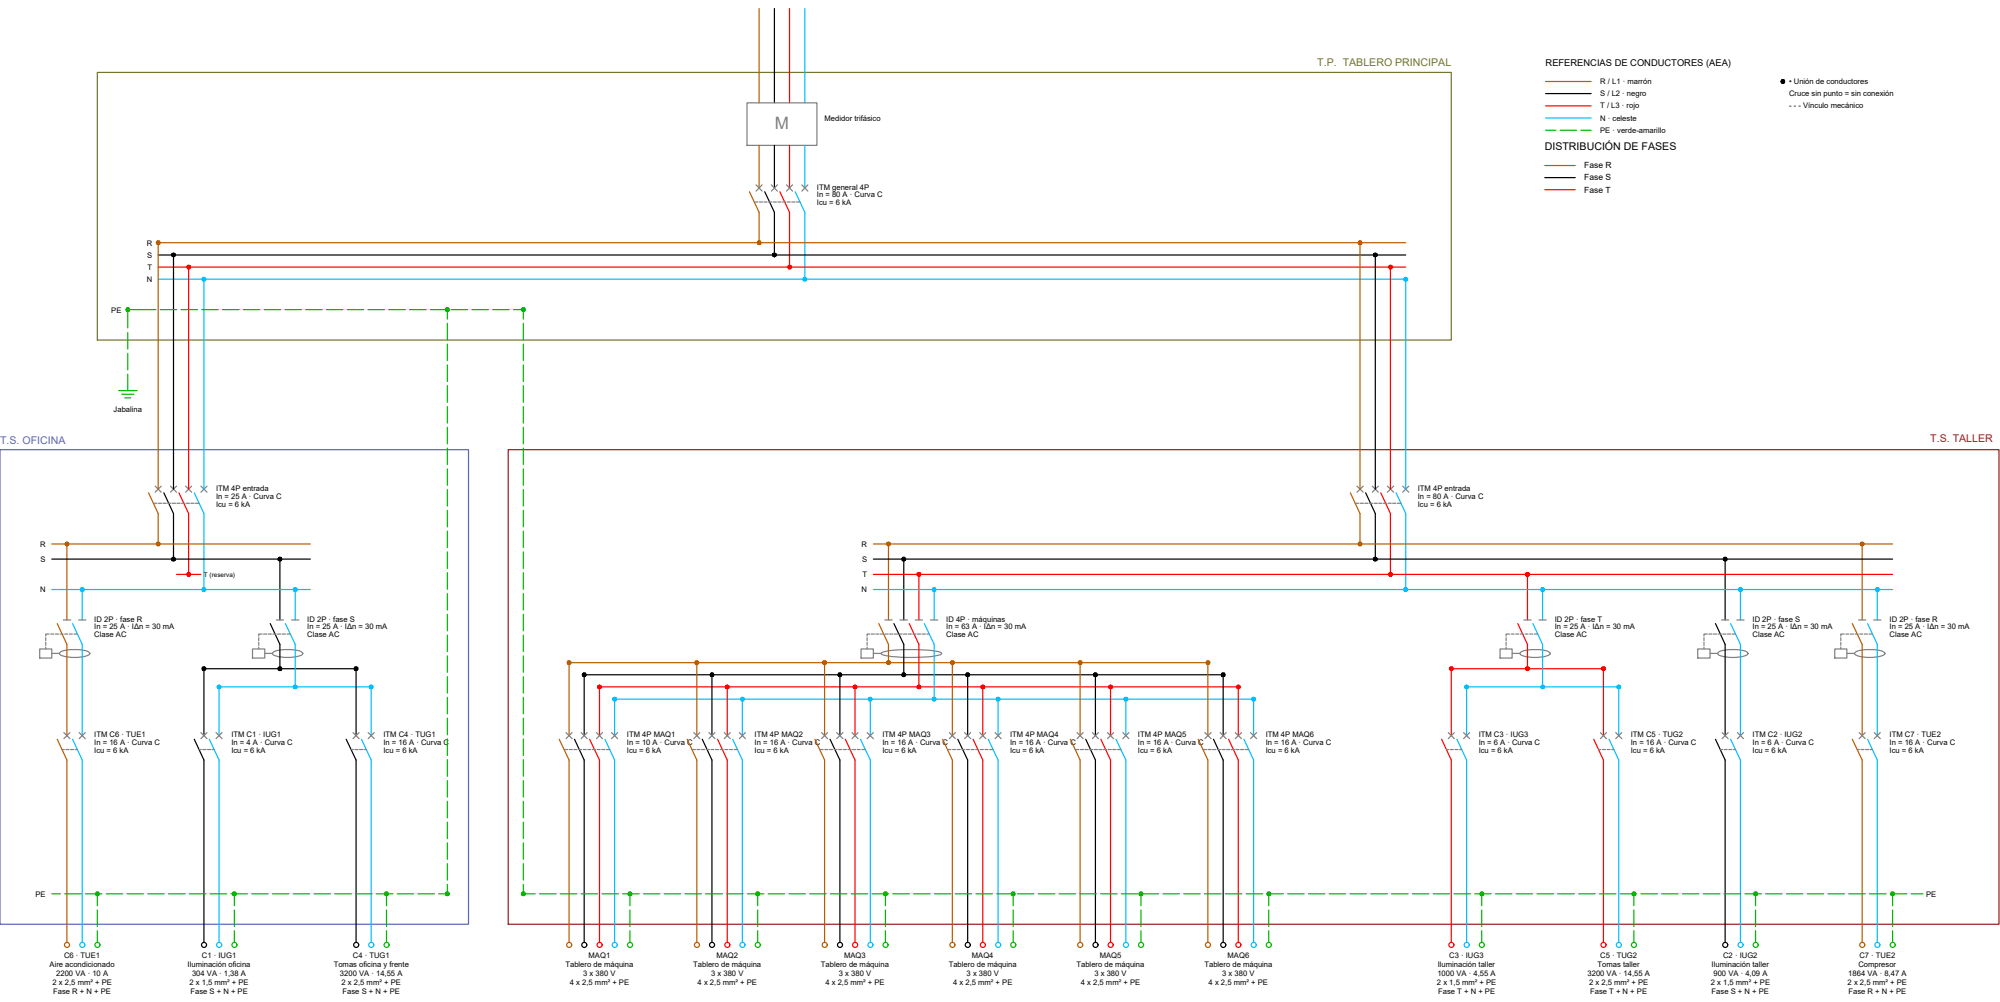
[picture p112: page 1]

REFERENCIAS DE CONDUCTORES (AEA) R / L1 · marrón S / L2 · negro T / L3 · rojo N · celeste PE · verde-amarillo

• Unión de conductores Cruce sin punto = sin conexión

- - - Vínculo mecánico DISTRIBUCIÓN DE FASES

ID 2P · fase R
In = 25 A · IΔn = 30 mA Clase AC

ID 2P · fase S

ID 4P · máquinas
In = 63 A · IΔn = 30 mA Clase AC

ID 2P · fase T
