dicarlantoniooctavio-create/carpinteria-vortex/PRINCIPAL/04_Web/archivos/Unifilar.pdf

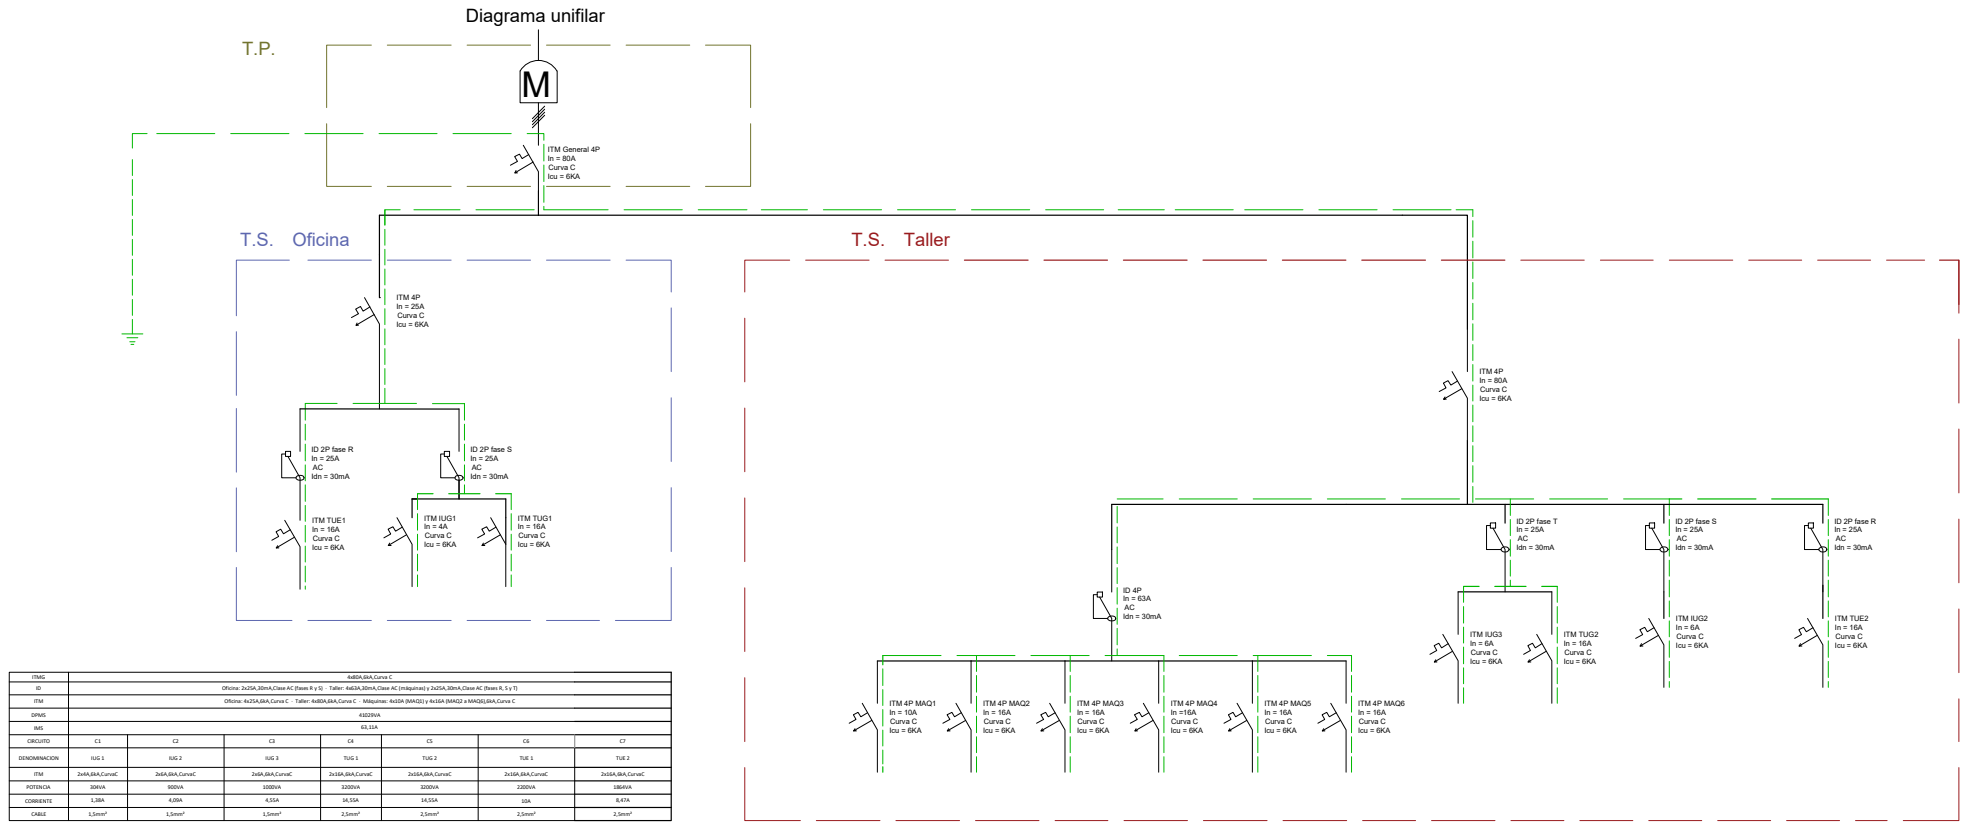
[picture p113: page 1]
Diagrama unifilar; ITM General 4P In = 80A Curva C Icu = 6KA T.S. Oficina; ITM 4P In = 25A Curva C; Icu = 6KA; ITM TUE1 In = 16A Curva C; ID 2P fase R In = 25A; Idn = 30mA; ITM IUG1 In = 4A Curva C; ID 2P fase S In = 25A; ITM TUG1 In = 16A Curva C; ITM 4P In = 80A Curva C; ITM 4P MAQ1 In = 10A Curva C; ITM 4P MAQ2 In = 16A Curva C; ITM 4P MAQ3 In = 16A Curva C; ITM 4P MAQ4 In =16A Curva C; ITM 4P MAQ5 In = 16A Curva C; ITM 4P MAQ6 In = 16A Curva C; ID 2P fase T In = 25A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

ID | 4x80A,6kA,Curva C Oficina: 2x25A,30mA,Clase AC (fases R y S) · Taller: 4x63A,30mA,Clase AC (máquinas) y 2x25A,30mA,Clase AC (fases R, S y T) Oficina: 4x25A,6kA,Curva C · Taller: 4x80A,6kA,Curva C · Máquinas: 4x10A (MAQ1) y 4x16A (MAQ2 a MAQ6),6kA,Curva C
ITMG

ITM

DPMS | 41029VA

IMS CIRCUITO | 63,11A

DENOMINACION | IUG 1 | IUG 2 | IUG 3 | TUG 1 | TUG 2 | TUE 1 | TUE 2

ITM | 2x4A,6kA,CurvaC | 2x6A,6kA,CurvaC | 2x6A,6kA,CurvaC | 2x16A,6kA,CurvaC | 2x16A,6kA,CurvaC | 2x16A,6kA,CurvaC | 2x16A,6kA,CurvaC

POTENCIA | 304VA | 900VA | 1000VA | 3200VA | 3200VA | 2200VA | 1864VA

CORRIENTE CABLE | 1,38A | 4,09A | 4,55A | 14,55A | 14,55A | 10A | 8,47A

1,5mm² | 1,5mm² | 1,5mm² | 2,5mm² | 2,5mm² | 2,5mm² | 2,5mm²
