dicarlantoniooctavio-create/carpinteria-vortex/PRINCIPAL/01_Proyecto_Organizado/modelado-3d/planos/Despiece_Lijadora.pdf

# DESPIECE

## MÁQUINA: LIJADORA DE BANDA · VORTEX

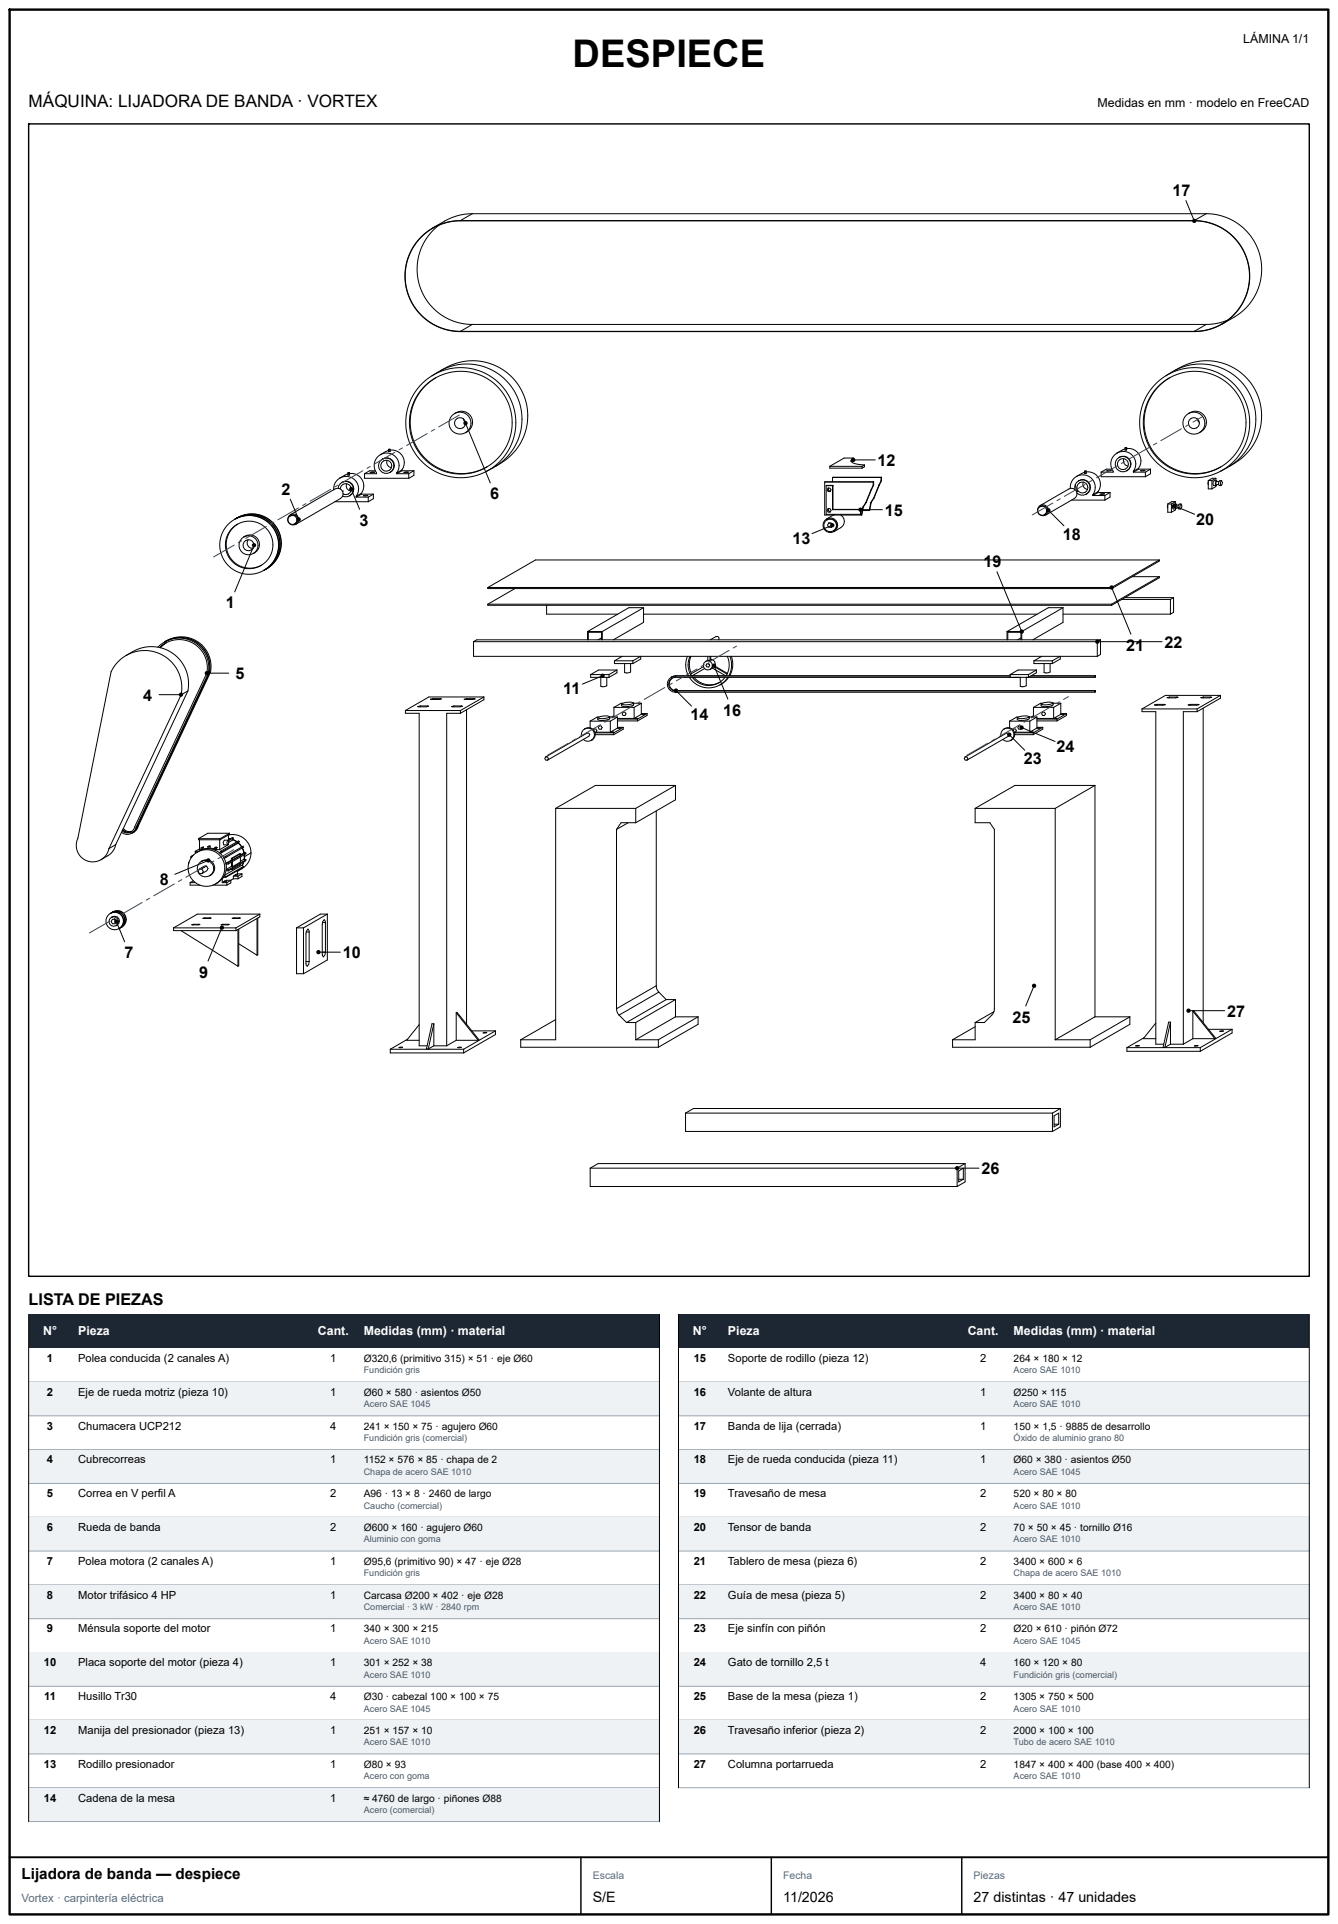
[picture p114: page 1]
LÁMINA 1/1; Pieza; Cant. Medidas (mm) · material; Polea conducida (2 canales A); Ø320,6 (primitivo 315) × 51 · eje Ø60; Fundición gris; Eje de rueda motriz (pieza 10); Ø60 × 580 · asientos Ø50; Acero SAE 1045; Chumacera UCP212; 241 × 150 × 75 · agujero Ø60; Cubrecorreas; 1152 × 576 × 85 · chapa de 2; Correa en V perfil A; A96 · 13 × 8 · 2460 de largo; Caucho (comercial); Rueda de banda; Ø600 × 160 · agujero Ø60; Polea motora (2 canales A); Ø95,6 (primitivo 90) × 47 · eje Ø28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

Medidas en mm · modelo en FreeCAD

LISTA DE PIEZAS

Fundición gris (comercial)

Óxido de aluminio grano 80

Chapa de acero SAE 1010

Aluminio con goma

Comercial · 3 kW · 2840 rpm

Tubo de acero SAE 1010

Acero con goma

Lijadora de banda — despiece

Vortex · carpintería eléctrica
