dicarlantoniooctavio-create/carpinteria-vortex/(commit log)

2026-10-22 Proyecto Vortex: instalación eléctrica de una carpintería
2026-10-22 Unifilar corregido, sin topográficos propios, sección de tableros
2026-10-22 Unifilar: ITM de la oficina en 25 A
2026-10-22 Animaciones: capas del plano, lupa suave e inclinación de los tableros
2026-10-22 Web: sin 'Lo que falta' y dibujos de tableros a todo el ancho
2026-10-22 README: link directo a la web
2026-10-22 Web de la empresa
2026-10-22 Web de la empresa: mail de contacto
2026-10-23 Web de la empresa: organigrama animado con roles nuevos, condiciones en ventana con PDF, planes en dólares y teléfono
2026-10-31 Máquinas del taller, despiece de la lijadora, topográficos y protecciones GE
    - Web, informe y presentación: descripción de las cinco máquinas y despiece mecánico de la lijadora (AutoCAD, con medidas y materiales).
    - Topográficos de los dos seccionales desde CADe SIMU.
    - Compresor 1 de 7,5 HP (11,48 A) y protecciones del catálogo GE (G60, BPC y Hti para los generales de 80 A): fases, unifilar, cómputo y presupuesto actualizados.
2026-10-31 Presentación revisada: datos completos y sin trabajos en curso
    - Presentación: topográficos en lugar de "seguimos trabajando", diapositivas de mantenimiento/HyS y de normas, roles del equipo, numeración de piezas igual al despiece y cierre con lo hecho.
    - Fuera el render del tablero del simulador y la presentación/informe TK-VA desactualizados.
    - Informe, web y README sin pendientes; copias de docs y planillas actualizadas.
2026-11-01 Presentación: cierre breve, sin relleno y con lupa en el unifilar
    - Un solo cierre en lugar de "Cómo nos organizamos" y "Lo que hicimos"; fuera las diapositivas repetidas.
    - El contenido de cada diapositiva llena el alto libre; Iluminación y Mando y potencia reordenadas.
    - KPI de fases corregidos, viñetas, texto de bocas de luz y CSS sin uso.
    - Lupa en unifilar, multifilares, topográficos y despiece (mouse y táctil).
2026-11-02 Iluminación con térmica de 10 A y correcciones de la presentación
    - IUG2 (9 campanas de 100 W, 4,09 A) e IUG3 (10 campanas, 4,55 A) superaban
    la térmica de 4 A: pasan a GE G62C10. IUG1 recalculado (304 W, 1,38 A).
    - Fases con todo andando: R 78,33 A, S 74,88 A, T 73,96 A; potencia
    demandada 33,84 kW e instalada 37,34 kW. Web, presentación, planillas
    y README actualizados.
    - Secciones_y_Circuitos: compresor 1 (5587 W, 11,48 A) y totales al día.
    - Presentación: lupa sin márgenes vacíos y toque largo tolerante,
    ajuste de alto sin observer, precio 13.526,74, barrido del despiece
    dentro de la hoja.
    - Se quita la copia duplicada de la presentación y se regenera
    Vortex_Web.zip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
2026-11-02 Ordenar el repositorio en 1-entrega, 2-proyecto-por-area y 3-originales-del-equipo
    - 1-entrega/: web-proyecto, web-empresa, presentacion, informe,
    perfil-empresa, planillas, video y Vortex_Web.zip (antes PRINCIPAL/02-08).
    - 2-proyecto-por-area/: antes PRINCIPAL/01_Proyecto_Organizado.
    - 3-originales-del-equipo/: modelo-3d-lijadora, planillas, planos y
    tableros-electricos (antes en la raíz).
    - Nombres claros para archivos confusos o sin extensión (multifilares,
    topográficos, tablero de máquina, planos y planillas del equipo).
    - Las rutas viejas de PRINCIPAL/ redirigen a las nuevas para que los
    links ya compartidos sigan andando; sitemap e index.html al día.
    - README raíz con el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
2026-11-02 Volver a la organización anterior del repositorio
    Se deshace el reordenamiento en 1-entrega / 2-proyecto-por-area / 3-originales-del-equipo: carpetas y nombres como estaban. Se conservan los cambios de iluminación y presentación y la planilla de máquinas nueva (en excels.important y en calculos).
2026-11-02 Unifilar sin protecciones de más, topográficos iguales al unifilar y datos de la planilla nueva de máquinas
    - Unifilar: sale el disyuntor 4P de entrada de la oficina y la térmica de grupo de las máquinas
    - Topográficos de Oficina y Máquinas con los mismos aparatos que el unifilar
    - Línea al Seccional Máquinas: 4 x 25 mm² con térmica 4P 63 A
    - Corrientes de máquinas, fases, cables y presupuesto actualizados en web, presentación e informe
    - Presentación con textos revisados y cierre sin listas
2026-11-02 Rubros del presupuesto en la web y planilla de secciones con los datos nuevos
    - Web: barras de materiales por rubro con el cómputo actual y tamaños de descarga
    - Secciones y circuitos: máquinas a 380 V de la planilla nueva, línea al taller 4 x 25 mm² con térmica 63 A
2026-11-02 La dirección principal abre la web de la empresa
2026-11-04 Unifilar: cuadro de circuitos con los 7 circuitos (C1 a C7)
    - Cuadro de abajo del unifilar actualizado con los datos del circuito:
    IUG1, IUG2, IUG3, TUG1, TUG2, TUE1 y TUE2, con ITM, potencia,
    corriente y cable de cada uno.
    - ITMG 4x80A; ID e ITM de los seccionales Oficina y Taller; DPMS 49976VA; IMS 88,35A.
    - Copia en tableros/ y en la web (04_Web/archivos).
2026-11-04 Circuitos: TUG1 único, TUE1 (aire) y TUE2 (compresor)
    - TUG1 junta los tomas de la oficina y del frente (desaparece TUG2); se
    calcula con 3200 W (14,55 A, térmica 16 A).
    - TUE1: aire acondicionado, Seccional Oficina, fase R, 5,00 A.
    - TUE2: compresor 2, Seccional Máquinas, fase R, 8,47 A.
    - Totales: R 53,26 A, S 59,81 A, T 58,89 A; 31,64 kW demandados.
    - Plano DWG con capas TUG1/TUE1/TUE2 y vista PNG nueva.
    - Unifilar: el circuito del fondo vuelve a ser TUG3 y el cuadro queda
    con TUE 1 (1100 VA) y TUE 2 (1864 VA).
    - Archivos CADe SIMU, planillas, web (plano interactivo con capas
    TUE1/TUE2), presentación y README.
2026-11-06 Diseño nuevo del equipo: multifilar único, topográficos de automatismo, lijadora en FreeCAD y presupuesto
    - Unifilar y multifilar del equipo con correcciones: IUG2 e IUG3 con térmica de 6 A, TUE2 solo compresor (1864 VA), DPMS 41.029 VA e IMS 63,11 A.
    - Topográficos de tableros con los circuitos nuevos y topográficos de arranque directo (motor monofásico y trifásico).
    - Compresor 1 calculado en 11,02 A (guardamotor 9-14 A); tupí 5,78 A. Fases R 61,56 / S 63,11 / T 62,19 A.
    - Línea al T.S. Taller en 4 × 35 mm² con entrada de 80 A.
    - Lijadora de banda larga en FreeCAD: renders, lámina de despiece, vistas acotadas en DWG y lista de 27 piezas.
    - Planillas, informe, web, presentació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
2026-11-07 Despiece en diagonal con medidas del modelo, multifilar con su pestaña y lijadora en 3D
    - Despiece de la lijadora estilo diagrama: vista explotada en diagonal, 27 piezas numeradas y lista con las medidas tomadas del modelo de FreeCAD (PDF, PNG y DWG). Vistas acotadas en Vistas_Lijadora.dwg.
    - Web: pestaña Multifilar en tableros; los seccionales muestran su topográfico; textos de entradas y disyuntores corregidos.
    - Automatismo con etiqueta de topográfico trifásico y monofásico.
    - Visor 3D de la lijadora que se gira arrastrando (modelo GLB exportado de FreeCAD).
    - Presentación e informe con el despiece nuevo.
2026-11-07 Web con más animación y despiece con alturas reales
    Despiece de la lijadora rehecho: cada pieza conserva su altura real, las dos ruedas a la misma altura y líneas de eje. Web: frase animada después de La empresa, logo dibujado en la tarjeta de la empresa, sección Diseño 3D y despiece mecánico con pestañas, fondo animado en la portada, carga por fase y enlaces del menú que llegan justo a cada sección. Informe y presentación actualizados.
2026-11-07 Presentación nueva con la estética de la web y datos corregidos
    Presentación de 35 diapositivas con los mismos estilos, animaciones, lupa, pestañas y visor 3D que la web; sin la diapositiva de normas y con cierre de preguntas. Web: datos corregidos según el informe (línea al taller, TUE1/TUE2, compresor 1, colores de fases, capas TUE del plano), zoom del visor con botones, láminas ampliables en celular y arreglos de menú y presupuesto. Informe: rueda Ø600 × 160, IUG3 azul y ejemplo de cañerías.
2026-11-07 Presentación: plano más grande, topográficos de automatismo y despiece en diapositivas propias
2026-11-13 Presentación: lenguaje técnico simple, protecciones bien descriptas y diagrama de fases más grande
2026-11-13 Visor 3D de la lijadora sin internet: copia local de model-viewer y modelo embebido
